w0rxbend/worxboard/pcb/production/left/README.md

# worxboard left half: JLCPCB turnkey order

Generated by `just pcb-production left` from the committed board; do not edit. CI rebuilds these files from the board and fails on any difference.

## Files

| Upload as | File | Contents |
|---|---|---|
| Gerber file | `gerbers.zip` | the panel, 198.84 x 174.75 mm: copper, mask, silk, paste, Edge.Cuts, PTH and NPTH drills |
| BOM file | `bom.csv` | 27 lines, 26 LCSC part numbers, one on every line |
| CPL file | `cpl.csv` | 201 placements, 148 on the bottom, JLC rotations and centroids applied |

`worxboard-left-jlc-order.zip` holds the same three files and this README. `bare-board/` holds the
board without the panel frame, for an order where JLC adds the rails. `pcbway/` holds the files for an
order at PCBWay instead (manufacturer part numbers, KiCad's centroids without JLC's corrections): this
`cpl.csv` misplaces parts anywhere but at JLC.

## The panel

- One board (182.84 x 158.75 mm) in a frame (198.84 x 174.75 mm, inside JLC's 250 x 250 mm Standard PCBA panel limit). The frame is solid: only a 2.0 mm slot round the board is milled out, so the board is held all round.
- Rails 6.0 mm wide or more on every side (JLC: at least 5 mm).
- 16 tabs, each with a row of Ø0.6 mm mouse-bite holes on the board edge, 1.6 mm or more from any part's courtyard and 2.1 mm or more from J1 (USB-C) and J2 (TRRS), whose mouths overhang the edge into the slot.
- 3 fiducials on each side: Ø1.0 mm copper in a Ø2.0 mm mask opening, centres 4.00 mm or more from the panel edges (JLC: 3.85 mm).
- 4 non-plated tooling holes Ø2.0 mm in the rail corners (JLC's SMT guideline of 2026-09: 2 mm; its older FAQ gives 1.152 mm, JLC adds its own if it needs others).
- Panel DRC: 0 errors, 0 unconnected items.

## PCB order form

Option names follow JLC's order form, whose wording changes now and then: pick the closest match.

| Option | Value |
|---|---|
| Base material / layers | FR-4, **4** layers |
| Dimensions | taken from the Gerbers |
| PCB qty | 5 (the minimum) |
| Product type | Industrial/Consumer electronics |
| Delivery format | **Panel by Customer**: one board per panel (1 x 1 if the form asks) |
| PCB thickness | **1.6 mm** |
| Surface finish | **ENIG** |
| Outer copper weight | 1 oz |
| Inner copper weight | 0.5 oz |
| Layer order | F.Cu (L1), In1.Cu (L2, GND plane), In2.Cu (L3, VLED plane), B.Cu (L4) |
| Impedance / stack-up | No requirement; the default JLC04161H-7628 stack-up |
| Via covering | Tented |
| Min via hole size / diameter | 0.3 mm / (0.4/0.45 mm), the default |
| Board outline tolerance | ±0.2 mm |
| Mark on PCB | none |
| Confirm production file | **Yes** |

## PCBA order form

| Option | Value |
|---|---|
| PCBA type | **Standard** (Economic places one side only) |
| Assembly side | **Both sides** |
| PCBA qty | 2 to 5 |
| Tooling holes | **Added by Customer** |
| Edge rails / fiducials | **Added by Customer** |
| Confirm parts placement | **Yes** |
| Depanel / remove edge rails | No (break the tabs yourself, see below) |

J3 (display socket, C27985230) is a through-hole part: JLC solders it by hand, so the quote carries a
small THT fee. Every other part is SMT. J1's four shell legs go through plated slots, but the paste
layer opens them (pin-in-paste), so they reflow with J1's pins; the remark asks for them as well.
Nothing is left for you to solder on the board.

## Remark

Paste this into the order's remark field. It answers what JLC's engineers would otherwise ask about,
and each question puts the order on hold:

> Panel by customer: 1 board in a frame, 6 mm rails, 3 fiducials per side, 4 tooling holes (2.0 mm).
> J1 (USB-C) and J2 (TRRS) overhang the board edge into the milled slot on purpose.
> J1 (USB-C, C165948): please solder its 4 through-hole shell legs (GND) too. The paste layer opens them for pin-in-paste.
> Bottom side: 37 hot-swap sockets SK101-SK137, 37 diodes D101-D137, 37 reverse-mount SK6812MINI-E LEDs LED101-LED137 (body in a PCB cutout, lens through to the top side) and their 100 nF caps C101-C137.
> J3 is a THT socket (hand solder).
> NPTH: 2 pairs of stabiliser clearance holes (STAB_T4/STAB_T5) leave 0.28 mm between them, under the 0.45 mm hole-to-hole spacing.
> Intended: no plating, no copper; they may break into each other.
> Ship with the frame attached.

## Placement preview: what to check

`cpl.csv` was checked by `pcb/scripts/cpl_check.py`, which places JLC's own footprint of every part
(EasyEDA / JLCEDA library) where the CPL puts it and compares it with the KiCad pads; the drawings are
`docs/images/cpl-*.svg`. JLC documents only the top side, so check the bottom side by eye:

- **Bottom, SK101-SK137** (hot-swap sockets): each socket's curved notch wraps the big round
  switch-centre hole, and its two pads sit on the two pads. A socket turned 180° also covers its
  pads but hides the centre hole under its body: rotate it 180° if you see that.
- **Bottom, D101-D137**: the cathode bar on the diode is at pad 1 (the ROW side).
- **Bottom, LED101-LED137** (SK6812MINI-E, reverse mount): the body sits in the rectangular cutout
  5 mm below each switch centre, and pin 1 (GND, the cut corner) is on KiCad pad 1. Each 100 nF
  C101-C137 sits beside its LED.
- **U1** (RP2040): the pin-1 dot at the pin-1 corner of the silkscreen.
- **U2, U3, U4, U5, U6, U7, Y1**: pin 1 on the pin-1 pad (U7 carries its own rotation: its JLC
  footprint has pin 1 in another corner than the other SOT-23-5 parts).
- **J1** (USB-C): the two plastic pegs in the two small holes, the four shell legs in their slots,
  the mouth over the back edge.
- **J2** (TRRS): the two pegs in their holes, the mouth over the bump edge.
- **J3**: on its five holes.

The bottom rows follow the convention KiKit, kicad-jlcpcb-tools and KiBot use for JLC (top-view X/Y,
rotation 180° minus the KiCad angle plus the correction). JLC does not document its bottom side.
A viewer that reads it another way shows one of two patterns:

- **Only the 55 thumb parts C101-C137, D132-D137, LED132-LED137, SK132-SK137 turned by about 50°, 180°, 130°, 50°, 180°, 130°** (the sockets several mm
  off their pads), and every other bottom part right: the viewer turns bottom parts the other
  way round. Parts at 180° look the same either way, so these 55 are the ones to look at.
  They need 360° minus the CPL value: **335°, 270°, 245°, 155°, 90°, 65°** instead of 25°, 90°, 115°, 205°, 270°, 295°.
- **Every socket and diode on the bottom turned 180°:** the viewer mirrors bottom parts about the
  other axis.

In either case, do not edit the files: ask for the correction in the placement confirmation, with
the designators and the rotation they need.

## After delivery

Break the board out of the frame at the mouse-bite tabs and file or sand each tab flush with the
board edge: the case leaves about 0.3 mm round the PCB.

## Checks run on these files

- `pcb/scripts/cpl_check.py`: every placement within 0.1 mm of the best fit of JLC's footprint onto
  the KiCad pads, pin 1 on pin 1, every terminal on its pad, the socket bodies clear of the switch
  holes.
- `pcb/scripts/jlc_check.py`: file formats and headers, BOM and CPL list the same parts, exactly the
  parts design.py fits (JP1, TP*, H*, STAB_* stay out), panel size, rails, fiducials, tooling holes.
  `--stock 5` adds a live JLC stock check; run it on the day you order.
- `pcb/scripts/jlc_check.py facts`: no two pad holes closer than 0.45 mm (JLC's pad
  hole-to-hole spacing) but the stabiliser pairs in the remark.
- KiCad DRC on the panel, and on the board itself in the PCB pipeline.
