w0rxbend/worxboard/pcb/production/left/pcbway/README.md

# worxboard left half: PCBWay turnkey order

Generated by `just pcb-pcbway left` (part of `just pcb-production left`) from the committed board, `pcb/scripts/design.py` and `pcb/scripts/mpn.json`; do not edit. CI rebuilds these files and fails on any difference.

Do **not** upload the JLC files one directory up (`../bom.csv`, `../cpl.csv`) to PCBWay: the CPL carries JLC-only corrections (`pcb/scripts/jlc_rotations.csv`) and JLC's bottom-side rotation, and the BOM only LCSC numbers. Only the Gerbers are shared.

## Files

| PCBWay upload | File | Contents |
|---|---|---|
| Gerber file | [`../gerbers.zip`](../gerbers.zip) | the **panel**, 198.84 x 174.75 mm: the board in a frame with 6 mm rails, 16 mouse-bite tabs, 3 fiducials per side, 4 tooling holes |
| BOM | [`bom.csv`](bom.csv) | 26 lines, 201 parts: manufacturer and part number, description, package, SMD/THT, side, LCSC number as an alternate source |
| Centroid (pick and place) | [`centroid-panel.csv`](centroid-panel.csv) | 201 placements, 148 on the bottom, in the panel Gerbers' frame |

Upload the panel. J1 (USB-C) and J2 (TRRS) overhang the board edge by design, into the frame's 2.0 mm milled slot; the frame carries the rails, fiducials and tooling holes and has no tab in front of either connector. Only if PCBWay refuses the panel, upload [`../bare-board/gerbers.zip`](../bare-board/gerbers.zip) (182.84 x 158.75 mm) with [`centroid-bare-board.csv`](centroid-bare-board.csv), choose Board type **Single pieces**, and ask in the remark for break-away rails with a routed gap and mouse-bites, no V-cut, and no rail or tab in front of J1 and J2.

## Coordinates and rotations

Both centroid files are KiCad's own position file (`kicad-cli pcb export pos --use-drill-file-origin`, millimetres) of the panel and of the board, unchanged but for the column names and the rotation written as 0-360°:

- **Origin:** the drill/place origin, which is the origin of the matching Gerbers: the panel's top-left corner for `centroid-panel.csv`, the board's coordinate origin for `centroid-bare-board.csv`. Y points up, as in the Gerbers, so the Y values are negative.
- **Panel offset:** each panel centroid is the bare-board one moved by (-46.0822, +22.6000) mm, the KiKit panel's offset, read from the panel this stage builds.
- **Mid X / Mid Y** is each footprint's KiCad origin, with no correction. For most parts it is the body centre. Not for these, whose pads are centred this far from the origin: J1 (1.5 mm), J2 (0.9 mm), J3 (5.1 mm), SK101-SK137 (3.9 mm). Place them by their pads.
- **Rotation** is KiCad's footprint angle, counter-clockwise, with KiCad's library footprint as 0°. That is not always the zero orientation of IPC-7351 or of the part on its tape (for J2, J3, SK101-SK137, U2-U7 it is not: JLC's CPL turns them by 90°, 180° or 270°), so align each part with its pads and polarity marks.
- **Bottom side** (Layer `Bottom`): X and Y are seen from the top, through the board (X not negated), in the same frame as the Gerbers. The rotation is KiCad's: seen from the top, the part is its library footprint mirrored top to bottom, then turned counter-clockwise by the Rotation value. Seen from the bottom (the board turned over about its vertical axis), it is the footprint turned counter-clockwise by **180° minus the Rotation value**, the number bottom-view tools such as JLC's use.

## PCB order form

Option names as on PCBWay's form in 2026-11; pick the closest match if they change.

| Option | Value |
|---|---|
| Board type | **Panel by Customer** |
| Panel requirements | Route process **Panel as Tab Route**; X-out allowance **Not Accept**; break-away rail **Yes** (the frame in the Gerbers is the rail); different design in panel **1** |
| Size | 198.84 x 174.75 mm (the panel, from the Gerbers) |
| Quantity | 5 (the minimum) |
| Layers | **4** |
| Material | FR-4, TG 130-140 (the default) |
| Thickness | **1.6 mm** |
| Min track/spacing | **5/5mil** (narrowest track 0.150 mm, clearance rule 0.127 mm) |
| Min hole size | **0.3mm ↑** (smallest drill 0.30 mm) |
| Solder mask | any colour (green is the default) |
| Silkscreen | **White** |
| UV printing (multi-colour) | **None** |
| Edge connector | No |
| Surface finish | **Immersion gold (ENIG)**, 1U" |
| Via process | **Tenting vias** |
| Finished copper | **1 oz Cu** outer, 0.5 oz inner |
| Layer order | F.Cu (L1), In1.Cu (L2, GND plane), In2.Cu (L3, VLED plane), B.Cu (L4); standard stack-up, no impedance control |
| Remove product No. | Yes (extra charge) for no PCBWay number on the board; No lets PCBWay print it |
| Other special request (200 characters at most) | `Panel by customer: 1 board in a frame, tab-route mouse-bites, no V-cut. J1/J2 overhang the board edge into the slot on purpose. Close NPTH stab hole pairs intended. Ship in the frame.` |

## Assembly form

| Option | Value |
|---|---|
| Service type | **Turnkey** |
| Board type | **Panelized PCBs** (Single pieces for the bare board) |
| Assembly side(s) | **Both sides** |
| Quantity | 2 to 5 boards (one board per panel) |
| Accept alternatives/substitutes made in China | Yes, within the substitution rules below |
| Function test / Firmware loading | No / No (the firmware goes on over USB, see the build guide) |
| Number of unique parts | 26 |
| Number of SMD parts | 200 |
| Number of BGA/QFP parts | 1 (U1: QFN-56-1EP_7x7mm_P0.4mm_EP3.2x3.2mm, no BGA) |
| Number of through-hole parts | 1 (J3) |
| Depanel the boards to delivery | **No** (ship in the frame; break the tabs yourself) |

## Remark

Paste this into the assembly order's notes (or send it to the PCBWay engineer who reviews the files). It answers what they would otherwise ask, and each question holds the order:

> Turnkey PCBA, both sides, 201 placements: 53 top, 148 bottom (37 x CL05B104KO5NNNC C101-C137, 37 x 1N4148W D101-D137, 37 x SK6812MINI-E LED101-LED137, 37 x CPG151101S11-16 SK101-SK137).
> Gerbers: 1 board in a customer panel (frame, 6 mm rails, 3 fiducials per side, 4 NPTH tooling holes 2.0 mm, mouse-bite tabs, no V-cut). Ship with the frame attached.
> J1 (USB-C) and J2 (TRRS) overhang the board edge into the milled slot on purpose.
> J3 is the only through-hole part (top side): please hand-solder it.
> J1 (TYPE-C-31-M-12): its 4 plated through-hole legs are opened in the paste layer (pin-in-paste); please solder them too.
> Centroid: KiCad's own position file (footprint origins, KiCad rotations, no offsets added), X/Y in the Gerber frame seen from the top. Bottom-side rotations are KiCad's: seen from the bottom, a part is turned by 180 deg minus the value.
> Please send the placement of both sides (orientation and polarity) for confirmation before production.
> Substitutes: J3: only a 1x5, 2.54 mm pitch, single-row through-hole female header with a 5.0 mm body: the display height in the case depends on it; otherwise ask. Y1: 12MHz, 3225 four-pad, CL 18 pF, ±20 ppm or better; otherwise ask. SK101-SK137: only the second source HanElectricity CPG151101S11-2 (LCSC C49352235), same land pattern; otherwise ask. LED101-LED137: only an SK6812MINI-E (3.2 x 2.8 mm reverse-mount, the same pinout): the PCB cutout and pads are made for it; otherwise ask. C1-C22, C101-C137, F1, R1-R16: any equivalent of the same value, size and rating. D1, D101-D137: the same diode type from another maker, same package, same or better ratings. SW1, SW2: a tact switch on the same TS-1088 land pattern; otherwise ask. No substitute for J1, J2, U1-U7: ask first.
> NPTH: 2 pairs of stabiliser clearance holes (STAB_T4/STAB_T5) leave 0.28 mm between them, under the 0.45 mm hole-to-hole spacing.
> Intended: no plating, no copper; they may break into each other.

## Substitution rules

| Designators | BOM part | Substitute |
|---|---|---|
| C1-C3, C20, C21 | Samsung Electro-Mechanics CL10A106KP8NNNC | any MLCC of the same value, size, dielectric and tolerance, same or higher voltage |
| C4, C18, C19 | Samsung Electro-Mechanics CL05A105KA5NQNC | any MLCC of the same value, size, dielectric and tolerance, same or higher voltage |
| C5, C8-C17, C22, C101-C137 | Samsung Electro-Mechanics CL05B104KO5NNNC | any MLCC of the same value, size, dielectric and tolerance, same or higher voltage |
| C6, C7 | FH 0402CG270J500NT | any MLCC of the same value, size, dielectric and tolerance, same or higher voltage |
| D1 | JSCJ B5819W SL | the same diode type from another maker, same package, same or better ratings |
| D101-D137 | ST(Semtech) 1N4148W | the same diode type from another maker, same package, same or better ratings |
| F1 | TECHFUSE nSMD050-24V | any PTC fuse of the same size and hold current, same or higher voltage |
| J1 | Korean Hroparts Elec TYPE-C-31-M-12 | no substitute: ask first |
| J2 | Korean Hroparts Elec PJ-320D-4A | no substitute: ask first |
| J3 | Hong Cheng HC-PM254-5.0H-1x5PZ | only a 1x5, 2.54 mm pitch, single-row through-hole female header with a **5.0 mm** body: the display height in the case depends on it; otherwise ask |
| LED101-LED137 | OPSCO Optoelectronics SK6812MINI-E | only an SK6812MINI-E (3.2 x 2.8 mm reverse-mount, the same pinout): the PCB cutout and pads are made for it; otherwise ask |
| R1, R2 | UNI-ROYAL 0402WGF5101TCE | any resistor of the same value, size, tolerance and power rating or better |
| R3, R4 | FOJAN FRC0402F27R0TS | any resistor of the same value, size, tolerance and power rating or better |
| R5, R6, R8, R10, R13, R15 | UNI-ROYAL 0402WGF1002TCE | any resistor of the same value, size, tolerance and power rating or better |
| R7, R9 | UNI-ROYAL 0402WGF1001TCE | any resistor of the same value, size, tolerance and power rating or better |
| R11, R12, R16 | UNI-ROYAL 0402WGF4700TCE | any resistor of the same value, size, tolerance and power rating or better |
| R14 | UNI-ROYAL 0402WGF1502TCE | any resistor of the same value, size, tolerance and power rating or better |
| SK101-SK137 | HanElectricity CPG151101S11-16 | only the second source HanElectricity CPG151101S11-2 (LCSC C49352235), same land pattern; otherwise ask |
| SW1, SW2 | XUNPU TS-1088R-02026 | a tact switch on the same TS-1088 land pattern; otherwise ask |
| U1 | Raspberry Pi RP2040 | no substitute: ask first |
| U2 | Winbond W25Q128JVSIQ | no substitute: ask first |
| U3 | DIODES AP2112K-3.3TRG1 | no substitute: ask first |
| U4, U5 | ST USBLC6-2SC6 | no substitute: ask first |
| U6 | Silergy SY6280AAC | no substitute: ask first |
| U7 | TI SN74LV1T34DBVR | no substitute: ask first |
| Y1 | YXC Crystal Oscillators XL2EL89CRI-111YLC-12M | 12MHz, 3225 four-pad, CL 18 pF, ±20 ppm or better; otherwise ask |

## Placement confirmation: what to check

- **Bottom** (C101-C137, D101-D137, LED101-LED137, SK101-SK137): each hot-swap socket's curved notch wraps the round switch-centre hole and its two terminals sit on the two pads; each diode's cathode band is at pad 1 (the ROW side).
- **U1-U7, Y1**: the pin-1 mark (dot, bevel or corner) at pad 1 and the pin-1 mark of the silkscreen; **D1**: the cathode band at pad 1.
- **J1** (USB-C) and **J2** (TRRS): the pegs in their holes, the mouths over the board edge.
- **J3**: on its five holes, on the top side.

## Checks run on these files

- Designators: the 201 parts of the JLC BOM, which are exactly the parts `design.py` fits, each with its LCSC number; every LCSC number in `design.py` has a manufacturer part number in `pcb/scripts/mpn.json` (`pcb/scripts/mpn.py check`).
- Every centroid lies inside the Edge.Cuts of its Gerber set; the panel centroids are the bare-board ones moved by (-46.0822, +22.6000) mm.
- Against the JLC CPL: the 154 parts whose footprint has no row in `pcb/scripts/jlc_rotations.csv` sit where the JLC CPL puts them (within 0.01 mm, worst 0.0067 mm, panel and bare board), and re-applying the row to the other 47 gives the JLC CPL too: the files differ only by JLC's documented corrections and bottom-side rotation.
