w0rxbend/worxboard/pcb/production/left/bare-board/README.md

# worxboard left half: JLCPCB turnkey order (bare board, JLC-added rails)

Generated by `just pcb-production left` from the committed board; do not edit. CI rebuilds these files from the board and fails on any difference.

The bare board (182.84 x 158.75 mm) without rails. Prefer the panel one directory up;
use these only if you want JLC to add the assembly rails and fiducials.

| Upload | File |
|---|---|
| Gerber file | `gerbers.zip` |
| BOM file | `bom.csv` |
| CPL file | `cpl.csv` |

Form differences from the panel order: Delivery format **Single PCB**; Edge rails/fiducials
**Added by JLCPCB**; Tooling holes **Added by JLCPCB**. Paste this as the PCB remark:

> Standard PCBA, both sides. Please add the assembly edge rails with a >= 2 mm routed gap and
> mouse-bite tabs (no V-cut). J1 (USB-C) overhangs the back edge by 0.5 mm and J2 (TRRS) the
> bump edge: no rail or tab in front of J1/J2. Keep tooling holes and fiducials on the rails
> only, no holes inside the board outline. Deliver with rails attached.
> J1 (USB-C, C165948): please solder its 4 through-hole shell legs (GND) too. The paste layer opens them for pin-in-paste.
> NPTH: 2 pairs of stabiliser clearance holes (STAB_T4/STAB_T5) leave 0.28 mm between them, under the 0.45 mm hole-to-hole spacing.
> Intended: no plating, no copper; they may break into each other.

Everything else (settings, preview checks, after delivery) is as in `../README.md`.
