w0rxbend/worxboard/docs/pinout.md

<!-- GENERATED by site/gen_docs.py from layout/build/layout.json, pcb/scripts/design.py and pcb/<side>/worxboard-<side>.kicad_pcb. Do not edit: run `just docs-gen`. -->

# Pinout

The RP2040 GPIO map is identical on both PCBs (spec §3, `layout/pins.py`). Symbol pin **names** are the authority; QFN pin numbers are informational. Electrical context is in [electrical.md](electrical.md), the key matrix in [matrix.md](matrix.md).

## RP2040 pins

| Pin | QFN | Net | Notes |
|---|---|---|---|
| `GPIO0` | 2 | `UART_TX` | UART0 TX -> 1k -> jack |
| `GPIO1` | 3 | `UART_RX` | UART0 RX <- 1k <- jack; 10k pull-up to 3V3 |
| `GPIO2` | 4 | `DISP_SCK` | PIO1 SPI clock |
| `GPIO3` | 5 | `DISP_MOSI` | PIO1 SPI data |
| `GPIO4` | 6 | `DISP_DC` | TP1 (future TFT) |
| `GPIO5` | 7 | `DISP_CS` | display CS, active high |
| `GPIO6` | 8 | `DISP_RST` | TP2 (future TFT) |
| `GPIO7` | 9 | `DISP_BL` | TP3 (future TFT backlight) |
| `GPIO8` | 11 | `ROW0` | matrix row, pull-down |
| `GPIO9` | 12 | `ROW1` | matrix row, pull-down |
| `GPIO10` | 13 | `ROW2` | matrix row, pull-down |
| `GPIO11` | 14 | `ROW3` | matrix row, pull-down |
| `GPIO12` | 15 | `ROW4` | matrix row, pull-down |
| `GPIO13` | 16 | `ROW5` | matrix row, pull-down |
| `GPIO14` | 17 | `COL0` | matrix column |
| `GPIO15` | 18 | `COL1` | matrix column |
| `GPIO16` | 27 | `COL2` | matrix column |
| `GPIO17` | 28 | `COL3` | matrix column |
| `GPIO18` | 29 | `COL4` | matrix column |
| `GPIO19` | 30 | `COL5` | matrix column |
| `GPIO20` | 31 | `COL6` | matrix column |
| `GPIO21` | 32 | `TRRS_DET` | test pad (future detect-gpios) |
| `GPIO22` | 34 | `RGB_DIN` | per-key RGB data (PIO0 WS2812) -> U7 level shifter |
| `GPIO23` | 35 | `RGB_EN` | U6 VLED switch enable, active high, 10k pull-down |
| `GPIO24` | 36 | `TP6` | spare |
| `GPIO25` | 37 | `TP7` | spare |
| `GPIO26/ADC0` | 38 | `VBUS_SENSE` | VBUS 10k/10k divider, unused by rev A |
| `GPIO27/ADC1` | 39 | n/c |  |
| `GPIO28/ADC2` | 40 | n/c |  |
| `GPIO29/ADC3` | 41 | n/c |  |
| `~{QSPI_SS}` | 56 | `QSPI_SS` | flash CS, 10k pull-up; BOOT -> 1k -> GND |
| `RUN` | 26 | `RUN` | 10k pull-up; RESET -> GND |
| `SWCLK` | 24 | `SWCLK` | SWD test pad |
| `SWDIO` | 25 | `SWDIO` | SWD test pad |
| `TESTEN` | 19 | `GND` |  |
| `XIN` | 20 | `XIN` | 12 MHz crystal |
| `XOUT` | 21 | `XOUT` | 1k series to crystal |
| `USB_DM` | 46 | `USB_DM` | 27R series |
| `USB_DP` | 47 | `USB_DP` | 27R series |

## Matrix GPIOs

Rows are inputs with an internal pull-down; columns are outputs (`col2row`). Both PCBs use the same nets. The right half's `.dts` lists the column GPIOs in reverse, so its logical column 0 is the inner column, and `col-offset = <7>` puts it at global column 7.

| Row net | GPIO | QFN |
|---|---|---|
| `ROW0` | GP8 | 11 |
| `ROW1` | GP9 | 12 |
| `ROW2` | GP10 | 13 |
| `ROW3` | GP11 | 14 |
| `ROW4` | GP12 | 15 |
| `ROW5` | GP13 | 16 |

| Col net | Physical column | GPIO | Left logical | Left global | Right logical | Right global |
|---|---|---|---|---|---|---|
| `COL0` | C0 (outer) | GP14 | 0 | 0 | 6 | 13 |
| `COL1` | C1 | GP15 | 1 | 1 | 5 | 12 |
| `COL2` | C2 | GP16 | 2 | 2 | 4 | 11 |
| `COL3` | C3 | GP17 | 3 | 3 | 3 | 10 |
| `COL4` | C4 | GP18 | 4 | 4 | 2 | 9 |
| `COL5` | C5 | GP19 | 5 | 5 | 1 | 8 |
| `COL6` | C6 (inner) | GP20 | 6 | 6 | 0 | 7 |

## TRRS (split link)

UART0, GP0 TX and GP1 RX at 115200 baud, ZMK `zmk,wired-split`. Use a **straight** 4-pole cable: the TX/RX crossover is in the PCB netlist, so the firmware pinctrl is the same on both halves. **Never plug or unplug the TRRS cable while either half is powered.**

| Contact | Left PCB | Right PCB |
|---|---|---|
| Tip | `TRRS_A` = **UART_TX** | `TRRS_A` = **UART_RX** |
| Ring1 | `TRRS_B` = **UART_RX** | `TRRS_B` = **UART_TX** |
| Ring2 | `VLINK` | `VLINK` |
| Sleeve | `GND` | `GND` |

## Display header J3

1×5 2.54 mm female socket, 5.0 mm tall (C27985230), fitted by JLC as a through-hole part. Pin *n* is nice!view pin *n*. Pin 1 (MOSI) is at **high x** in each half's own frame: the **outer** end of the socket on the right half and the **inner** end on the left, because the module is one part mounted LCD up the same way on both halves, header at the back (deviation BOARD-1). `netcmp.py --board` stops stages C and D if J3 is turned the wrong way (deviation ELEC-8; [verification.md](verification.md#g1-niceview-display)).

| Pin | Function | Net | GPIO | Right frame (mm) | Left frame (mm) |
|---|---|---|---|---|---|
| 1 | MOSI | `DISP_MOSI` | GP3 | (77.47, 38.925) | (192.69, 38.925) |
| 2 | SCK | `DISP_SCK` | GP2 | (74.93, 38.925) | (190.15, 38.925) |
| 3 | VCC | `3V3` | — | (72.39, 38.925) | (187.61, 38.925) |
| 4 | GND | `GND` | — | (69.85, 38.925) | (185.07, 38.925) |
| 5 | CS | `DISP_CS` | GP5 | (67.31, 38.925) | (182.53, 38.925) |

## Part positions

Footprint origins as placed in the committed boards (`pcb/<side>/worxboard-<side>.kicad_pcb`), KiCad frame of each half in mm (+y towards the user). The left half is the mirror image (x_L = 260 − x_R) except where the board needed otherwise: the left RP2040 and flash are turned 180° and moved (deviations WS2b-1, WS2b-2), so the passives around them differ too. All of these parts are on the top side. Key sockets and diodes are listed in [matrix.md](matrix.md#sockets-and-diodes).

| Ref | Value | Nets | Left (x, y) rot | Right (x, y) rot |
|---|---|---|---|---|
| `C1` | 10u | `GND`, `VSYS` | (63.9, 44.2) 90° | (196.1, 44.2) 90° |
| `C2` | 10u | `GND`, `VSYS` | (74.27, 44.64) -118.5° | (179.79, 35.7) 90° |
| `C3` | 10u | `3V3`, `GND` | (57.2, 45.2) 90° | (202.8, 45.2) 90° |
| `C4` | 1u | `3V3`, `GND` | (57.2, 48) 90° | (202.8, 48) 90° |
| `C5` | 100n | `3V3`, `GND` | (90, 55.4) 90° | (160.6, 33.2) 90° |
| `C6` | 27p | `GND`, `XIN` | (96.7, 33) -90° | (165, 56.2) 0° |
| `C7` | 27p | `GND`, `XTAL_OUT` | (89.2, 32.6) -90° | (167.2, 56.2) 0° |
| `C8` | 100n | `3V3`, `GND` | (98.85, 46.3) 0° | (160.55, 39.7) 180° |
| `C9` | 100n | `3V3`, `GND` | (98.85, 47.6) 0° | (160.55, 38.4) 180° |
| `C10` | 100n | `3V3`, `GND` | (88.6, 48.08) -90° | (170.8, 37.92) 90° |
| `C11` | 100n | `3V3`, `GND` | (86.1, 44.12) 90° | (173.3, 41.88) -90° |
| `C12` | 100n | `3V3`, `GND` | (84.6, 44.12) 90° | (174.8, 41.88) -90° |
| `C13` | 100n | `3V3`, `GND` | (89.8, 48.08) -90° | (169.6, 37.92) 90° |
| `C14` | 100n | `3V3`, `GND` | (92.2, 48.08) -90° | (167.2, 37.92) 90° |
| `C15` | 100n | `3V3`, `GND` | (91, 48.08) -90° | (168.4, 37.92) 90° |
| `C16` | 100n | `1V1`, `GND` | (94.45, 49.6) -90° | (164.95, 36.4) 90° |
| `C17` | 100n | `1V1`, `GND` | (90.95, 33.6) 90° | (168.45, 52.4) -90° |
| `C18` | 1u | `3V3`, `GND` | (87.6, 44.12) 90° | (171.8, 41.88) -90° |
| `C19` | 1u | `1V1`, `GND` | (93.35, 49.6) -90° | (166.05, 36.4) 90° |
| `C20` | 10u | `GND`, `VLED` | (55.6, 50.6) 90° | (198.4, 50.6) 90° |
| `C21` | 10u | `GND`, `VSYS` | (61.6, 50.6) 90° | (204.4, 50.6) 90° |
| `C22` | 100n | `GND`, `VLED` | (63.51, 51.31) 0° | (187.95, 43.71) 90° |
| `C101` | 100n | `GND`, `VLED` | (73.15, 72.09) 90° | (186.85, 72.09) -90° |
| `C102` | 100n | `GND`, `VLED` | (96.96, 72.09) 90° | (163.04, 72.09) -90° |
| `C103` | 100n | `GND`, `VLED` | (116.01, 68.91) 90° | (143.99, 68.91) -90° |
| `C104` | 100n | `GND`, `VLED` | (135.06, 67.31) 90° | (124.94, 67.31) -90° |
| `C105` | 100n | `GND`, `VLED` | (154.11, 68.91) 90° | (105.89, 68.91) -90° |
| `C106` | 100n | `GND`, `VLED` | (173.16, 70.18) 90° | (86.84, 70.18) -90° |
| `C107` | 100n | `GND`, `VLED` | (183.01, 93.99) -90° | (76.99, 93.99) 90° |
| `C108` | 100n | `GND`, `VLED` | (163.96, 89.23) -90° | (96.04, 89.23) 90° |
| `C109` | 100n | `GND`, `VLED` | (144.91, 87.96) -90° | (115.09, 87.96) 90° |
| `C110` | 100n | `GND`, `VLED` | (125.86, 86.36) -90° | (134.14, 86.36) 90° |
| `C111` | 100n | `GND`, `VLED` | (106.81, 87.96) -90° | (153.19, 87.96) 90° |
| `C112` | 100n | `GND`, `VLED` | (87.76, 91.13) -90° | (172.24, 91.13) 90° |
| `C113` | 100n | `GND`, `VLED` | (63.95, 91.13) -90° | (186.85, 91.13) -90° |
| `C114` | 100n | `GND`, `VLED` | (73.15, 110.18) 90° | (186.85, 110.18) -90° |
| `C115` | 100n | `GND`, `VLED` | (96.96, 110.18) 90° | (163.04, 110.18) -90° |
| `C116` | 100n | `GND`, `VLED` | (116.01, 107.01) 90° | (143.99, 107.01) -90° |
| `C117` | 100n | `GND`, `VLED` | (135.06, 105.41) 90° | (124.94, 105.41) -90° |
| `C118` | 100n | `GND`, `VLED` | (154.11, 107.01) 90° | (105.89, 107.01) -90° |
| `C119` | 100n | `GND`, `VLED` | (173.16, 108.28) 90° | (86.84, 108.28) -90° |
| `C120` | 100n | `GND`, `VLED` | (183.01, 122.57) -90° | (76.99, 122.57) 90° |
| `C121` | 100n | `GND`, `VLED` | (163.96, 127.33) -90° | (96.04, 127.33) 90° |
| `C122` | 100n | `GND`, `VLED` | (144.91, 126.06) -90° | (115.09, 126.06) 90° |
| `C123` | 100n | `GND`, `VLED` | (125.86, 124.46) -90° | (134.14, 124.46) 90° |
| `C124` | 100n | `GND`, `VLED` | (106.81, 126.06) -90° | (153.19, 126.06) 90° |
| `C125` | 100n | `GND`, `VLED` | (87.76, 129.23) -90° | (172.24, 129.23) 90° |
| `C126` | 100n | `GND`, `VLED` | (63.95, 129.23) -90° | (186.85, 129.23) -90° |
| `C127` | 100n | `GND`, `VLED` | (77.91, 148.28) 90° | (182.09, 148.28) -90° |
| `C128` | 100n | `GND`, `VLED` | (96.96, 148.28) 90° | (163.04, 148.28) -90° |
| `C129` | 100n | `GND`, `VLED` | (116.01, 145.11) 90° | (143.99, 145.11) -90° |
| `C130` | 100n | `GND`, `VLED` | (135.06, 143.51) 90° | (124.94, 143.51) -90° |
| `C131` | 100n | `GND`, `VLED` | (154.11, 145.11) 90° | (105.89, 145.11) -90° |
| `C132` | 100n | `GND`, `VLED` | (180.72, 159.61) 65° | (79.28, 159.61) -65° |
| `C133` | 100n | `GND`, `VLED` | (197.98, 167.67) 65° | (62.02, 167.67) -65° |
| `C134` | 100n | `GND`, `VLED` | (211.22, 184.35) 65° | (57.12, 180.46) 115° |
| `C135` | 100n | `GND`, `VLED` | (219.27, 167.08) 65° | (49.06, 163.19) 115° |
| `C136` | 100n | `GND`, `VLED` | (218.99, 145.93) -115° | (41.01, 145.93) 115° |
| `C137` | 100n | `GND`, `VLED` | (201.72, 137.88) -115° | (58.28, 137.88) 115° |
| `D1` | B5819W | `VBUS`, `VSYS` | (66.4, 44.2) 90° | (193.6, 44.2) 90° |
| `F1` | 500mA | `VLINK`, `VLINK_JP` | (67.2, 52.8) 180° | (192.8, 52.8) 0° |
| `J1` | TYPE-C-31-M-12 | `CC1`, `CC2`, `GND`, `USB_C_DM`, `USB_C_DP`, `VBUS` | (74, 34.25) 180° | (186, 34.25) 180° |
| `J2` | PJ-320D-4A | `GND`, `TRRS_A`, `TRRS_B`, `VLINK` | (202.62, 103) 180° | (57.38, 103) 0° |
| `J3` | HC-PM254-5.0H-1x5PZ | `3V3`, `DISP_CS`, `DISP_MOSI`, `DISP_SCK`, `GND` | (192.69, 38.92) -90° | (77.47, 38.92) -90° |
| `JP1` | VLINK | `VLINK_JP`, `VSYS` | (73.4, 51.6) 180° | (186.6, 51.6) 0° |
| `LED101` | SK6812MINI-E | `GND`, `RGB_D101`, `RGB_D102`, `VLED` | (68.55, 72.09) 0° | (191.45, 72.09) 180° |
| `LED102` | SK6812MINI-E | `GND`, `RGB_D102`, `RGB_D103`, `VLED` | (92.36, 72.09) 0° | (167.64, 72.09) 180° |
| `LED103` | SK6812MINI-E | `GND`, `RGB_D103`, `RGB_D104`, `VLED` | (111.41, 68.91) 0° | (148.59, 68.91) 180° |
| `LED104` | SK6812MINI-E | `GND`, `RGB_D104`, `RGB_D105`, `VLED` | (130.46, 67.31) 0° | (129.54, 67.31) 180° |
| `LED105` | SK6812MINI-E | `GND`, `RGB_D105`, `RGB_D106`, `VLED` | (149.51, 68.91) 0° | (110.49, 68.91) 180° |
| `LED106` | SK6812MINI-E | `GND`, `RGB_D106`, `RGB_D107`, `VLED` | (168.56, 70.18) 0° | (91.44, 70.18) 180° |
| `LED107` | SK6812MINI-E | `GND`, `RGB_D107`, `RGB_D108`, `VLED` | (187.61, 93.99) 180° | (72.39, 93.99) 0° |
| `LED108` | SK6812MINI-E | `GND`, `RGB_D108`, `RGB_D109`, `VLED` | (168.56, 89.23) 180° | (91.44, 89.23) 0° |
| `LED109` | SK6812MINI-E | `GND`, `RGB_D109`, `RGB_D110`, `VLED` | (149.51, 87.96) 180° | (110.49, 87.96) 0° |
| `LED110` | SK6812MINI-E | `GND`, `RGB_D110`, `RGB_D111`, `VLED` | (130.46, 86.36) 180° | (129.54, 86.36) 0° |
| `LED111` | SK6812MINI-E | `GND`, `RGB_D111`, `RGB_D112`, `VLED` | (111.41, 87.96) 180° | (148.59, 87.96) 0° |
| `LED112` | SK6812MINI-E | `GND`, `RGB_D112`, `RGB_D113`, `VLED` | (92.36, 91.13) 180° | (167.64, 91.13) 0° |
| `LED113` | SK6812MINI-E | `GND`, `RGB_D113`, `RGB_D114`, `VLED` | (68.55, 91.13) 180° | (191.45, 91.13) 180° |
| `LED114` | SK6812MINI-E | `GND`, `RGB_D114`, `RGB_D115`, `VLED` | (68.55, 110.18) 0° | (191.45, 110.18) 180° |
| `LED115` | SK6812MINI-E | `GND`, `RGB_D115`, `RGB_D116`, `VLED` | (92.36, 110.18) 0° | (167.64, 110.18) 180° |
| `LED116` | SK6812MINI-E | `GND`, `RGB_D116`, `RGB_D117`, `VLED` | (111.41, 107.01) 0° | (148.59, 107.01) 180° |
| `LED117` | SK6812MINI-E | `GND`, `RGB_D117`, `RGB_D118`, `VLED` | (130.46, 105.41) 0° | (129.54, 105.41) 180° |
| `LED118` | SK6812MINI-E | `GND`, `RGB_D118`, `RGB_D119`, `VLED` | (149.51, 107.01) 0° | (110.49, 107.01) 180° |
| `LED119` | SK6812MINI-E | `GND`, `RGB_D119`, `RGB_D120`, `VLED` | (168.56, 108.28) 0° | (91.44, 108.28) 180° |
| `LED120` | SK6812MINI-E | `GND`, `RGB_D120`, `RGB_D121`, `VLED` | (187.61, 122.57) 180° | (72.39, 122.57) 0° |
| `LED121` | SK6812MINI-E | `GND`, `RGB_D121`, `RGB_D122`, `VLED` | (168.56, 127.33) 180° | (91.44, 127.33) 0° |
| `LED122` | SK6812MINI-E | `GND`, `RGB_D122`, `RGB_D123`, `VLED` | (149.51, 126.06) 180° | (110.49, 126.06) 0° |
| `LED123` | SK6812MINI-E | `GND`, `RGB_D123`, `RGB_D124`, `VLED` | (130.46, 124.46) 180° | (129.54, 124.46) 0° |
| `LED124` | SK6812MINI-E | `GND`, `RGB_D124`, `RGB_D125`, `VLED` | (111.41, 126.06) 180° | (148.59, 126.06) 0° |
| `LED125` | SK6812MINI-E | `GND`, `RGB_D125`, `RGB_D126`, `VLED` | (92.36, 129.23) 180° | (167.64, 129.23) 0° |
| `LED126` | SK6812MINI-E | `GND`, `RGB_D126`, `RGB_D127`, `VLED` | (68.55, 129.23) 180° | (191.45, 129.23) 180° |
| `LED127` | SK6812MINI-E | `GND`, `RGB_D127`, `RGB_D128`, `VLED` | (73.31, 148.28) 0° | (186.69, 148.28) 180° |
| `LED128` | SK6812MINI-E | `GND`, `RGB_D128`, `RGB_D129`, `VLED` | (92.36, 148.28) 0° | (167.64, 148.28) 180° |
| `LED129` | SK6812MINI-E | `GND`, `RGB_D129`, `RGB_D130`, `VLED` | (111.41, 145.11) 0° | (148.59, 145.11) 180° |
| `LED130` | SK6812MINI-E | `GND`, `RGB_D130`, `RGB_D131`, `VLED` | (130.46, 143.51) 0° | (129.54, 143.51) 180° |
| `LED131` | SK6812MINI-E | `GND`, `RGB_D131`, `RGB_D132`, `VLED` | (149.51, 145.11) 0° | (110.49, 145.11) 180° |
| `LED132` | SK6812MINI-E | `GND`, `RGB_D132`, `RGB_D133`, `VLED` | (176.55, 157.67) -25° | (83.45, 157.67) -155° |
| `LED133` | SK6812MINI-E | `GND`, `RGB_D133`, `RGB_D134`, `VLED` | (193.81, 165.72) -25° | (66.19, 165.72) -155° |
| `LED134` | SK6812MINI-E | `GND`, `RGB_D134`, `RGB_D135`, `VLED` | (207.05, 182.4) -25° | (52.95, 182.4) 25° |
| `LED135` | SK6812MINI-E | `GND`, `RGB_D135`, `RGB_D136`, `VLED` | (215.1, 165.14) -25° | (44.9, 165.14) 25° |
| `LED136` | SK6812MINI-E | `GND`, `RGB_D136`, `RGB_D137`, `VLED` | (223.15, 147.87) 155° | (36.85, 147.87) 25° |
| `LED137` | SK6812MINI-E | `GND`, `RGB_D137`, `VLED` | (205.89, 139.82) 155° | (54.11, 139.82) 25° |
| `R1` | 5.1k | `CC1`, `GND` | (80.5, 39.6) 0° | (189.4, 42.4) 90° |
| `R2` | 5.1k | `CC2`, `GND` | (70.2, 43.4) 0° | (183.4, 43.2) 0° |
| `R3` | 27 | `USB_C_DP`, `USB_DP` | (86.9, 47.12) 0° | (172.5, 38.88) 180° |
| `R4` | 27 | `USB_C_DM`, `USB_DM` | (86.9, 46.08) 0° | (172.5, 39.92) 180° |
| `R5` | 10k | `VBUS`, `VBUS_SENSE` | (69.4, 47.6) 90° | (190.6, 47.6) 90° |
| `R6` | 10k | `GND`, `VBUS_SENSE` | (69.4, 50.4) 90° | (190.6, 50.4) 90° |
| `R7` | 1k | `XOUT`, `XTAL_OUT` | (92, 33.6) -90° | (167.4, 52.4) 90° |
| `R8` | 10k | `3V3`, `QSPI_SS` | (89, 52.6) 90° | (147, 33.4) 90° |
| `R9` | 1k | `BOOT`, `QSPI_SS` | (87.8, 52.6) 90° | (145.8, 33.4) 90° |
| `R10` | 10k | `3V3`, `RUN` | (77.4, 47.6) 90° | (182.6, 47.6) 90° |
| `R11` | 470 | left `TRRS_A`, `UART_TX`; right `TRRS_A`, `UART_RX` | (198.6, 94.8) 90° | (61.4, 94.8) 90° |
| `R12` | 470 | left `TRRS_B`, `UART_RX`; right `TRRS_B`, `UART_TX` | (200.2, 94.8) 90° | (59.8, 94.8) 90° |
| `R13` | 10k | `3V3`, `UART_RX` | (115, 46) 180° | (145, 46) 0° |
| `R14` | 15k | `GND`, `VLED_ISET` | (57.2, 54) 0° | (200, 54) 0° |
| `R15` | 10k | `GND`, `RGB_EN` | (60.2, 54) 0° | (203, 54) 0° |
| `R16` | 470 | `RGB_BUF`, `RGB_D101` | (63.65, 46.64) 0° | (189, 49.4) 90° |
| `SW1` | BOOT | `BOOT`, `GND` | (84, 50) 90° | (176, 50) 90° |
| `SW2` | RESET | `GND`, `RUN` | (80, 50) 90° | (180, 50) 90° |
| `TP1` | DISP_DC | `DISP_DC` | (178.4, 44.4) 180° | (81.6, 44.4) 0° |
| `TP2` | DISP_RST | `DISP_RST` | (176.2, 44.4) 180° | (83.8, 44.4) 0° |
| `TP3` | DISP_BL | `DISP_BL` | (174, 44.4) 180° | (86, 44.4) 0° |
| `TP6` | TP6 | `TP6` | (81, 36) 0° | (177.6, 55.5) 0° |
| `TP7` | TP7 | `TP7` | (83.2, 36) 0° | (179.8, 55.5) 0° |
| `TP8` | SWCLK | `SWCLK` | (87.6, 34) 0° | (182, 55.5) 0° |
| `TP9` | SWDIO | `SWDIO` | (87.6, 36.2) 0° | (184.2, 55.5) 0° |
| `TP10` | GND | `GND` | (85.4, 36.2) 0° | (186.4, 55.5) 0° |
| `TP11` | TRRS_DET | `TRRS_DET` | (81, 33.8) 0° | (171, 55.5) 0° |
| `U1` | RP2040 | [RP2040 pins](#rp2040-pins) | (93.4, 42) 180° | (166, 44) 0° |
| `U2` | W25Q128JVSIQ | `3V3`, `GND`, `QSPI_SCLK`, `QSPI_SD0`, `QSPI_SD1`, `QSPI_SD2`, `QSPI_SD3`, `QSPI_SS` | (96, 53.7) 180° | (154.6, 35) 0° |
| `U3` | AP2112K-3.3 | `3V3`, `GND`, `VSYS` | (60.4, 46.4) 180° | (199.6, 46.4) 0° |
| `U4` | USBLC6-2SC6 | `GND`, `USB_C_DM`, `USB_C_DP`, `VSYS` | (78.04, 42.49) 151.5° | (177.5, 39.4) 0° |
| `U5` | USBLC6-2SC6 | `GND`, `TRRS_A`, `TRRS_B`, `VLINK` | (204.6, 94.6) 180° | (55.4, 94.6) 0° |
| `U6` | SY6280AAC | `GND`, `RGB_EN`, `VLED`, `VLED_ISET`, `VSYS` | (58.6, 51.2) 0° | (201.4, 51.2) 0° |
| `U7` | SN74LV1T34DBVR | `GND`, `RGB_BUF`, `RGB_DIN`, `VLED` | (65.6, 49) 180° | (186.8, 46.6) 0° |
| `Y1` | 12MHz | `GND`, `XIN`, `XTAL_OUT` | (94.47, 33.1) 90° | (164.93, 52.9) -90° |

## Mounting holes

M2.5 NPTH Ø2.7, copper and component keepout Ø6.5. Hole 7 moved from the stock ErgoDox position to make room for the display.

| # | PCB ref | Left | Right |
|---|---|---|---|
| 0 | `H1` | (206.101, 165.837) | (53.899, 165.837) |
| 1 | `H2` | (200.335, 121.666) | (59.665, 121.666) |
| 2 | `H3` | (154.565, 157.759) | (105.435, 157.759) |
| 3 | `H4` | (58.222, 140.056) | (201.778, 140.056) |
| 4 | `H5` | (120.96, 91.592) | (139.04, 91.592) |
| 5 | `H6` | (58.857, 37.135) | (201.143, 37.135) |
| 6 | `H7` | (141.788, 37.135) | (118.212, 37.135) |
| 7 | `H8` | (172, 37.135) | (88, 37.135) |
