w0rxbend/worxboard/case/production/jlccnc/worxboard_left_bottom.pdf

VIEW FROM BELOW ( Z), outside (cosmetic) face | scale 1:1
ID | Feature | X | Y | Note
C1 | Ø2.9 THRU, 90° CSK Ø5.2 | 76.10 | -65.84 | M2.5x12 countersunk screw into T1
C2 | Ø2.9 THRU, 90° CSK Ø5.2 | 70.34 | -21.67 | M2.5x12 countersunk screw into T2
C3 | Ø2.9 THRU, 90° CSK Ø5.2 | 24.56 | -57.76 | M2.5x12 countersunk screw into T3
C4 | Ø2.9 THRU, 90° CSK Ø5.2 | -71.78 | -40.06 | M2.5x12 countersunk screw into T4
C5 | Ø2.9 THRU, 90° CSK Ø5.2 | -9.04 | 8.41 | M2.5x12 countersunk screw into T5
C6 | Ø2.9 THRU, 90° CSK Ø5.2 | -71.14 | 62.87 | M2.5x12 countersunk screw into T6

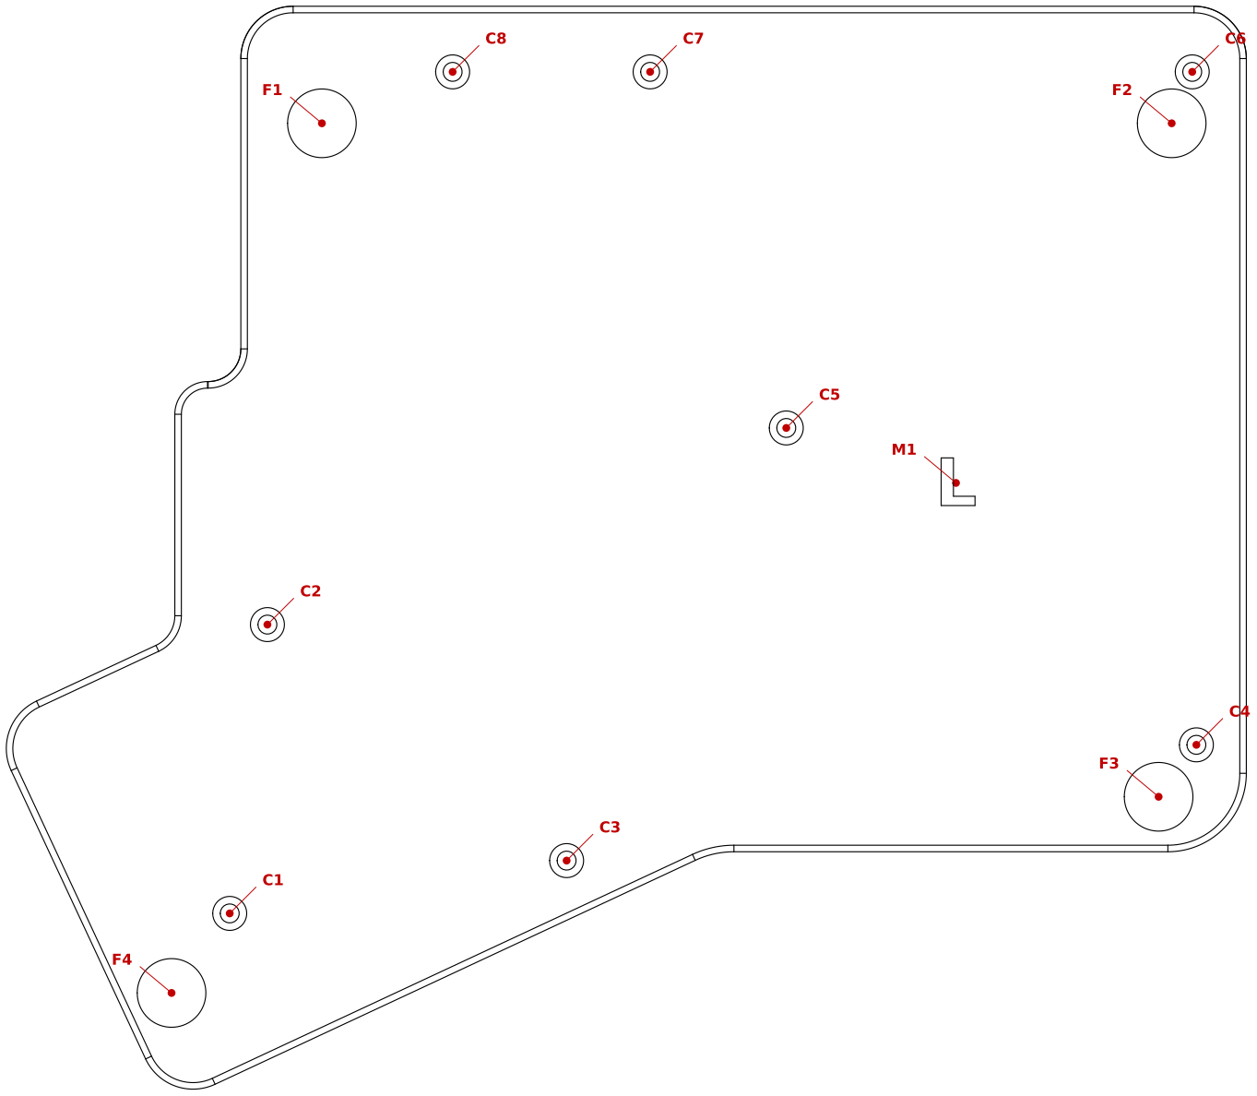
[picture p18: figure]

C7 | Ø2.9 THRU, 90° CSK Ø5.2 | 11.79 | 62.87 | M2.5x12 countersunk screw into T7
C8 | Ø2.9 THRU, 90° CSK Ø5.2 | 42.00 | 62.87 | M2.5x12 countersunk screw into T8
F1 | Ø10.5 x 0.6 deep recess | 62.00 | 55.00 | rubber foot
F2 | Ø10.5 x 0.6 deep recess | -68.00 | 55.00 | rubber foot
F3 | Ø10.5 x 0.6 deep recess | -66.00 | -48.00 | rubber foot
F4 | Ø10.5 x 0.6 deep recess | 85.00 | -78.00 | rubber foot
M1 | engraved 'L', 10 high x 0.4 deep | -35.00 | -0.00 | side mark, reads from below

X/Y in STEP coordinates; features are on the underside (Z = 0).

## GENERAL NOTES

1. Geometry per worxboard_left_bottom.step. Dimensions not shown are taken from the STEP model.
2. Material: Aluminium 6061-T6 (7075-T6 acceptable).
3. NO THREADS in this part. C1-C8: clearance holes with 90° countersink for M2.5 ISO 10642 / DIN 7991 style countersunk screws; heads must sit flush or up to 0.2 below the underside.
4. The USB-C slot of the top part continues 0.8 mm into the back wall of this part, through the wall, 13.0 +0.2/0 wide
| (see STEP). M1: engraved side mark, cosmetic.
5. FIT-CRITICAL, tighter than the general tolerance: C1-C8 positions ±0.1 hole to hole (they match T1-T8 of the top part and the PCB's holes). The tops of the 8 posts round C1-C8 and the parting face (top of the wall) lie in one plane within 0.05: the PCB rests on the posts, the top part on the wall. Overall size 189.7 x 165.6 x 7.0 (reference).
6. Dimensions and tolerances apply AFTER finishing. Anodizing rack / contact marks on inside (non-cosmetic) faces only.
7. Internal corners: boss-web fillets R1.0 (4.0 deep, R = depth/10 + 0.5); tray corners R2 and larger.
8. This is a LEFT-hand part: a mirror image of the right-hand part.
9. Cosmetic surfaces: underside and outer walls: no tool marks, scratches or clamp marks. Inside (pocket) surfaces are
| non-cosmetic.
10. Break sharp edges 0.1-0.2 mm unless modelled.
11. Finish: Fine bead blast + anodize Type II, colour per order.

# worxboard CNC aluminium case

worxboard_left_bottom | https://github.com/w0rxbend/worxboard

### Drawing no.: WXB-BOTTOM-L

Material: Aluminium 6061-T6 (7075-T6 acceptable)

Finish: Fine bead blast + anodize Type II, colour per order

### Sheet 1 of 1

Scale 1:1

Units: mm

Revision A5 Date 2026-11-12

General tolerance ISO 2768-mK unless noted. Threads ISO metric, RIGHT-HAND, 6H.

The STEP file governs geometry; this drawing governs threads, tolerances, finish.

Do not scale drawing
