w0rxbend/worxboard/case/production/jlccnc/worxboard_leg.pdf

## VIEW A bearing face ( Z), scale 2.5:1

Ø10.4 -0.1

38.5

43.5

Ø6.0

Ø4.5

7.5

Pivot axis = origin of the STEP model. Arm along +Y, bearing face at Z = 0.

## VIEW B side (+X), scale 2.5:1, hidden lines dashed

8.0

6.0

bearing face

Ø10.4

Ø3.4 thru

### DETAIL D bearing face, scale 6:1 (FLAT, NO TEETH)

counterbore Ø6.5 x 4.0
deep, from the back face
(dashed, hidden)

Bearing face

Bearing face | Z = 0, FLAT, no teeth, Ø3.4 to Ø10.4. Flatness 0.05, perpendicular to the bore within 0.05. Ra 1.6 max
Function | clamped against the flat case boss (drawing WXB-TOP sheet 2) by the M3 spring thumbscrew; the leg holds its angle by friction
Feature | Specification
Hub | Ø10.4 -0.1 x 8.0 long (face to back face), back edge chamfer 0.3x45°
Bore | Ø3.4 +0.1/0 THROUGH (M3 clearance, NO THREAD), on the pivot axis
Counterbore | Ø6.5 +0.1/0 x 4.0 deep from the back face (spring seat)
Arm | 7.5 wide at hub tapering to 6.0, 6.0 thick, flush with the back face, long edges R1.5, joint to the hub R1.5
Neck / spigot | Ø6.0 to 38.5 from axis; spigot Ø4.5 -0.05 x 5.0 for the foot cap, end chamfer 0.4
Length | 43.5 axis to spigot end; 47 to foot tip with cap

### GENERAL NOTES

1. Geometry per worxboard_leg.step. Dimensions not shown are taken from the STEP model.
2. Material: Aluminium 6061-T6 (7075-T6 acceptable). QUANTITY: 6 pcs (3 per keyboard half; identical, not handed).
3. NO THREADS in this part. An M3 thumbscrew passes through the Ø3.4 bore into the M3 thread of the case boss (its reach past the boss face is limited per drawing WXB-TOP sheet 2).
4. Bearing face: flat, no burrs, no raised tool marks.
5. Break sharp edges 0.1-0.2 mm.
6. Finish: Fine bead blast + anodize Type II, colour per order; same colour as the case. Dimensions and tolerances apply AFTER finishing. Anodizing rack / contact marks on inside (non-cosmetic) faces only.
7. Foot caps are not machined: worxboard_leg_cap_tree (8 TPU 95A caps on one runner, 3D-printed), snipped off and pushed onto the spigot.

# worxboard CNC aluminium case

worxboard_leg | https://github.com/w0rxbend/worxboard

### Drawing no.: WXB-LEG

Material: Aluminium 6061-T6 (7075-T6 acceptable)

Finish: Fine bead blast + anodize Type II, colour per order

### Sheet 1 of 1

Scale 2.5:1, 6:1

Units: mm

Revision A5 Date 2026-11-12

General tolerance ISO 2768-mK unless noted. Threads ISO metric, RIGHT-HAND, 6H.

The STEP file governs geometry; this drawing governs threads, tolerances, finish.

Do not scale drawing
