w0rxbend/worxboard/docs/matrix.md

<!-- GENERATED by site/gen_docs.py from layout/build/layout.json, pcb/scripts/design.py and pcb/<side>/worxboard-<side>.kicad_pcb. Do not edit: run `just docs-gen`. -->

# Key matrix

Each half has a 6 × 7 diode matrix, `col2row`: the diode anode is on the switch/column side and the cathode on the ROW net. Diodes are 1N4148W (SOD-123) on the bottom side next to each hot-swap socket. Both PCBs share **one** matrix netlist: `COLn` is physical column Cn (C0 outer, C6 inner) on both halves.

- Keys per half: **37**, total **74**.
- Slot (R0, C6) is the display on both halves and is not mapped.
- Legends are the ZMK base layer (QMK `ergodox_ez` layer 0; LEFT/RGHT moved to layer 1).

## Left half (physical)

Cells show the key id, its legend and the global ZMK position `RC(row, col)`.

| Row \ Col | `COL0` GP14 | `COL1` GP15 | `COL2` GP16 | `COL3` GP17 | `COL4` GP18 | `COL5` GP19 | `COL6` GP20 |
|---|---|---|---|---|---|---|---|
| `ROW0` GP8 | C0R0 `=` (0,0) | C1R0 `1` (0,1) | C2R0 `2` (0,2) | C3R0 `3` (0,3) | C4R0 `4` (0,4) | C5R0 `5` (0,5) | **DISPLAY** |
| `ROW1` GP9 | C0R1 `DEL` (1,0) | C1R1 `Q` (1,1) | C2R1 `W` (1,2) | C3R1 `E` (1,3) | C4R1 `R` (1,4) | C5R1 `T` (1,5) | C6R1 `TG(1)` (1,6) |
| `ROW2` GP10 | C0R2 `BSPC` (2,0) | C1R2 `A` (2,1) | C2R2 `S` (2,2) | C3R2 `D` (2,3) | C4R2 `F` (2,4) | C5R2 `G` (2,5) | — |
| `ROW3` GP11 | C0R3 `LSFT` (3,0) | C1R3 `CTL_T(Z)` (3,1) | C2R3 `X` (3,2) | C3R3 `C` (3,3) | C4R3 `V` (3,4) | C5R3 `B` (3,5) | C6R2 `HYPER` (3,6) |
| `ROW4` GP12 | C0R4 `` LT(1,`) `` (4,0) | C1R4 `'` (4,1) | C2R4 `LA(LSFT)` (4,2) | C3R4 `LEFT` (4,3) | C4R4 `RGHT` (4,4) | — | — |
| `ROW5` GP13 | — | T5 `SPC` (5,1) | T4 `BSPC` (5,2) | T3 `END` (5,3) | T2 `HOME` (5,4) | T1 `ALT_T(APP)` (5,5) | T0 `LGUI` (5,6) |

## Right half (physical)

Cells show the key id, its legend and the global ZMK position `RC(row, col)`.

| Row \ Col | `COL0` GP14 | `COL1` GP15 | `COL2` GP16 | `COL3` GP17 | `COL4` GP18 | `COL5` GP19 | `COL6` GP20 |
|---|---|---|---|---|---|---|---|
| `ROW0` GP8 | C0R0 `-` (0,13) | C1R0 `0` (0,12) | C2R0 `9` (0,11) | C3R0 `8` (0,10) | C4R0 `7` (0,9) | C5R0 `6` (0,8) | **DISPLAY** |
| `ROW1` GP9 | C0R1 `\` (1,13) | C1R1 `P` (1,12) | C2R1 `O` (1,11) | C3R1 `I` (1,10) | C4R1 `U` (1,9) | C5R1 `Y` (1,8) | C6R1 `TG(1)` (1,7) |
| `ROW2` GP10 | C0R2 `GUI_T(')` (2,13) | C1R2 `LT(2,;)` (2,12) | C2R2 `L` (2,11) | C3R2 `K` (2,10) | C4R2 `J` (2,9) | C5R2 `H` (2,8) | — |
| `ROW3` GP11 | C0R3 `RSFT` (3,13) | C1R3 `CTL_T(/)` (3,12) | C2R3 `.` (3,11) | C3R3 `,` (3,10) | C4R3 `M` (3,9) | C5R3 `N` (3,8) | C6R2 `MEH` (3,7) |
| `ROW4` GP12 | C0R4 `TT(1)` (4,13) | C1R4 `]` (4,12) | C2R4 `[` (4,11) | C3R4 `DOWN` (4,10) | C4R4 `UP` (4,9) | — | — |
| `ROW5` GP13 | — | T5 `ENT` (5,12) | T4 `TAB` (5,11) | T3 `PGDN` (5,10) | T2 `PGUP` (5,9) | T1 `CTL_T(ESC)` (5,8) | T0 `LALT` (5,7) |

## ZMK transform (6 × 14)

The global map the keymap and ZMK Studio see. Left columns 0–6 are physical C0–C6; right columns 7–13 are physical C6–C0 (the right `.dts` reverses `col-gpios` and sets `col-offset = <7>`).

| Row | 0 | 1 | 2 | 3 | 4 | 5 | 6 | 7 | 8 | 9 | 10 | 11 | 12 | 13 |
|---|---|---|---|---|---|---|---|---|---|---|---|---|---|---|
| 0 | `=` | `1` | `2` | `3` | `4` | `5` | LCD | LCD | `6` | `7` | `8` | `9` | `0` | `-` |
| 1 | `DEL` | `Q` | `W` | `E` | `R` | `T` | `TG(1)` | `TG(1)` | `Y` | `U` | `I` | `O` | `P` | `\` |
| 2 | `BSPC` | `A` | `S` | `D` | `F` | `G` | · | · | `H` | `J` | `K` | `L` | `LT(2,;)` | `GUI_T(')` |
| 3 | `LSFT` | `CTL_T(Z)` | `X` | `C` | `V` | `B` | `HYPER` | `MEH` | `N` | `M` | `,` | `.` | `CTL_T(/)` | `RSFT` |
| 4 | `` LT(1,`) `` | `'` | `LA(LSFT)` | `LEFT` | `RGHT` | · | · | · | · | `UP` | `DOWN` | `[` | `]` | `TT(1)` |
| 5 | · | `SPC` | `BSPC` | `END` | `HOME` | `ALT_T(APP)` | `LGUI` | `LALT` | `CTL_T(ESC)` | `PGUP` | `PGDN` | `TAB` | `ENT` | · |

## Sockets and diodes

Each key has a Kailh hot-swap socket `SK` and a diode `D` on the bottom side, numbered from 101 in `layout` key order (deviation WS2a-1). The references are the same on both PCBs; the diode anode is on the switch net `MX_<key>`, the cathode on the row.

| Key | Socket | Diode | Row | Column | Left legend | Right legend |
|---|---|---|---|---|---|---|
| C0R0 | `SK101` | `D101` | `ROW0` | `COL0` | `=` | `-` |
| C1R0 | `SK102` | `D102` | `ROW0` | `COL1` | `1` | `0` |
| C2R0 | `SK103` | `D103` | `ROW0` | `COL2` | `2` | `9` |
| C3R0 | `SK104` | `D104` | `ROW0` | `COL3` | `3` | `8` |
| C4R0 | `SK105` | `D105` | `ROW0` | `COL4` | `4` | `7` |
| C5R0 | `SK106` | `D106` | `ROW0` | `COL5` | `5` | `6` |
| C0R1 | `SK107` | `D107` | `ROW1` | `COL0` | `DEL` | `\` |
| C1R1 | `SK108` | `D108` | `ROW1` | `COL1` | `Q` | `P` |
| C2R1 | `SK109` | `D109` | `ROW1` | `COL2` | `W` | `O` |
| C3R1 | `SK110` | `D110` | `ROW1` | `COL3` | `E` | `I` |
| C4R1 | `SK111` | `D111` | `ROW1` | `COL4` | `R` | `U` |
| C5R1 | `SK112` | `D112` | `ROW1` | `COL5` | `T` | `Y` |
| C6R1 | `SK113` | `D113` | `ROW1` | `COL6` | `TG(1)` | `TG(1)` |
| C0R2 | `SK114` | `D114` | `ROW2` | `COL0` | `BSPC` | `GUI_T(')` |
| C1R2 | `SK115` | `D115` | `ROW2` | `COL1` | `A` | `LT(2,;)` |
| C2R2 | `SK116` | `D116` | `ROW2` | `COL2` | `S` | `L` |
| C3R2 | `SK117` | `D117` | `ROW2` | `COL3` | `D` | `K` |
| C4R2 | `SK118` | `D118` | `ROW2` | `COL4` | `F` | `J` |
| C5R2 | `SK119` | `D119` | `ROW2` | `COL5` | `G` | `H` |
| C0R3 | `SK120` | `D120` | `ROW3` | `COL0` | `LSFT` | `RSFT` |
| C1R3 | `SK121` | `D121` | `ROW3` | `COL1` | `CTL_T(Z)` | `CTL_T(/)` |
| C2R3 | `SK122` | `D122` | `ROW3` | `COL2` | `X` | `.` |
| C3R3 | `SK123` | `D123` | `ROW3` | `COL3` | `C` | `,` |
| C4R3 | `SK124` | `D124` | `ROW3` | `COL4` | `V` | `M` |
| C5R3 | `SK125` | `D125` | `ROW3` | `COL5` | `B` | `N` |
| C6R2 | `SK126` | `D126` | `ROW3` | `COL6` | `HYPER` | `MEH` |
| C0R4 | `SK127` | `D127` | `ROW4` | `COL0` | `` LT(1,`) `` | `TT(1)` |
| C1R4 | `SK128` | `D128` | `ROW4` | `COL1` | `'` | `]` |
| C2R4 | `SK129` | `D129` | `ROW4` | `COL2` | `LA(LSFT)` | `[` |
| C3R4 | `SK130` | `D130` | `ROW4` | `COL3` | `LEFT` | `DOWN` |
| C4R4 | `SK131` | `D131` | `ROW4` | `COL4` | `RGHT` | `UP` |
| T0 | `SK132` | `D132` | `ROW5` | `COL6` | `LGUI` | `LALT` |
| T1 | `SK133` | `D133` | `ROW5` | `COL5` | `ALT_T(APP)` | `CTL_T(ESC)` |
| T2 | `SK134` | `D134` | `ROW5` | `COL4` | `HOME` | `PGUP` |
| T3 | `SK135` | `D135` | `ROW5` | `COL3` | `END` | `PGDN` |
| T4 | `SK136` | `D136` | `ROW5` | `COL2` | `BSPC` | `TAB` |
| T5 | `SK137` | `D137` | `ROW5` | `COL1` | `SPC` | `ENT` |

## Keymap order

Bindings in `worxboard.keymap`, the transform `map` and the physical layout all follow this order (12 / 14 / 12 / 14 / 10, then the thumbs).

| # | Half | Key | Position | Legend | x (mm) | y (mm) | rot (°) | Size (u) |
|---|---|---|---|---|---|---|---|---|
| 0 | left | C0R0 | RC(0,0) | `=` | 68.5475 | 67.0052 | 0 | 1.5×1 |
| 1 | left | C1R0 | RC(0,1) | `1` | 92.36 | 67.0052 | 0 | 1×1 |
| 2 | left | C2R0 | RC(0,2) | `2` | 111.41 | 63.8277 | 0 | 1×1 |
| 3 | left | C3R0 | RC(0,3) | `3` | 130.46 | 62.23 | 0 | 1×1 |
| 4 | left | C4R0 | RC(0,4) | `4` | 149.51 | 63.8277 | 0 | 1×1 |
| 5 | left | C5R0 | RC(0,5) | `5` | 168.56 | 65.1002 | 0 | 1×1 |
| 6 | right | C5R0 | RC(0,8) | `6` | 91.44 | 65.1002 | 0 | 1×1 |
| 7 | right | C4R0 | RC(0,9) | `7` | 110.49 | 63.8277 | 0 | 1×1 |
| 8 | right | C3R0 | RC(0,10) | `8` | 129.54 | 62.23 | 0 | 1×1 |
| 9 | right | C2R0 | RC(0,11) | `9` | 148.59 | 63.8277 | 0 | 1×1 |
| 10 | right | C1R0 | RC(0,12) | `0` | 167.64 | 67.0052 | 0 | 1×1 |
| 11 | right | C0R0 | RC(0,13) | `-` | 191.4525 | 67.0052 | 0 | 1.5×1 |
| 12 | left | C0R1 | RC(1,0) | `DEL` | 68.5475 | 86.0527 | 0 | 1.5×1 |
| 13 | left | C1R1 | RC(1,1) | `Q` | 92.36 | 86.0527 | 0 | 1×1 |
| 14 | left | C2R1 | RC(1,2) | `W` | 111.41 | 82.8777 | 0 | 1×1 |
| 15 | left | C3R1 | RC(1,3) | `E` | 130.46 | 81.28 | 0 | 1×1 |
| 16 | left | C4R1 | RC(1,4) | `R` | 149.51 | 82.8777 | 0 | 1×1 |
| 17 | left | C5R1 | RC(1,5) | `T` | 168.56 | 84.1477 | 0 | 1×1 |
| 18 | left | C6R1 | RC(1,6) | `TG(1)` | 187.61 | 88.9102 | 0 | 1×1.5 |
| 19 | right | C6R1 | RC(1,7) | `TG(1)` | 72.39 | 88.9102 | 0 | 1×1.5 |
| 20 | right | C5R1 | RC(1,8) | `Y` | 91.44 | 84.1477 | 0 | 1×1 |
| 21 | right | C4R1 | RC(1,9) | `U` | 110.49 | 82.8777 | 0 | 1×1 |
| 22 | right | C3R1 | RC(1,10) | `I` | 129.54 | 81.28 | 0 | 1×1 |
| 23 | right | C2R1 | RC(1,11) | `O` | 148.59 | 82.8777 | 0 | 1×1 |
| 24 | right | C1R1 | RC(1,12) | `P` | 167.64 | 86.0527 | 0 | 1×1 |
| 25 | right | C0R1 | RC(1,13) | `\` | 191.4525 | 86.0527 | 0 | 1.5×1 |
| 26 | left | C0R2 | RC(2,0) | `BSPC` | 68.5475 | 105.1027 | 0 | 1.5×1 |
| 27 | left | C1R2 | RC(2,1) | `A` | 92.36 | 105.1027 | 0 | 1×1 |
| 28 | left | C2R2 | RC(2,2) | `S` | 111.41 | 101.9277 | 0 | 1×1 |
| 29 | left | C3R2 | RC(2,3) | `D` | 130.46 | 100.33 | 0 | 1×1 |
| 30 | left | C4R2 | RC(2,4) | `F` | 149.51 | 101.9277 | 0 | 1×1 |
| 31 | left | C5R2 | RC(2,5) | `G` | 168.56 | 103.1977 | 0 | 1×1 |
| 32 | right | C5R2 | RC(2,8) | `H` | 91.44 | 103.1977 | 0 | 1×1 |
| 33 | right | C4R2 | RC(2,9) | `J` | 110.49 | 101.9277 | 0 | 1×1 |
| 34 | right | C3R2 | RC(2,10) | `K` | 129.54 | 100.33 | 0 | 1×1 |
| 35 | right | C2R2 | RC(2,11) | `L` | 148.59 | 101.9277 | 0 | 1×1 |
| 36 | right | C1R2 | RC(2,12) | `LT(2,;)` | 167.64 | 105.1027 | 0 | 1×1 |
| 37 | right | C0R2 | RC(2,13) | `GUI_T(')` | 191.4525 | 105.1027 | 0 | 1.5×1 |
| 38 | left | C0R3 | RC(3,0) | `LSFT` | 68.5475 | 124.1527 | 0 | 1.5×1 |
| 39 | left | C1R3 | RC(3,1) | `CTL_T(Z)` | 92.36 | 124.1527 | 0 | 1×1 |
| 40 | left | C2R3 | RC(3,2) | `X` | 111.41 | 120.9777 | 0 | 1×1 |
| 41 | left | C3R3 | RC(3,3) | `C` | 130.46 | 119.38 | 0 | 1×1 |
| 42 | left | C4R3 | RC(3,4) | `V` | 149.51 | 120.9777 | 0 | 1×1 |
| 43 | left | C5R3 | RC(3,5) | `B` | 168.56 | 122.2477 | 0 | 1×1 |
| 44 | left | C6R2 | RC(3,6) | `HYPER` | 187.61 | 117.4852 | 0 | 1×1.5 |
| 45 | right | C6R2 | RC(3,7) | `MEH` | 72.39 | 117.4852 | 0 | 1×1.5 |
| 46 | right | C5R3 | RC(3,8) | `N` | 91.44 | 122.2477 | 0 | 1×1 |
| 47 | right | C4R3 | RC(3,9) | `M` | 110.49 | 120.9777 | 0 | 1×1 |
| 48 | right | C3R3 | RC(3,10) | `,` | 129.54 | 119.38 | 0 | 1×1 |
| 49 | right | C2R3 | RC(3,11) | `.` | 148.59 | 120.9777 | 0 | 1×1 |
| 50 | right | C1R3 | RC(3,12) | `CTL_T(/)` | 167.64 | 124.1527 | 0 | 1×1 |
| 51 | right | C0R3 | RC(3,13) | `RSFT` | 191.4525 | 124.1527 | 0 | 1.5×1 |
| 52 | left | C0R4 | RC(4,0) | `` LT(1,`) `` | 73.31 | 143.2027 | 0 | 1×1 |
| 53 | left | C1R4 | RC(4,1) | `'` | 92.36 | 143.2027 | 0 | 1×1 |
| 54 | left | C2R4 | RC(4,2) | `LA(LSFT)` | 111.41 | 140.0277 | 0 | 1×1 |
| 55 | left | C3R4 | RC(4,3) | `LEFT` | 130.46 | 138.43 | 0 | 1×1 |
| 56 | left | C4R4 | RC(4,4) | `RGHT` | 149.51 | 140.0277 | 0 | 1×1 |
| 57 | right | C4R4 | RC(4,9) | `UP` | 110.49 | 140.0277 | 0 | 1×1 |
| 58 | right | C3R4 | RC(4,10) | `DOWN` | 129.54 | 138.43 | 0 | 1×1 |
| 59 | right | C2R4 | RC(4,11) | `[` | 148.59 | 140.0277 | 0 | 1×1 |
| 60 | right | C1R4 | RC(4,12) | `]` | 167.64 | 143.2027 | 0 | 1×1 |
| 61 | right | C0R4 | RC(4,13) | `TT(1)` | 186.69 | 143.2027 | 0 | 1×1 |
| 62 | left | T1 | RC(5,5) | `ALT_T(APP)` | 208.0367 | 135.2194 | -25 | 1×1 |
| 63 | left | T0 | RC(5,6) | `LGUI` | 225.3011 | 143.2687 | -25 | 1×1 |
| 64 | right | T0 | RC(5,7) | `LALT` | 34.6989 | 143.2687 | 25 | 1×1 |
| 65 | right | T1 | RC(5,8) | `CTL_T(ESC)` | 51.9633 | 135.2194 | 25 | 1×1 |
| 66 | left | T2 | RC(5,4) | `HOME` | 217.2518 | 160.5331 | -25 | 1×1 |
| 67 | right | T2 | RC(5,9) | `PGUP` | 42.7482 | 160.5331 | 25 | 1×1 |
| 68 | left | T5 | RC(5,1) | `SPC` | 178.6971 | 153.0655 | -25 | 1×2 |
| 69 | left | T4 | RC(5,2) | `BSPC` | 195.9615 | 161.1173 | -25 | 1×2 |
| 70 | left | T3 | RC(5,3) | `END` | 209.2 | 177.8 | -25 | 1×1 |
| 71 | right | T3 | RC(5,10) | `PGDN` | 50.8 | 177.8 | 25 | 1×1 |
| 72 | right | T4 | RC(5,11) | `TAB` | 64.0385 | 161.1173 | 25 | 1×2 |
| 73 | right | T5 | RC(5,12) | `ENT` | 81.3029 | 153.0655 | 25 | 1×2 |
