w0rxbend/worxboard/case/ORDER_NOTES.md

# Ordering the worxboard case

The order notes moved into the committed order package, [`case/production/`](production/README.md):

- [`production/jlccnc/ORDER_NOTES.md`](production/jlccnc/ORDER_NOTES.md): the machined parts
  (JLCCNC): form settings, remarks to paste, answers to engineering questions.
- [`production/jlc3dp/ORDER_NOTES.md`](production/jlc3dp/ORDER_NOTES.md): the printed parts
  (JLC3DP): plate spacers and the leg foot-cap tree.
- [`production/hardware.csv`](production/hardware.csv): screws, feet and leg hardware.
