w0rxbend/worxboard/pcb/production/left/bom.csv

Comment | Designator | Footprint | LCSC Part #
RP2040 | U1 | Package_DFN_QFN:QFN-56-1EP_7x7mm_P0.4mm_EP3.2x3.2mm | C2040
W25Q128JVSIQ | U2 | Package_SO:SOIC-8_5.3x5.3mm_P1.27mm | C97521
100n | C5,C8,C9,C10,C11,C12,C13,C14,C15,C16,C17,C22,C101,C102,C103,C104,C105,C106,C107,C108,C109,C110,C111,C112,C113,C114,C115,C116,C117,C118,C119,C120,C121,C122,C123,C124,C125,C126,C127,C128,C129,C130,C131,C132,C133,C134,C135,C136,C137 | Capacitor_SMD:C_0402_1005Metric | C1525
12MHz | Y1 | Crystal:Crystal_SMD_3225-4Pin_3.2x2.5mm | C49304726
1k | R7,R9 | Resistor_SMD:R_0402_1005Metric | C11702
27p | C6,C7 | Capacitor_SMD:C_0402_1005Metric | C1557
10k | R5,R6,R8,R10,R13,R15 | Resistor_SMD:R_0402_1005Metric | C25744
BOOT | SW1 | Button_Switch_SMD:SW_SPST_TS-1088-xR020 | C455280
RESET | SW2 | Button_Switch_SMD:SW_SPST_TS-1088-xR020 | C455280
1u | C4,C18,C19 | Capacitor_SMD:C_0402_1005Metric | C52923
TYPE-C-31-M-12 | J1 | Connector_USB:USB_C_Receptacle_HRO_TYPE-C-31-M-12 | C165948
5.1k | R1,R2 | Resistor_SMD:R_0402_1005Metric | C25905
27 | R3,R4 | Resistor_SMD:R_0402_1005Metric | C2909343
USBLC6-2SC6 | U4,U5 | Package_TO_SOT_SMD:SOT-23-6 | C7519
B5819W | D1 | Diode_SMD:D_SOD-123 | C8598
10u | C1,C2,C3,C20,C21 | Capacitor_SMD:C_0603_1608Metric | C19702
AP2112K-3.3 | U3 | Package_TO_SOT_SMD:SOT-23-5 | C51118
500mA | F1 | Fuse:Fuse_1206_3216Metric | C70076
PJ-320D-4A | J2 | Connector_Audio:Jack_3.5mm_PJ320D_Horizontal | C95562
470 | R11,R12,R16 | Resistor_SMD:R_0402_1005Metric | C25117
HC-PM254-5.0H-1x5PZ | J3 | worxboard:PinSocket_1x05_P2.54mm_Vertical_H5.0mm | C27985230
SY6280AAC | U6 | Package_TO_SOT_SMD:SOT-23-5 | C55136
15k | R14 | Resistor_SMD:R_0402_1005Metric | C25756
SN74LV1T34DBVR | U7 | Package_TO_SOT_SMD:SOT-23-5 | C100024
SK6812MINI-E | LED101,LED102,LED103,LED104,LED105,LED106,LED107,LED108,LED109,LED110,LED111,LED112,LED113,LED114,LED115,LED116,LED117,LED118,LED119,LED120,LED121,LED122,LED123,LED124,LED125,LED126,LED127,LED128,LED129,LED130,LED131,LED132,LED133,LED134,LED135,LED136,LED137 | worxboard:LED_SK6812MINI-E_ReverseMount | C5149201
MX | SK101,SK102,SK103,SK104,SK105,SK106,SK107,SK108,SK109,SK110,SK111,SK112,SK113,SK114,SK115,SK116,SK117,SK118,SK119,SK120,SK121,SK122,SK123,SK124,SK125,SK126,SK127,SK128,SK129,SK130,SK131,SK132,SK133,SK134,SK135,SK136,SK137 | worxboard:SW_MX_Hotswap_Kailh | C41430893
1N4148W | D101,D102,D103,D104,D105,D106,D107,D108,D109,D110,D111,D112,D113,D114,D115,D116,D117,D118,D119,D120,D121,D122,D123,D124,D125,D126,D127,D128,D129,D130,D131,D132,D133,D134,D135,D136,D137 | Diode_SMD:D_SOD-123 | C81598
