w0rxbend/worxboard/case/production/hardware.csv

item | qty_per_keyboard | spec | where | note
M2.5x12 countersunk screw | 16 | M2.5x0.45, length 12 incl. head, 90° head <= Ø5.2, hex socket (ISO 10642 / DIN 7991 style), steel or A2 | T1, T2, T3, T4, T5, T6, T7, T8 per half (C1, C2, C3, C4, C5, C6, C7, C8 in the tray) | engages 3.4 mm; do NOT use a longer screw: its tip would reach past the 4.5 mm thread of the blind holes or stand out of the key-well floor at T1 and T5 (tapped through)
Rubber foot | 8 | self-adhesive, Ø10 (max Ø10.3), 2-3 mm tall | F1-F4 recesses in each tray | recess Ø10.5 x 0.6
Leg thumbscrew | 6 | M3x12 knurled-head thumbscrew WITHOUT a collar (DIN 653, flat head underside Ø >= 7, so it bears on the leg's back face). Not DIN 464 or any shouldered thumbscrew: its collar drops into the leg's Ø6.5 x 4 counterbore and the screw reaches 4 mm further. Or the stock ErgoDox EZ M3 spring thumbscrew, measured first | L1-L3 per half | its thread may reach at most outer 3.7, inner 5.7, thumb 3.7 mm past the boss face; an M3x12 on the 8 mm hub reaches 4.0 less the washer
Friction washer | 6 | Ø10 x Ø3.2, 0.5-1.0 mm, fibre, rubber or cork | between each leg hub and its boss | required with an M3x12 thumbscrew (keeps its reach within the thread); holds the leg angle
