w0rxbend/worxboard/case/production/jlc3dp/worxboard_right_spacer.stl

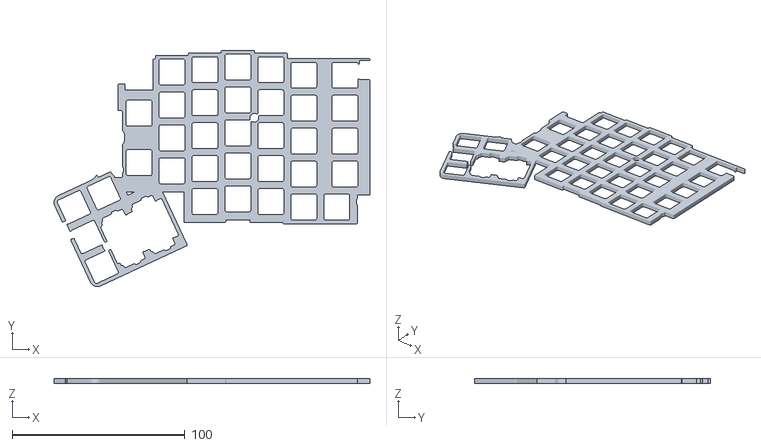
[picture p24: CAD file, 2026-11-04]
case/production/jlc3dp/worxboard_right_spacer.stl
182.7 x 136.6 x 3.00
