w0rxbend/worxboard/case/production/jlccnc/worxboard_right_top.step

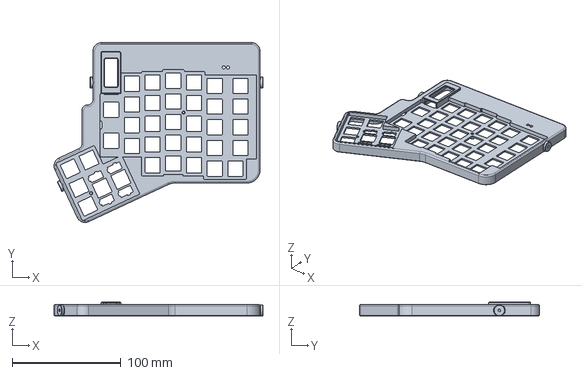
[picture p25: CAD file, 2026-11-12]
case/production/jlccnc/worxboard_right_top.step
192.4 x 165.6 x 12.6 mm
