w0rxbend/worxboard/plates/worxboard-plate-left.dxf

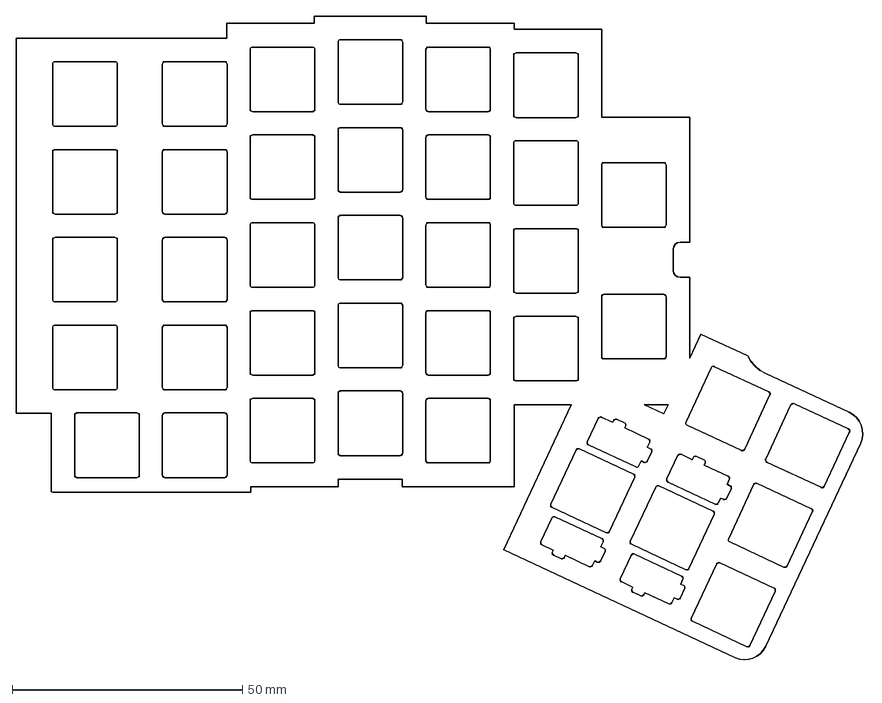
[picture p26: CAD file, 2026-11-04]
plates/worxboard-plate-left.dxf
184.4 x 140.3 mm
