w0rxbend/worxboard/case/production/jlccnc/worxboard_right_bottom.step

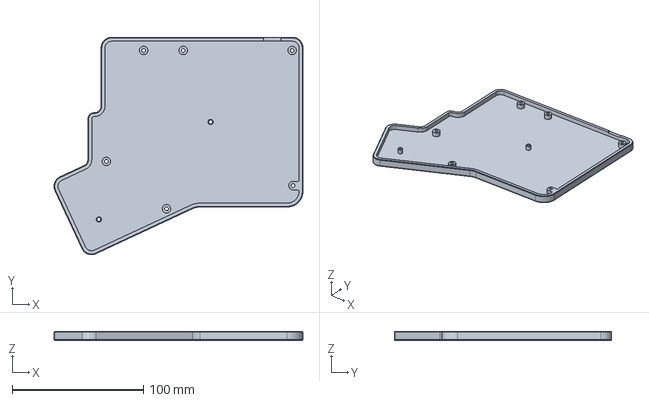
[picture p27: CAD file, 2026-11-12]
case/production/jlccnc/worxboard_right_bottom.step
189.7 x 165.6 x 7.00 mm
