w0rxbend/worxboard/plates/worxboard-plate-right.dxf

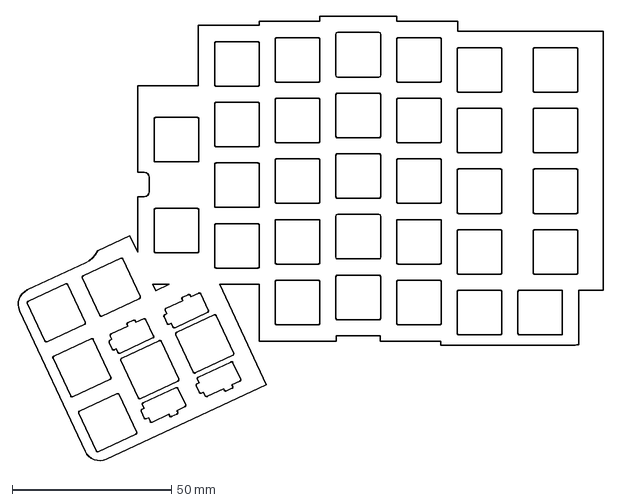
[picture p28: CAD file, 2026-11-04]
plates/worxboard-plate-right.dxf
184.4 x 140.3 mm
