w0rxbend/worxboard/case/production/jlc3dp/worxboard_leg_cap_tree.stl

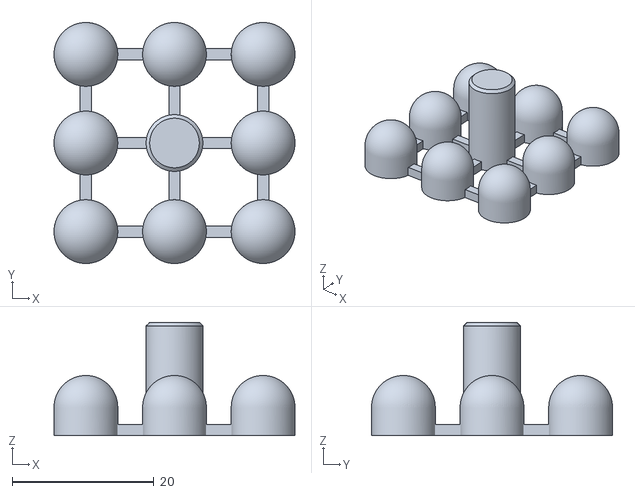
[picture p29: CAD file, 2026-11-04]
case/production/jlc3dp/worxboard_leg_cap_tree.stl
34.0 x 34.0 x 16.0
