w0rxbend/worxboard/case/production/jlccnc/worxboard_leg.step

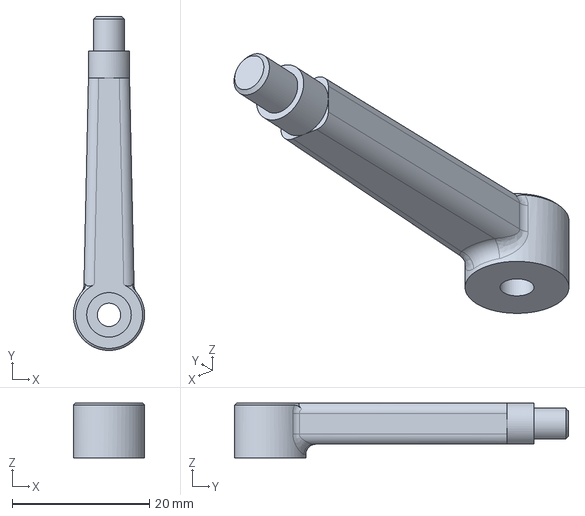
[picture p30: CAD file, 2026-11-12]
case/production/jlccnc/worxboard_leg.step
10.4 x 48.7 x 8.00 mm
