w0rxbend/worxboard/(list of files, cad)

Other CAD files:
case/production/jlc3dp/worxboard_left_spacer.stl
case/production/jlccnc/worxboard_left_bottom.step
case/production/jlccnc/worxboard_left_top.step
