w0rxbend/worxboard/site/guide.template.html

Skip to the text

worxboard GitHub (https://github.com/w0rxbend/worxboard) Build one

$body

worxboard

Free and open source. Code under GPL-3.0-or-later, hardware under CERN-OHL-S-2.0. "ErgoDox EZ" is a product of ZSA Technology Labs and "nice!view" of Nice Keyboards; this project is not affiliated with or endorsed by either.

github.com/w0rxbend/worxboard, build $version
