w0rxbend/worxboard/pcb/left/worxboard-left.kicad_pcb

## KiCad design pcb/left/worxboard-left.kicad_pcb (2026-11-12)

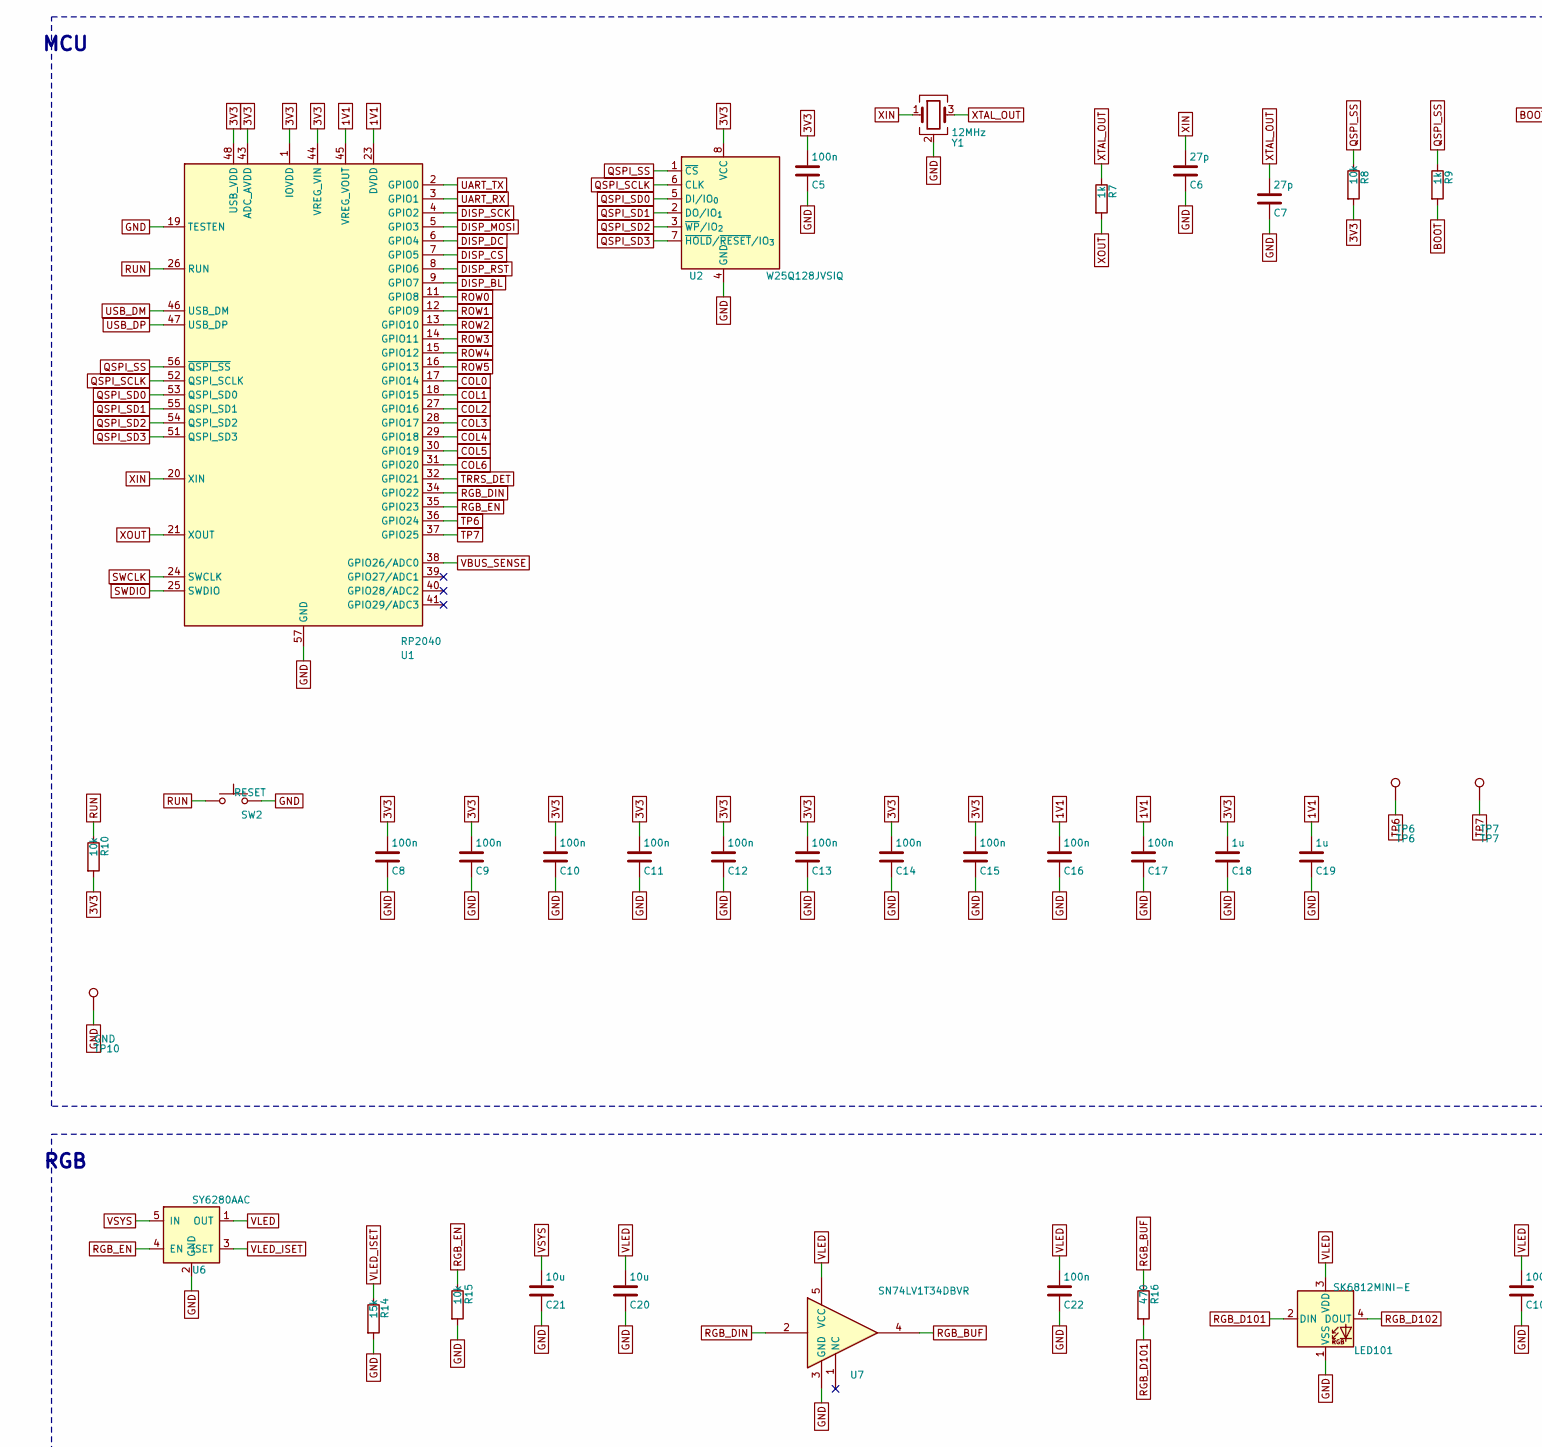
[picture p31: schematic worxboard-left.kicad_sch, worxboard left half, part in row 1, column 1]

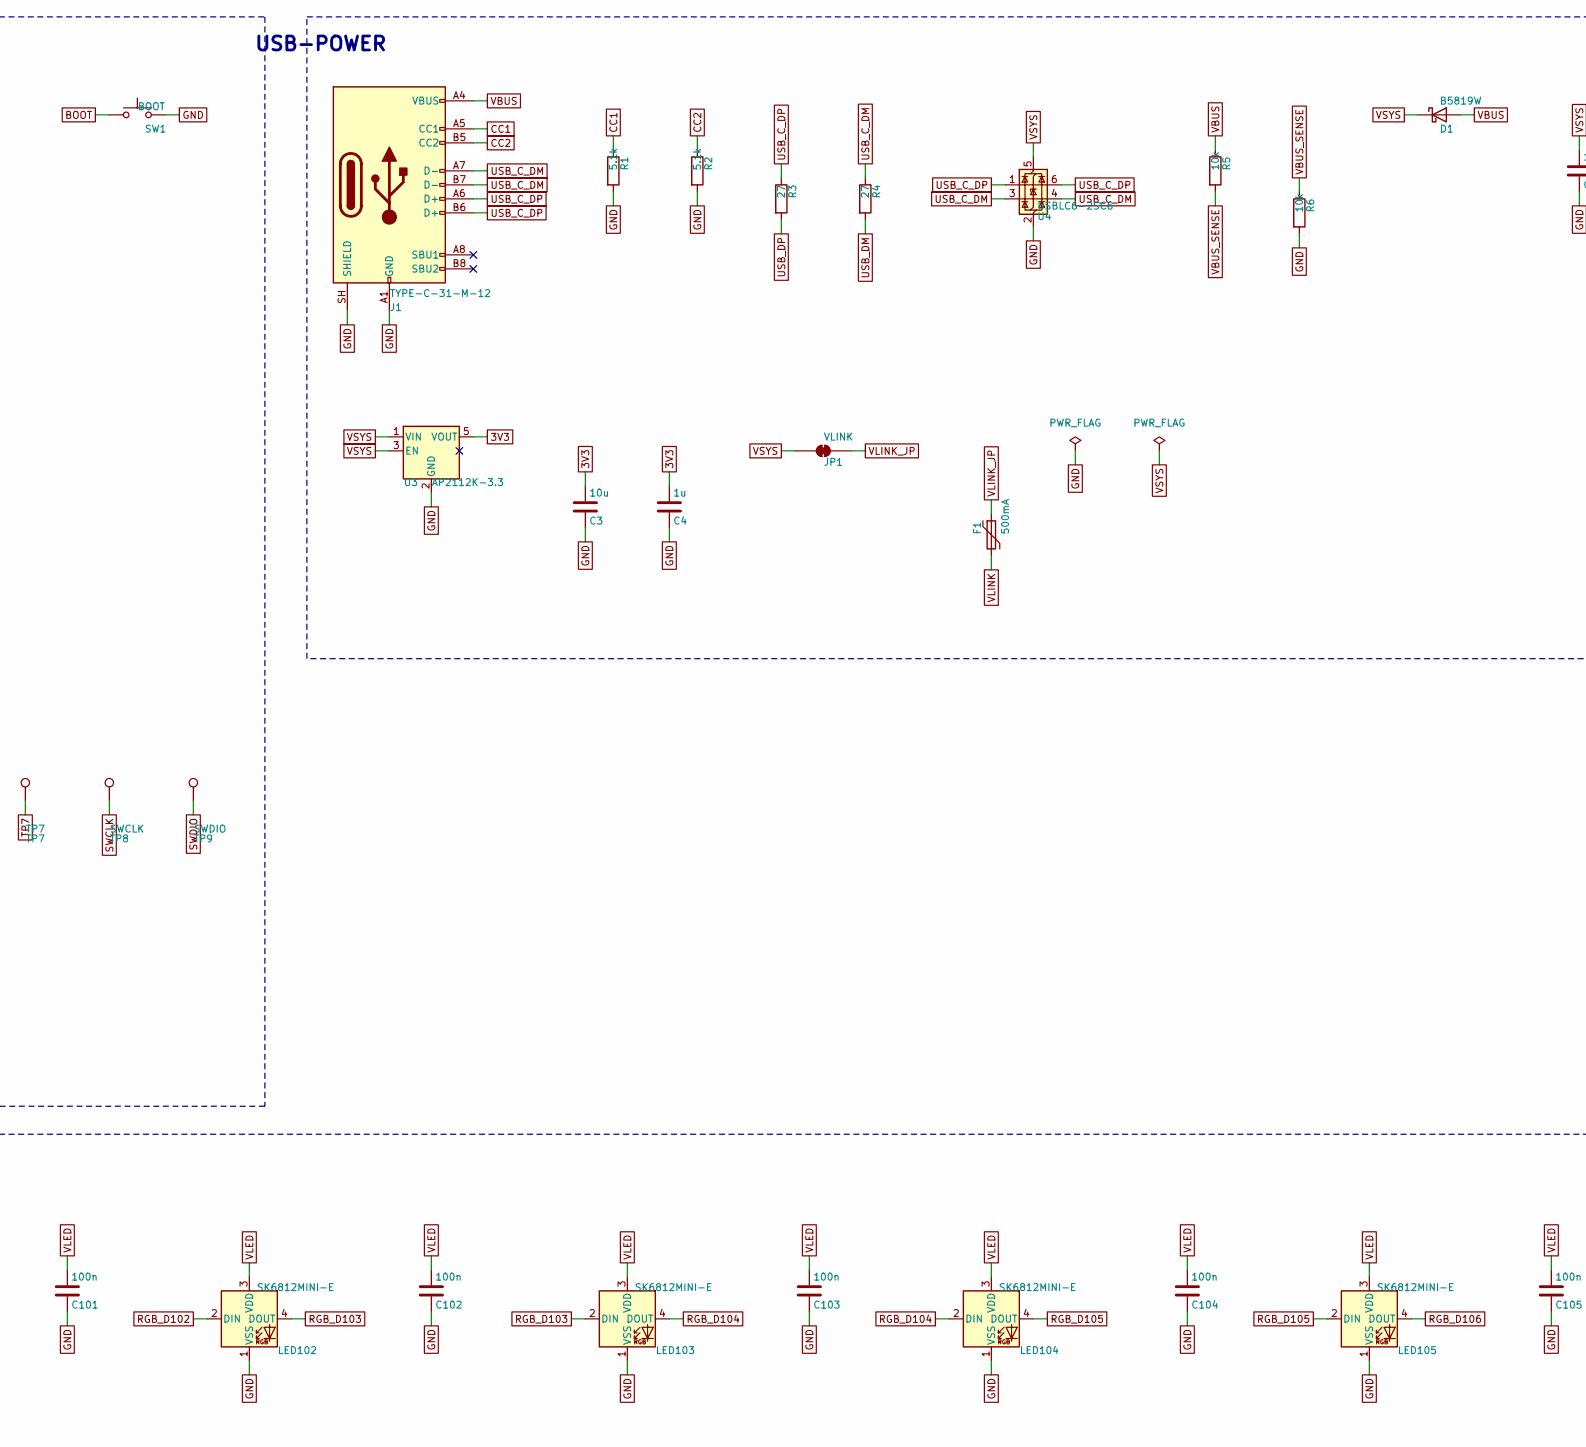
[picture p32: schematic worxboard-left.kicad_sch, worxboard left half, part in row 1, column 2]

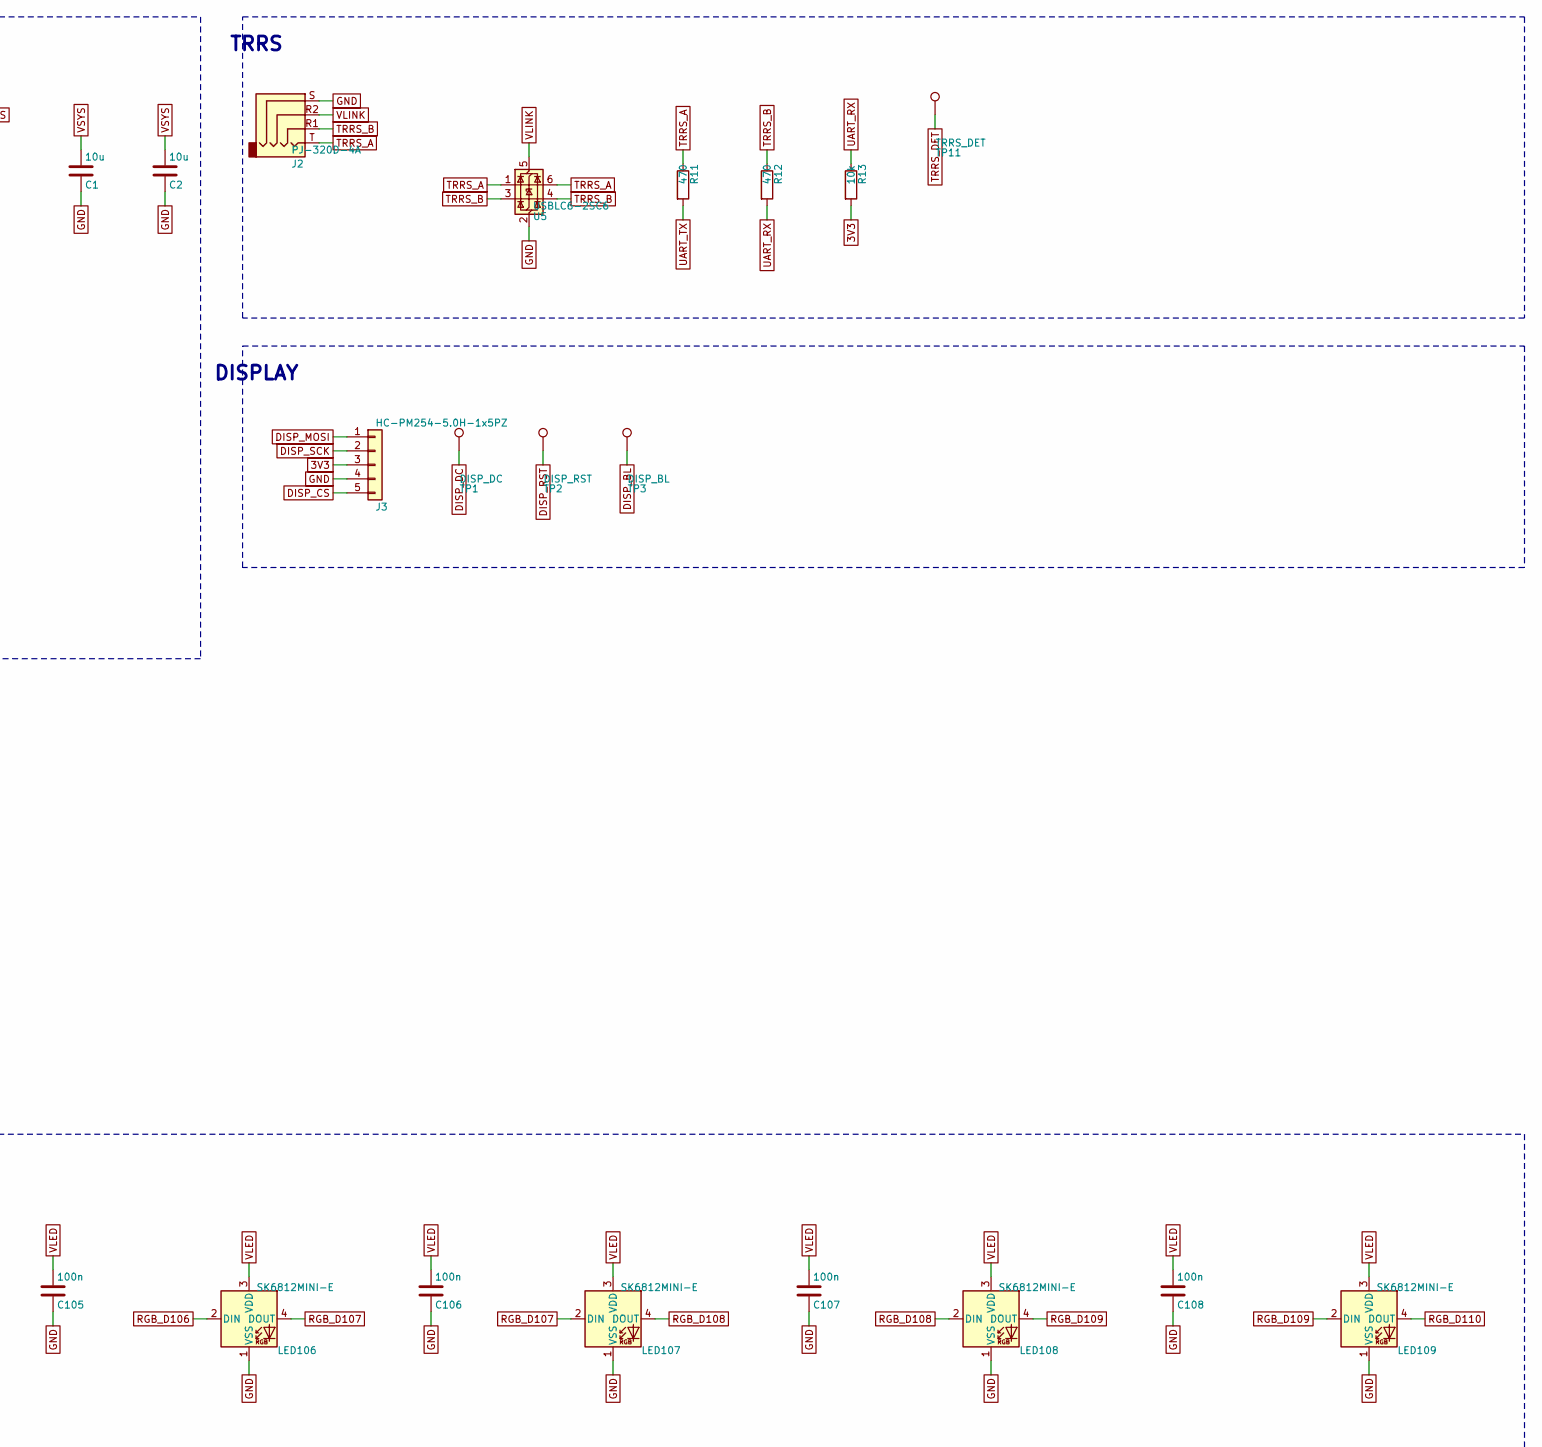
[picture p33: schematic worxboard-left.kicad_sch, worxboard left half, part in row 1, column 3]

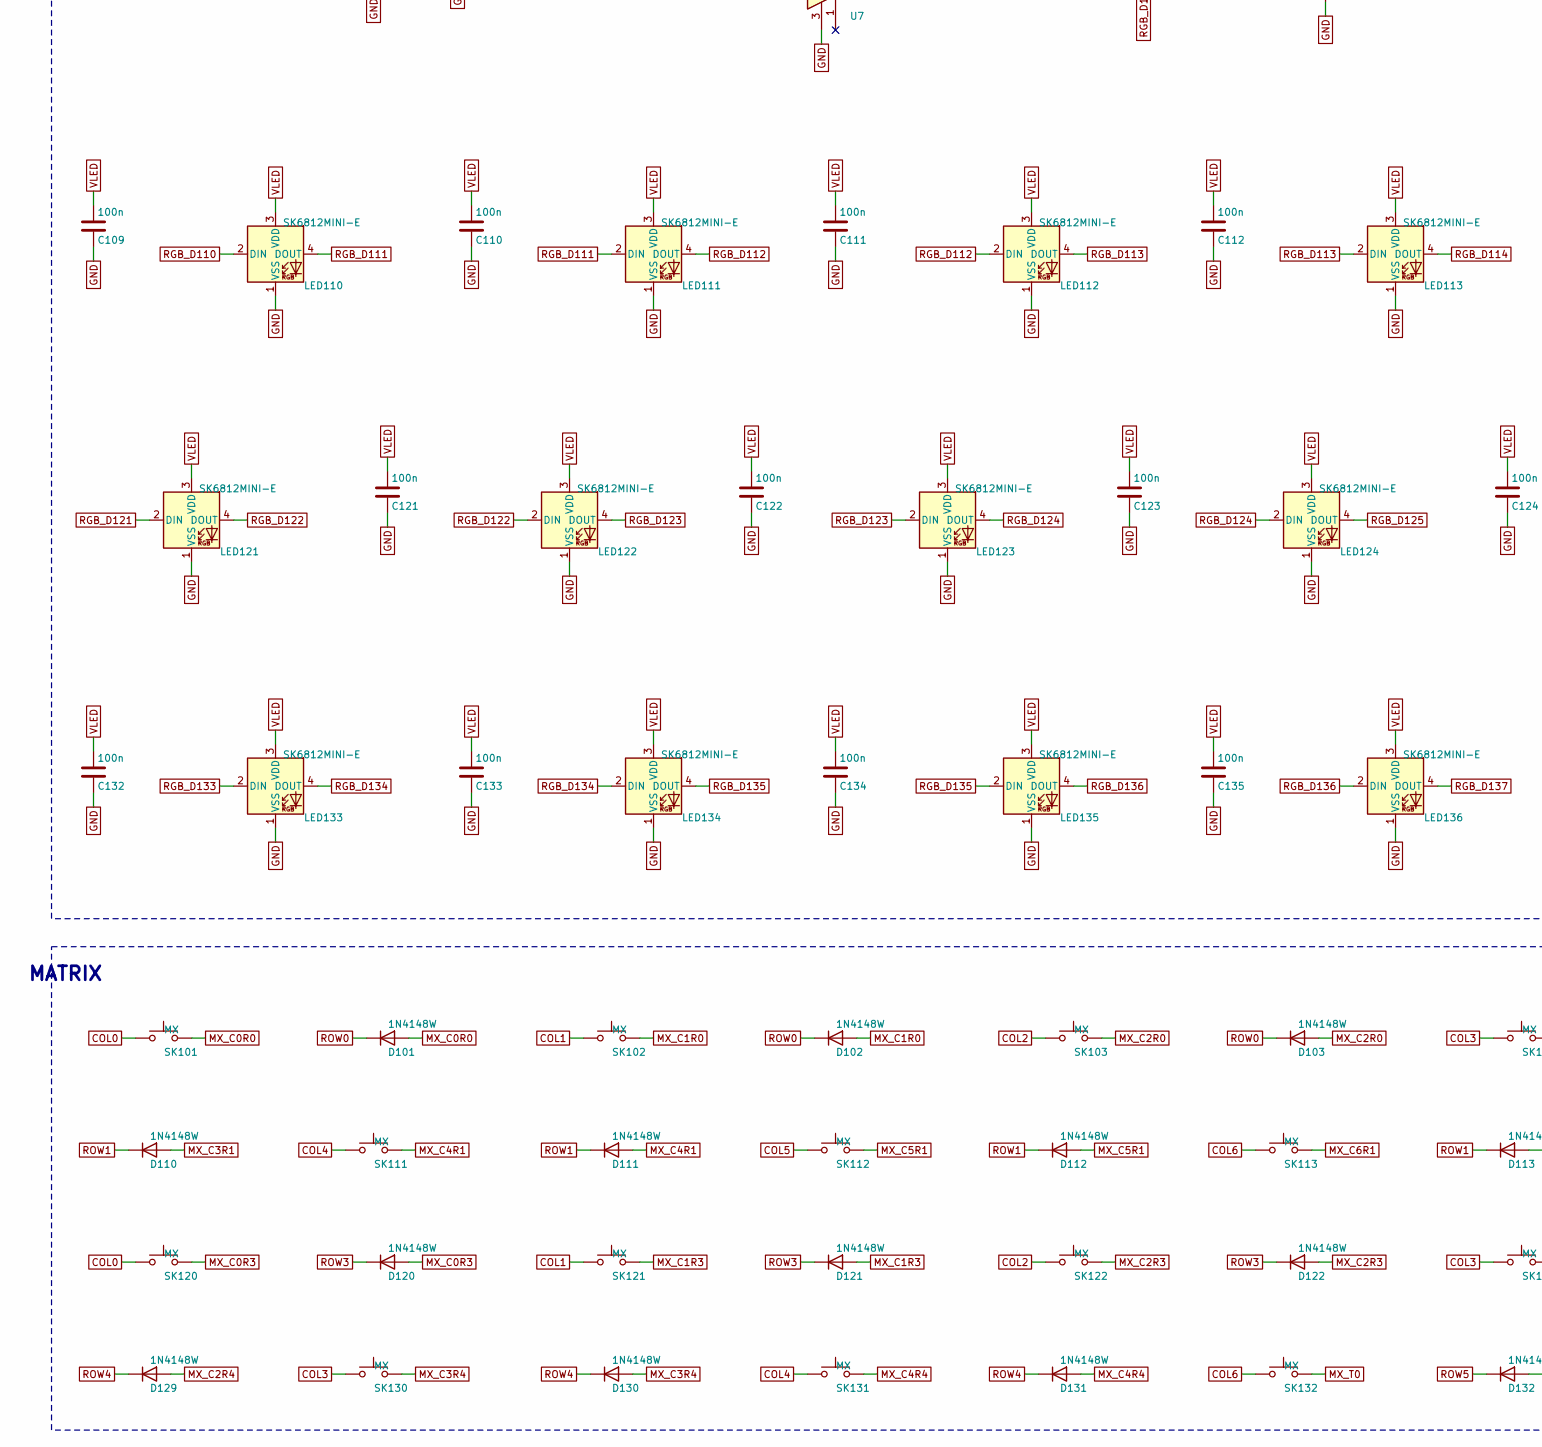
[picture p34: schematic worxboard-left.kicad_sch, worxboard left half, part in row 2, column 1]

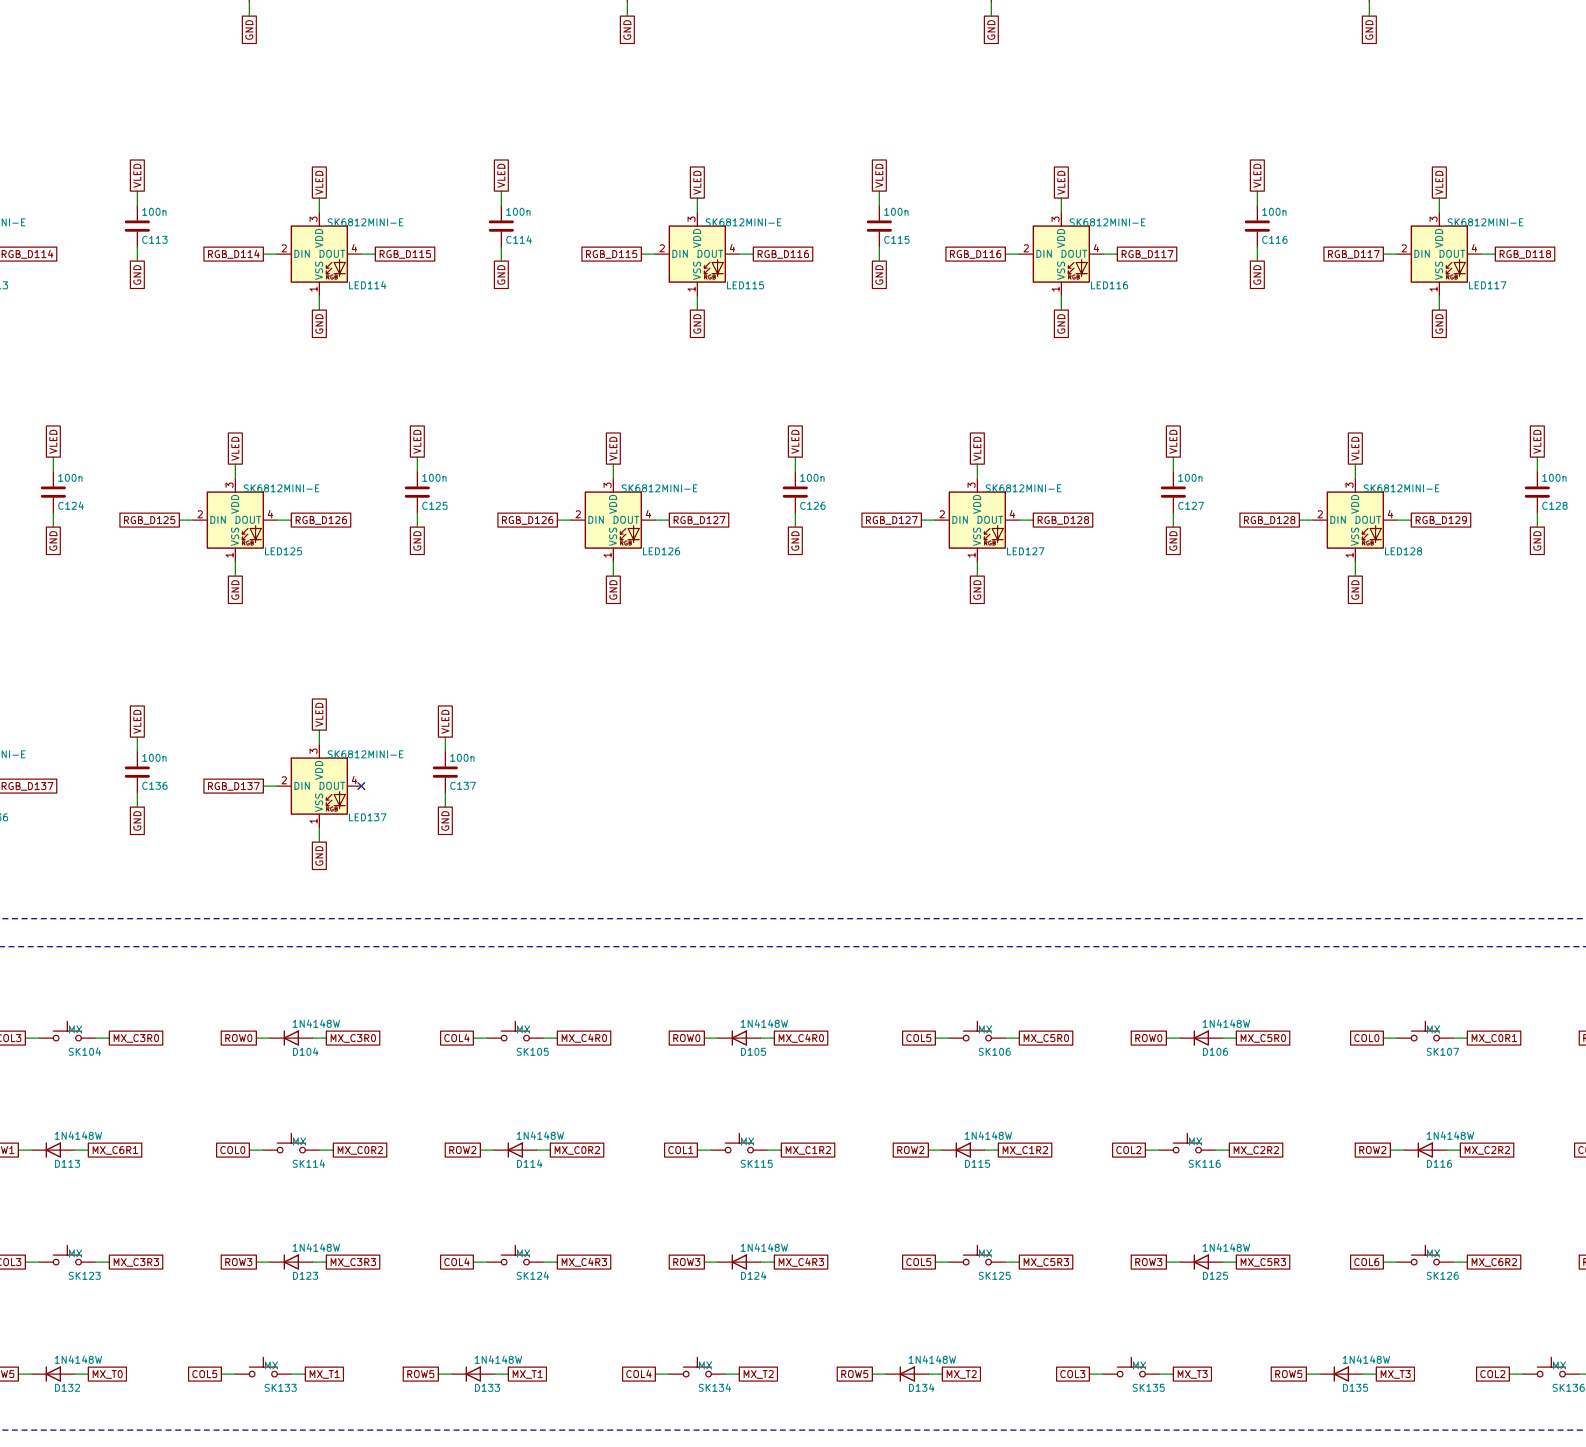
[picture p35: schematic worxboard-left.kicad_sch, worxboard left half, part in row 2, column 2]

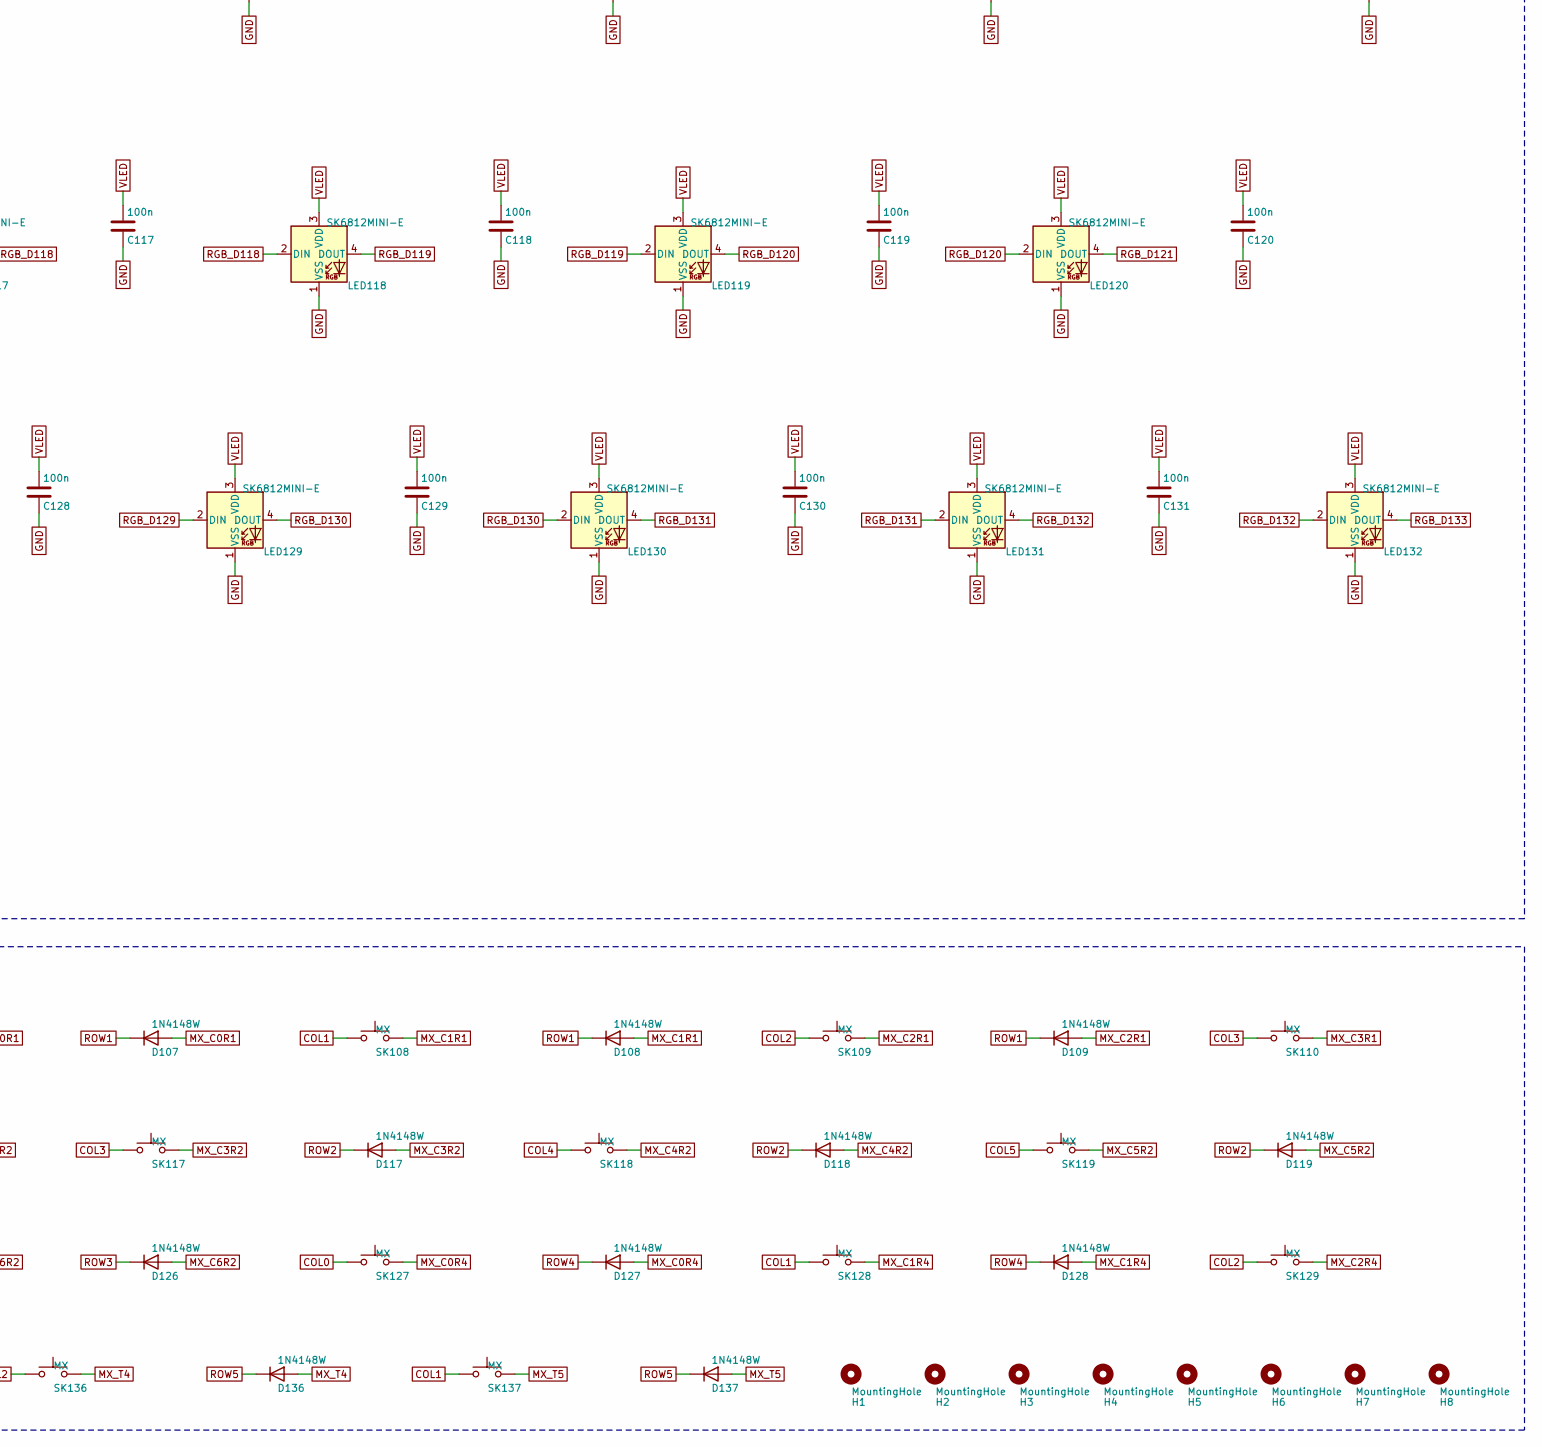
[picture p36: schematic worxboard-left.kicad_sch, worxboard left half, part in row 2, column 3]

Parts:
C1, C2, C3, C20, C21: 10u; C_0603_1608Metric; LCSC C19702
C4, C18, C19: 1u; C_0402_1005Metric; LCSC C52923
C5, C8, C9, C10, C11, C12, C13, C14, C15, C16, C17, C22, C101, C102, C103, C104, C105, C106, C107, C108, C109, C110, C111, C112, C113, C114, C115, C116, C117, C118, C119, C120, C121, C122, C123, C124, C125, C126, C127, C128, C129, C130, C131, C132, C133, C134, C135, C136, C137: 100n; C_0402_1005Metric; LCSC C1525
C6, C7: 27p; C_0402_1005Metric; LCSC C1557
D1: B5819W; D_SOD-123; LCSC C8598
D101, D102, D103, D104, D105, D106, D107, D108, D109, D110, D111, D112, D113, D114, D115, D116, D117, D118, D119, D120, D121, D122, D123, D124, D125, D126, D127, D128, D129, D130, D131, D132, D133, D134, D135, D136, D137: 1N4148W; D_SOD-123; LCSC C81598
F1: 500mA; Fuse_1206_3216Metric; LCSC C70076
H1, H2, H3, H4, H5, H6, H7, H8: MountingHole; MountingHole_2.7mm_M2.5
J1: TYPE-C-31-M-12; USB_C_Receptacle_HRO_TYPE-C-31-M-12; LCSC C165948
J2: PJ-320D-4A; Jack_3.5mm_PJ320D_Horizontal; LCSC C95562
J3: HC-PM254-5.0H-1x5PZ; PinSocket_1x05_P2.54mm_Vertical_H5.0mm; LCSC C27985230
JP1: VLINK; SolderJumper-2_P1.3mm_Bridged_RoundedPad1.0x1.5mm
LED101, LED102, LED103, LED104, LED105, LED106, LED107, LED108, LED109, LED110, LED111, LED112, LED113, LED114, LED115, LED116, LED117, LED118, LED119, LED120, LED121, LED122, LED123, LED124, LED125, LED126, LED127, LED128, LED129, LED130, LED131, LED132, LED133, LED134, LED135, LED136, LED137: SK6812MINI-E; LED_SK6812MINI-E_ReverseMount; LCSC C5149201
R1, R2: 5.1k; R_0402_1005Metric; LCSC C25905
R3, R4: 27; R_0402_1005Metric; LCSC C2909343
R5, R6, R8, R10, R13, R15: 10k; R_0402_1005Metric; LCSC C25744
R7, R9: 1k; R_0402_1005Metric; LCSC C11702
R11, R12, R16: 470; R_0402_1005Metric; LCSC C25117
R14: 15k; R_0402_1005Metric; LCSC C25756
SK101, SK102, SK103, SK104, SK105, SK106, SK107, SK108, SK109, SK110, SK111, SK112, SK113, SK114, SK115, SK116, SK117, SK118, SK119, SK120, SK121, SK122, SK123, SK124, SK125, SK126, SK127, SK128, SK129, SK130, SK131, SK132, SK133, SK134, SK135, SK136, SK137: MX; SW_MX_Hotswap_Kailh; LCSC C41430893
SW1: BOOT; SW_SPST_TS-1088-xR020; LCSC C455280
SW2: RESET; SW_SPST_TS-1088-xR020; LCSC C455280
TP1: DISP_DC; TestPoint_Pad_D1.0mm
TP2: DISP_RST; TestPoint_Pad_D1.0mm
TP3: DISP_BL; TestPoint_Pad_D1.0mm
TP6: TP6; TestPoint_Pad_D1.0mm
TP7: TP7; TestPoint_Pad_D1.0mm
TP8: SWCLK; TestPoint_Pad_D1.0mm
TP9: SWDIO; TestPoint_Pad_D1.0mm
TP10: GND; TestPoint_Pad_D1.0mm
TP11: TRRS_DET; TestPoint_Pad_D1.0mm
U1: RP2040; QFN-56-1EP_7x7mm_P0.4mm_EP3.2x3.2mm; LCSC C2040
U2: W25Q128JVSIQ; SOIC-8_5.3x5.3mm_P1.27mm; LCSC C97521
U3: AP2112K-3.3; SOT-23-5; LCSC C51118
U4, U5: USBLC6-2SC6; SOT-23-6; LCSC C7519
U6: SY6280AAC; SOT-23-5; LCSC C55136
U7: SN74LV1T34DBVR; SOT-23-5; LCSC C100024
Y1: 12MHz; Crystal_SMD_3225-4Pin_3.2x2.5mm; LCSC C49304726

Connections:
1V1: C16.1, C17.1, C19.1, U1.23 (DVDD), U1.45 (VREG_VOUT), U1.50 (DVDD)
3V3: C3.1, C4.1, C5.1, C8.1, C9.1, C10.1, C11.1, C12.1, C13.1, C14.1, C15.1, C18.1, J3.3, R8.2, R10.2, R13.2, U1.1 (IOVDD), U1.10 (IOVDD), U1.22 (IOVDD), U1.33 (IOVDD), U1.42 (IOVDD), U1.43 (ADC_AVDD), U1.44 (VREG_VIN), U1.48 (USB_VDD), U1.49 (IOVDD), U2.8 (VCC), U3.5 (VOUT)
BOOT: R9.2, SW1.1
CC1: J1.A5 (CC1), R1.1
CC2: J1.B5 (CC2), R2.1
COL0: SK101.1, SK107.1, SK114.1, SK120.1, SK127.1, U1.17 (GPIO14)
COL1: SK102.1, SK108.1, SK115.1, SK121.1, SK128.1, SK137.1, U1.18 (GPIO15)
COL2: SK103.1, SK109.1, SK116.1, SK122.1, SK129.1, SK136.1, U1.27 (GPIO16)
COL3: SK104.1, SK110.1, SK117.1, SK123.1, SK130.1, SK135.1, U1.28 (GPIO17)
COL4: SK105.1, SK111.1, SK118.1, SK124.1, SK131.1, SK134.1, U1.29 (GPIO18)
COL5: SK106.1, SK112.1, SK119.1, SK125.1, SK133.1, U1.30 (GPIO19)
COL6: SK113.1, SK126.1, SK132.1, U1.31 (GPIO20)
DISP_BL: TP3.1, U1.9 (GPIO7)
DISP_CS: J3.5, U1.7 (GPIO5)
DISP_DC: TP1.1, U1.6 (GPIO4)
DISP_MOSI: J3.1, U1.5 (GPIO3)
DISP_RST: TP2.1, U1.8 (GPIO6)
DISP_SCK: J3.2, U1.4 (GPIO2)
GND: C1.2, C2.2, C3.2, C4.2, C5.2, C6.2, C7.2, C8.2, C9.2, C10.2, C11.2, C12.2, C13.2, C14.2, C15.2, C16.2, C17.2, C18.2, C19.2, C20.2, C21.2, C22.2, C101.2, C102.2, C103.2, C104.2, C105.2, C106.2, C107.2, C108.2, C109.2, C110.2, C111.2, C112.2, C113.2, C114.2, C115.2, C116.2, C117.2, C118.2, C119.2, C120.2, C121.2, C122.2, C123.2, C124.2, C125.2, C126.2, C127.2, C128.2, C129.2, C130.2, C131.2, C132.2, C133.2, C134.2, C135.2, C136.2, C137.2, J1.A1 (GND), J1.A12 (GND), J1.B1 (GND), J1.B12 (GND), J1.SH (SHIELD), J2.S, J3.4, LED101.1 (VSS), LED102.1 (VSS), LED103.1 (VSS), LED104.1 (VSS), LED105.1 (VSS), LED106.1 (VSS), LED107.1 (VSS), LED108.1 (VSS), LED109.1 (VSS), LED110.1 (VSS), LED111.1 (VSS), LED112.1 (VSS), LED113.1 (VSS), LED114.1 (VSS), LED115.1 (VSS), LED116.1 (VSS), LED117.1 (VSS), LED118.1 (VSS), LED119.1 (VSS), LED120.1 (VSS), LED121.1 (VSS), LED122.1 (VSS), LED123.1 (VSS), LED124.1 (VSS), LED125.1 (VSS), LED126.1 (VSS), LED127.1 (VSS), LED128.1 (VSS), LED129.1 (VSS), LED130.1 (VSS), LED131.1 (VSS), LED132.1 (VSS), LED133.1 (VSS), LED134.1 (VSS), LED135.1 (VSS), LED136.1 (VSS), LED137.1 (VSS), R1.2, R2.2, R6.2, R14.2, R15.2, SW1.2, SW2.2, TP10.1, U1.19 (TESTEN), U1.57 (GND), U2.4 (GND), U3.2 (GND), U4.2 (GND), U5.2 (GND), U6.2 (GND), U7.3 (GND), Y1.2 (G), Y1.4 (G)
MX_C0R0: D101.2 (A), SK101.2
MX_C0R1: D107.2 (A), SK107.2
MX_C0R2: D114.2 (A), SK114.2
MX_C0R3: D120.2 (A), SK120.2
MX_C0R4: D127.2 (A), SK127.2
MX_C1R0: D102.2 (A), SK102.2
MX_C1R1: D108.2 (A), SK108.2
MX_C1R2: D115.2 (A), SK115.2
MX_C1R3: D121.2 (A), SK121.2
MX_C1R4: D128.2 (A), SK128.2
MX_C2R0: D103.2 (A), SK103.2
MX_C2R1: D109.2 (A), SK109.2
MX_C2R2: D116.2 (A), SK116.2
MX_C2R3: D122.2 (A), SK122.2
MX_C2R4: D129.2 (A), SK129.2
MX_C3R0: D104.2 (A), SK104.2
MX_C3R1: D110.2 (A), SK110.2
MX_C3R2: D117.2 (A), SK117.2
MX_C3R3: D123.2 (A), SK123.2
MX_C3R4: D130.2 (A), SK130.2
MX_C4R0: D105.2 (A), SK105.2
MX_C4R1: D111.2 (A), SK111.2
MX_C4R2: D118.2 (A), SK118.2
MX_C4R3: D124.2 (A), SK124.2
MX_C4R4: D131.2 (A), SK131.2
MX_C5R0: D106.2 (A), SK106.2
MX_C5R1: D112.2 (A), SK112.2
MX_C5R2: D119.2 (A), SK119.2
MX_C5R3: D125.2 (A), SK125.2
MX_C6R1: D113.2 (A), SK113.2
MX_C6R2: D126.2 (A), SK126.2
MX_T0: D132.2 (A), SK132.2
MX_T1: D133.2 (A), SK133.2
MX_T2: D134.2 (A), SK134.2
MX_T3: D135.2 (A), SK135.2
MX_T4: D136.2 (A), SK136.2
MX_T5: D137.2 (A), SK137.2
QSPI_SCLK: U1.52 (QSPI_SCLK), U2.6 (CLK)
QSPI_SD0: U1.53 (QSPI_SD0), U2.5 (DI/IO_{0})
QSPI_SD1: U1.55 (QSPI_SD1), U2.2 (DO/IO_{1})
QSPI_SD2: U1.54 (QSPI_SD2), U2.3 (~WP/IO_{2})
QSPI_SD3: U1.51 (QSPI_SD3), U2.7 (~HOLD/~RESET/IO_{3})
QSPI_SS: R8.1, R9.1, U1.56 (~QSPI_SS), U2.1 (~CS)
RGB_BUF: R16.1, U7.4
RGB_D101: LED101.2 (DIN), R16.2
RGB_D102: LED101.4 (DOUT), LED102.2 (DIN)
RGB_D103: LED102.4 (DOUT), LED103.2 (DIN)
RGB_D104: LED103.4 (DOUT), LED104.2 (DIN)
RGB_D105: LED104.4 (DOUT), LED105.2 (DIN)
RGB_D106: LED105.4 (DOUT), LED106.2 (DIN)
RGB_D107: LED106.4 (DOUT), LED107.2 (DIN)
RGB_D108: LED107.4 (DOUT), LED108.2 (DIN)
RGB_D109: LED108.4 (DOUT), LED109.2 (DIN)
RGB_D110: LED109.4 (DOUT), LED110.2 (DIN)
RGB_D111: LED110.4 (DOUT), LED111.2 (DIN)
RGB_D112: LED111.4 (DOUT), LED112.2 (DIN)
RGB_D113: LED112.4 (DOUT), LED113.2 (DIN)
RGB_D114: LED113.4 (DOUT), LED114.2 (DIN)
RGB_D115: LED114.4 (DOUT), LED115.2 (DIN)
RGB_D116: LED115.4 (DOUT), LED116.2 (DIN)
RGB_D117: LED116.4 (DOUT), LED117.2 (DIN)
RGB_D118: LED117.4 (DOUT), LED118.2 (DIN)
RGB_D119: LED118.4 (DOUT), LED119.2 (DIN)
RGB_D120: LED119.4 (DOUT), LED120.2 (DIN)
RGB_D121: LED120.4 (DOUT), LED121.2 (DIN)
RGB_D122: LED121.4 (DOUT), LED122.2 (DIN)
RGB_D123: LED122.4 (DOUT), LED123.2 (DIN)
RGB_D124: LED123.4 (DOUT), LED124.2 (DIN)
RGB_D125: LED124.4 (DOUT), LED125.2 (DIN)
RGB_D126: LED125.4 (DOUT), LED126.2 (DIN)
RGB_D127: LED126.4 (DOUT), LED127.2 (DIN)
RGB_D128: LED127.4 (DOUT), LED128.2 (DIN)
RGB_D129: LED128.4 (DOUT), LED129.2 (DIN)
RGB_D130: LED129.4 (DOUT), LED130.2 (DIN)
RGB_D131: LED130.4 (DOUT), LED131.2 (DIN)
RGB_D132: LED131.4 (DOUT), LED132.2 (DIN)
RGB_D133: LED132.4 (DOUT), LED133.2 (DIN)
RGB_D134: LED133.4 (DOUT), LED134.2 (DIN)
RGB_D135: LED134.4 (DOUT), LED135.2 (DIN)
RGB_D136: LED135.4 (DOUT), LED136.2 (DIN)
RGB_D137: LED136.4 (DOUT), LED137.2 (DIN)
RGB_DIN: U1.34 (GPIO22), U7.2
RGB_EN: R15.1, U1.35 (GPIO23), U6.4 (EN)
ROW0: D101.1 (K), D102.1 (K), D103.1 (K), D104.1 (K), D105.1 (K), D106.1 (K), U1.11 (GPIO8)
ROW1: D107.1 (K), D108.1 (K), D109.1 (K), D110.1 (K), D111.1 (K), D112.1 (K), D113.1 (K), U1.12 (GPIO9)
ROW2: D114.1 (K), D115.1 (K), D116.1 (K), D117.1 (K), D118.1 (K), D119.1 (K), U1.13 (GPIO10)
ROW3: D120.1 (K), D121.1 (K), D122.1 (K), D123.1 (K), D124.1 (K), D125.1 (K), D126.1 (K), U1.14 (GPIO11)
ROW4: D127.1 (K), D128.1 (K), D129.1 (K), D130.1 (K), D131.1 (K), U1.15 (GPIO12)
ROW5: D132.1 (K), D133.1 (K), D134.1 (K), D135.1 (K), D136.1 (K), D137.1 (K), U1.16 (GPIO13)
RUN: R10.1, SW2.1, U1.26 (RUN)
SWCLK: TP8.1, U1.24 (SWCLK)
SWDIO: TP9.1, U1.25 (SWDIO)
TP6: TP6.1, U1.36 (GPIO24)
TP7: TP7.1, U1.37 (GPIO25)
TRRS_A: J2.T, R11.1, U5.1 (I/O1), U5.6 (I/O1)
TRRS_B: J2.R1, R12.1, U5.3 (I/O2), U5.4 (I/O2)
TRRS_DET: TP11.1, U1.32 (GPIO21)
UART_RX: R12.2, R13.1, U1.3 (GPIO1)
UART_TX: R11.2, U1.2 (GPIO0)
USB_C_DM: J1.A7 (D-), J1.B7 (D-), R4.1, U4.3 (I/O2), U4.4 (I/O2)
USB_C_DP: J1.A6 (D+), J1.B6 (D+), R3.1, U4.1 (I/O1), U4.6 (I/O1)
USB_DM: R4.2, U1.46 (USB_DM)
USB_DP: R3.2, U1.47 (USB_DP)
VBUS: D1.2 (A), J1.A4 (VBUS), J1.A9 (VBUS), J1.B4 (VBUS), J1.B9 (VBUS), R5.1
VBUS_SENSE: R5.2, R6.1, U1.38 (GPIO26/ADC0)
VLED: C20.1, C22.1, C101.1, C102.1, C103.1, C104.1, C105.1, C106.1, C107.1, C108.1, C109.1, C110.1, C111.1, C112.1, C113.1, C114.1, C115.1, C116.1, C117.1, C118.1, C119.1, C120.1, C121.1, C122.1, C123.1, C124.1, C125.1, C126.1, C127.1, C128.1, C129.1, C130.1, C131.1, C132.1, C133.1, C134.1, C135.1, C136.1, C137.1, LED101.3 (VDD), LED102.3 (VDD), LED103.3 (VDD), LED104.3 (VDD), LED105.3 (VDD), LED106.3 (VDD), LED107.3 (VDD), LED108.3 (VDD), LED109.3 (VDD), LED110.3 (VDD), LED111.3 (VDD), LED112.3 (VDD), LED113.3 (VDD), LED114.3 (VDD), LED115.3 (VDD), LED116.3 (VDD), LED117.3 (VDD), LED118.3 (VDD), LED119.3 (VDD), LED120.3 (VDD), LED121.3 (VDD), LED122.3 (VDD), LED123.3 (VDD), LED124.3 (VDD), LED125.3 (VDD), LED126.3 (VDD), LED127.3 (VDD), LED128.3 (VDD), LED129.3 (VDD), LED130.3 (VDD), LED131.3 (VDD), LED132.3 (VDD), LED133.3 (VDD), LED134.3 (VDD), LED135.3 (VDD), LED136.3 (VDD), LED137.3 (VDD), U6.1 (OUT), U7.5 (VCC)
VLED_ISET: R14.1, U6.3 (ISET)
VLINK: F1.2, J2.R2, U5.5 (VBUS)
VLINK_JP: F1.1, JP1.2 (B)
VSYS: C1.1, C2.1, C21.1, D1.1 (K), JP1.1 (A), U3.1 (VIN), U3.3 (EN), U4.5 (VBUS), U6.5 (IN)
XIN: C6.1, U1.20 (XIN), Y1.1
XOUT: R7.2, U1.21 (XOUT)
XTAL_OUT: C7.1, R7.1, Y1.3

Notes on the sheet:
MCU
USB-POWER
TRRS
DISPLAY
RGB
MATRIX

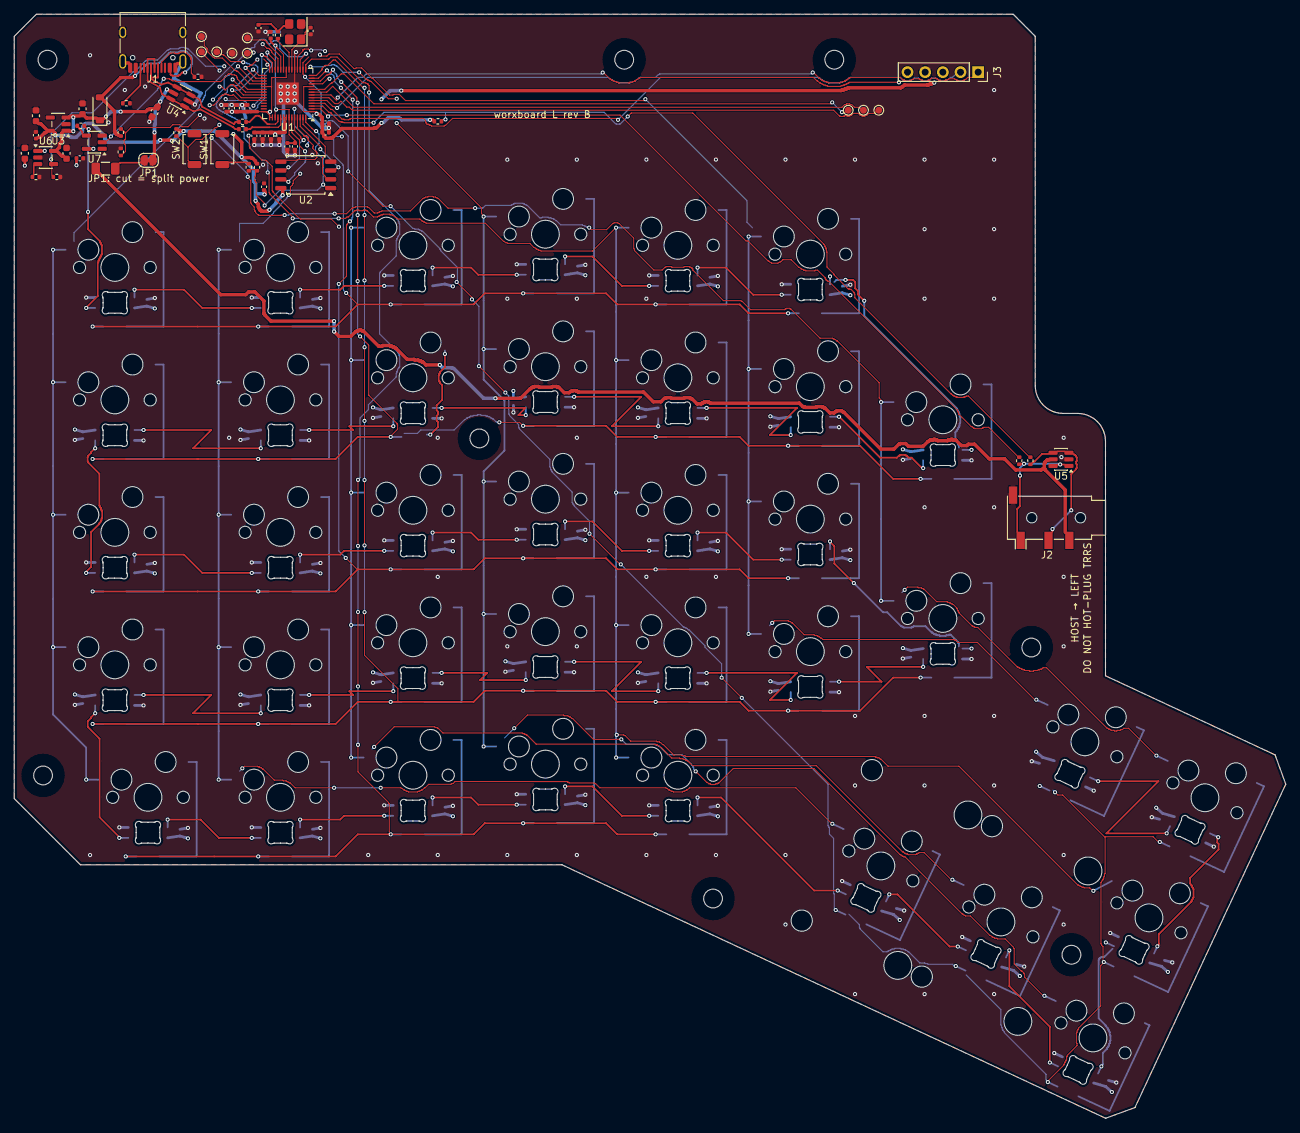
[picture p37: board worxboard-left.kicad_pcb from above]

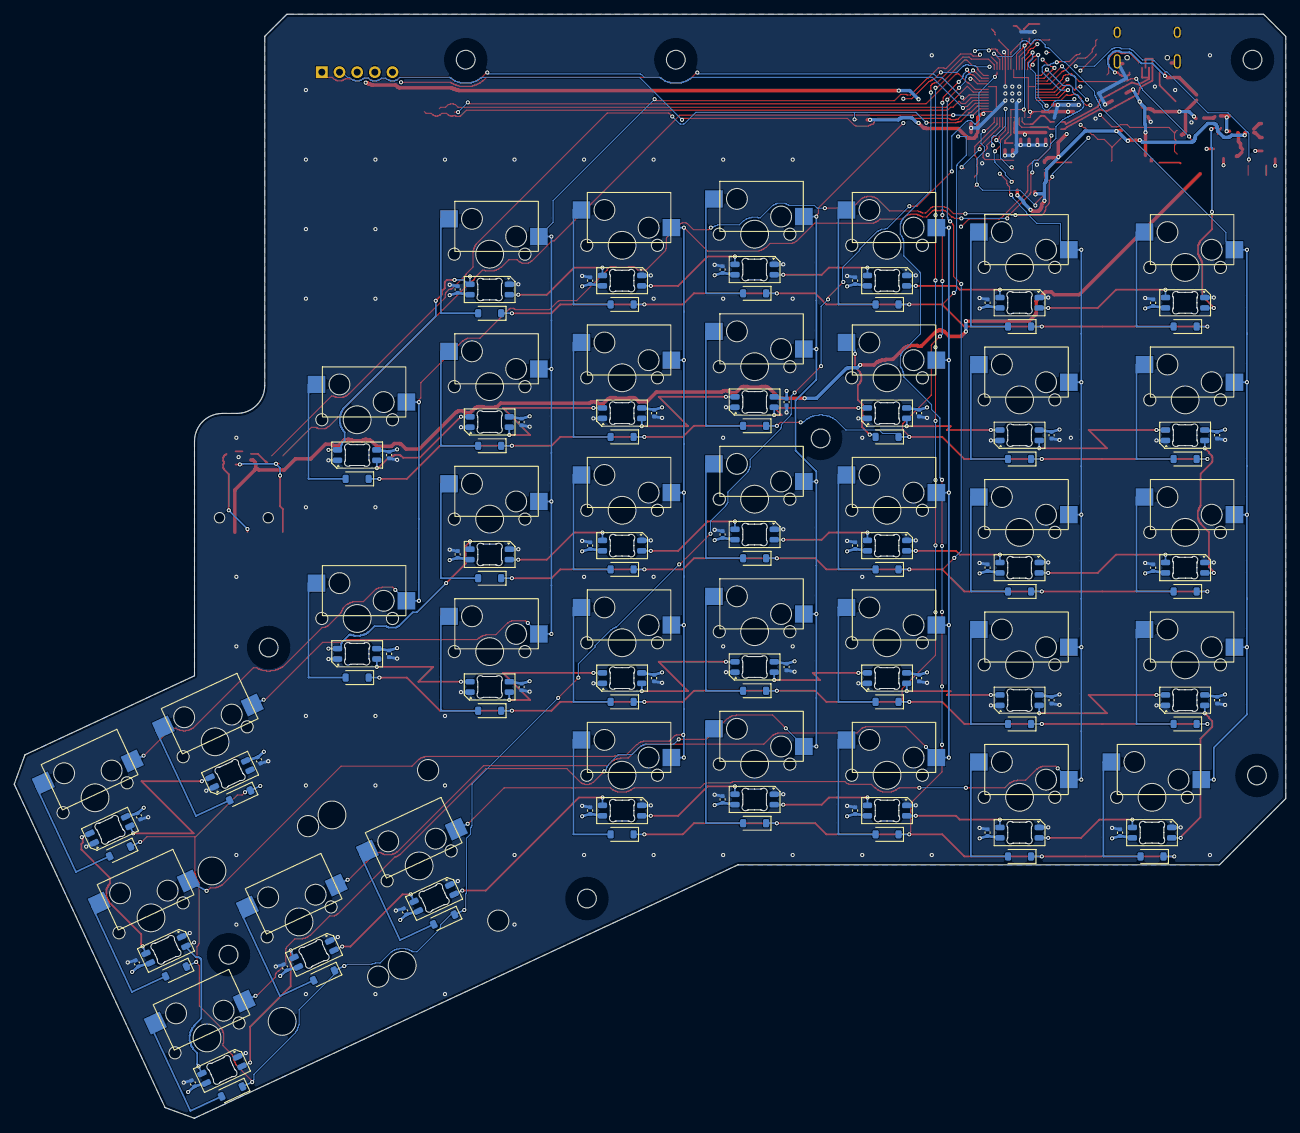
[picture p38: board worxboard-left.kicad_pcb from below]

Board: 4 copper layers, 182.8 x 158.8 mm, 221 parts (148 on the bottom side), 132 nets.

Other parts of the board:
STAB_T4, STAB_T5: Stab_MX_2u
