w0rxbend/worxboard/pcb/scripts/checks.py

# SPDX-License-Identifier: GPL-3.0-or-later
"""Scripted board checks after routing (spec §9 stage 12).

    python3 pcb/scripts/checks.py <side>     (reads pcb/<side>/*.kicad_pcb and build/<side>/drc.json)

- USB: each line's copper path from the U1 pin to the nearest J1 pin of its net (through
  R3/R4 and the U4 pass-through) is <= USB_MAX_MM, and D+ / D- differ by <= USB_SKEW_MM;
- Y1: its courtyard lies within Y1_MAX_MM of the U1 XIN / XOUT pads, and no B.Cu track or via
  runs under it (its keepout);
- decoupling (spec §6.4): every RP2040 supply pin reaches a cap of its net within PIN_CAP_MAX_MM
  of copper, every supply cap (C8-C19) reaches a U1 supply pin within CAP_PIN_MAX_MM, and each
  cap's GND pad has a via within CAP_GND_VIA_MM;
- U4's VSYS clamp reference (pin 5) reaches a VSYS cap within U4_CAP_MAX_MM of copper;
- U1 GND (deviations BOARD-9, BOARD-14), as the shortest GND copper path (both layers: pours,
  tracks, vias and pads, on a GND_RET_GRID raster within GND_RET_WIN of U1, GND_RET_VIA_MM charged
  per layer change): U1's exposed pad (the RP2040's only GND pin) reaches the main B.Cu GND plane (the
  largest filled B.Cu GND area) within EP_PLANE_MAX_MM, and each U1 cap's GND pad reaches the exposed
  pad within GND_RET_MAX_MM (its decoupling loop). Which EP and cap GND vias sit in the main plane
  over B.Cu alone is printed, not gated;
- U1 GND links (deviations ORDER-4): the exposed pad reaches the edge of a window GND_LINK_WIN either
  side of U1 by GND_LINKS_MIN separate paths (GND_LINK_APART apart, no shared via) over GND copper about
  GND_NECK_W wide or wider, each at most GND_LINK_MAX_MM;
  U4's clamp GND (pin 2) reaches a J1 GND pad, and the flash cap C5's GND pad reaches U2's GND pin,
  within GND_PIN_MAX_MM of GND copper;
- no via overlaps an SMD pad (the U1 exposed pad's thermal vias excepted);
- pin-in-paste: J1's four through-hole shell legs are on the paste layer (pin_in_paste.py, deviations
  ORDER-1), so JLC's stencil opens them;
- per-key RGB (rev B, deviations REVB-1): every LED<n> sits on B.Cu at layout.json's leds[n] (its
  switch's LED window) with its own Edge.Cuts cutout, its DIN -> DOUT runs towards the next LED, and
  its 100 nF C<n> reaches the LED's VDD pad within LED_CAP_MAX_MM of VLED copper;
- Edge.Cuts: every outline vertex equals layout/build/layout.json within EDGE_TOL_MM;
- DRC: build/<side>/drc.json lists 0 unconnected items and no error-level violations.
"""
from __future__ import annotations

import heapq
import json
import math
import sys
from collections import defaultdict
from pathlib import Path

ROOT = Path(__file__).resolve().parents[2]
sys.path.insert(0, str(Path(__file__).resolve().parent))

import pcbnew  # noqa: E402
from shapely.geometry import Point, Polygon  # noqa: E402

import complete_routes  # noqa: E402
from complete_routes import vias_in_pads  # noqa: E402
from place import layout_side  # noqa: E402
import pin_in_paste  # noqa: E402

USB_MAX_MM = 25.0
USB_SKEW_MM = 1.0
Y1_MAX_MM = 3.0
EDGE_TOL_MM = 0.01
RASTER_LAYERS = (pcbnew.F_Cu, pcbnew.B_Cu, pcbnew.In1_Cu)   # GndRaster: both outer layers and the GND plane
SNAP = 1e-3                  # mm, track end-point identity
USB_LINES = {"D+": (("USB_DP", "USB_C_DP"), "47"), "D-": (("USB_DM", "USB_C_DM"), "46")}
XTAL_PINS = ("20", "21")   # RP2040 XIN, XOUT
SERIES = ("R3", "R4")        # series resistors: their two pads count as joined
SUPPLY_NETS = ("3V3", "1V1")
U1_CAPS = tuple(f"C{n}" for n in range(8, 20))   # design._mcu: IOVDD, USB/ADC, DVDD, VREG caps
# Copper path limits (pad centre to pad centre). The IOVDD pins 10, 22 and 33 and VREG_VOUT 45 are
# joined to an exit inside the pad ring, so their caps sit at that exit (deviations WS2b-5,
# REVIEW-FIX-2); pin 22 is the furthest, around the east moat.
PIN_CAP_MAX_MM = 12.0
CAP_PIN_MAX_MM = 7.0
CAP_GND_VIA_MM = 1.0
# U1 GND over GND copper (deviations BOARD-14)
GND_RET_GRID = 0.1           # mm raster
GND_RET_WIN = 16.0           # mm either side of the U1 centre; a path that needs to leave it fails
GND_RET_GROW = 0.03          # mm: copper grown so that thin joins survive the raster
GND_RET_VIA_MM = 1.6         # mm charged per layer change (the board thickness)
GND_RET_MAX_MM = 20.0        # each U1 cap's GND pad -> the exposed pad (its decoupling loop)
EP_PLANE_MAX_MM = 8.0        # the exposed pad -> the main B.Cu GND plane
MAIN_PLANE_MIN_MM2 = 2000.0  # a B.Cu GND island this large counts as the main plane (rev B, REVB-7)
# U1 GND links and the GND pins near U1 (deviations ORDER-4): a single thin track and one via once tied
# the left EP, U2, U4 and 11 caps to the planes
GND_NECK_W = 0.4             # mm: a link counts only over copper about this wide or wider ...
GND_NECK_ERODE = 0.155       # ... the raster copper shrunk by this (less GND_RET_GROW): a 0.4 mm track
                             # keeps 0.15 mm (8-neighbour connected at 0.1 mm), a 0.3 mm track breaks up
GND_LINK_WIN = 24.0          # mm: links run from the EP to the edge of this window either side of U1
GND_LINK_APART = 0.2         # mm: each next link keeps this clear of the earlier ones
GND_LINKS_MIN = 2            # separate links ...
GND_LINK_MAX_MM = 50.0       # ... each at most this long
GND_LINKS_COUNT = 6          # links searched for (printed)
GND_PIN_PATHS = (("U4 pin 2 (USB ESD clamp) -> J1 GND", "U4.2", ("J1.A1", "J1.A12", "J1.B1", "J1.B12", "J1.SH")),
                 ("C5 (flash cap) GND -> U2 pin 4", "C5.2", ("U2.4",)))
GND_PIN_MAX_MM = 30.0
GND_PIN_WIN = 12.0           # mm: the raster covers both pads' box grown by this
# U4's clamp reference pin 5 is on VSYS (deviations ELEC-2); C2 sits at its via (BOARD-5)
U4_REF = ("U4.5", "VSYS", ("C1.1", "C2.1"))
U4_CAP_MAX_MM = 5.0
# Rev B LEDs
LED_POS_TOL_MM = 0.01
LED_CAP_MAX_MM = 8.0         # VLED copper, LED VDD pad -> its own 100 nF
LED_PADS = {"VSS": "1", "DIN": "2", "VDD": "3", "DOUT": "4"}


def mm_xy(v) -> tuple[float, float]:
    return pcbnew.ToMM(v.x), pcbnew.ToMM(v.y)


def pad_poly(pad: pcbnew.PAD) -> Polygon:
    sps = pad.GetEffectivePolygon(pcbnew.F_Cu if pad.IsOnLayer(pcbnew.F_Cu) else pcbnew.B_Cu, pcbnew.ERROR_INSIDE)
    o = sps.Outline(0)
    return Polygon([mm_xy(o.CPoint(i)) for i in range(o.PointCount())])


def usb_paths(board: pcbnew.BOARD) -> dict[str, float]:
    """Shortest copper path U1 pin -> any J1 pin per USB line (tracks + series resistors)."""
    out = {}
    for name, (nets, u1_pin) in USB_LINES.items():
        codes = {board.FindNet(n).GetNetCode() for n in nets}
        graph: dict[object, list[tuple[object, float]]] = defaultdict(list)

        def node(p):
            return (round(p[0] / SNAP), round(p[1] / SNAP))

        def edge(a, b, w):
            graph[a].append((b, w))
            graph[b].append((a, w))
        ends = []
        for t in board.GetTracks():
            if t.GetNetCode() in codes and t.Type() == pcbnew.PCB_TRACE_T:
                a, b = mm_xy(t.GetStart()), mm_xy(t.GetEnd())
                edge(node(a), node(b), math.dist(a, b))
                ends += [a, b]
            elif t.GetNetCode() in codes and t.Type() == pcbnew.PCB_VIA_T:
                ends.append(mm_xy(t.GetPosition()))
        pads = {}
        for fp in board.GetFootprints():
            for pad in fp.Pads():
                if pad.GetNetCode() in codes:
                    key = (fp.GetReference(), pad.GetNumber(), pad.GetPosition().x, pad.GetPosition().y)
                    pads[key] = pad
                    poly = pad_poly(pad).buffer(SNAP)
                    for e in ends:                      # track ends inside the pad join it
                        if poly.contains(Point(e)):
                            edge(key, node(e), math.dist(e, mm_xy(pad.GetPosition())))
        for (ref, _, _, _), pad in list(pads.items()):
            if ref in SERIES:
                a, b = [k for k in pads if k[0] == ref]
                edge(a, b, math.dist(mm_xy(pads[a].GetPosition()), mm_xy(pads[b].GetPosition())))
                break
        starts = [k for k in pads if k[0] == "U1" and k[1] == u1_pin]
        goals = {k for k in pads if k[0] == "J1"}
        out[name] = dijkstra(graph, starts, goals)
    return out


def dijkstra(graph, starts, goals) -> float:
    dist = {s: 0.0 for s in starts}
    heap = [(0.0, i, s) for i, s in enumerate(starts)]
    n = len(heap)
    while heap:
        d, _, u = heapq.heappop(heap)
        if u in goals:
            return d
        if d > dist.get(u, math.inf):
            continue
        for v, w in graph[u]:
            if d + w < dist.get(v, math.inf):
                dist[v] = d + w
                n += 1
                heapq.heappush(heap, (d + w, n, v))
    return math.inf


def copper_graph(board: pcbnew.BOARD, code: int):
    """Copper of one net as a graph: track ends (joined where an end lies in another track's,
    a via's or a pad's copper, T-junctions split by length), vias and pads (keyed REF.pad)."""
    from shapely.geometry import LineString
    graph: dict[object, list[tuple[object, float]]] = defaultdict(list)

    def edge(a, b, w):
        w = max(0.0, w)          # project() onto a segment end gives -3e-17: a negative cycle that
        graph[a].append((b, w))  # dijkstra() never leaves (killed for memory, ELEC-5)
        graph[b].append((a, w))
    segs, vias = [], []
    for t in board.GetTracks():
        if t.GetNetCode() != code:
            continue
        if t.Type() == pcbnew.PCB_VIA_T:
            vias.append((("via", len(vias)), Point(mm_xy(t.GetPosition())), pcbnew.ToMM(t.GetWidth(pcbnew.F_Cu)) / 2))
        else:
            a, b = mm_xy(t.GetStart()), mm_xy(t.GetEnd())
            segs.append((a, b, t.GetLayer(), LineString([a, b]).buffer(pcbnew.ToMM(t.GetWidth()) / 2 + SNAP)))
    pads = []
    for fp in board.GetFootprints():
        for pad in fp.Pads():
            if pad.GetNetCode() == code:
                layers = [l for l in (pcbnew.F_Cu, pcbnew.B_Cu) if pad.IsOnLayer(l)]
                pads.append((f"{fp.GetReference()}.{pad.GetNumber()}", mm_xy(pad.GetPosition()), layers,
                             pad_poly(pad).buffer(SNAP)))
    for i, (a, b, layer, _) in enumerate(segs):
        edge(("s", i, 0), ("s", i, 1), math.dist(a, b))
        for end, p in ((0, a), (1, b)):
            q = Point(p)
            for j, (c, d, lj, gj) in enumerate(segs):
                if j != i and lj == layer and gj.contains(q):
                    s = LineString([c, d]).project(q)
                    edge(("s", i, end), ("s", j, 0), s)
                    edge(("s", i, end), ("s", j, 1), math.dist(c, d) - s)
            for key, c, r in vias:
                if c.distance(q) <= r + SNAP:
                    edge(("s", i, end), key, 0.0)
            for name, c, layers, poly in pads:
                if layer in layers and poly.contains(q):
                    edge(("s", i, end), name, math.dist(p, c))
    for i, (a, b, layer, _) in enumerate(segs):           # pads and vias a track runs through
        line = LineString([a, b])
        for name, c, layers, poly in pads:
            if layer in layers and line.intersects(poly):
                s = line.project(Point(c))
                edge(name, ("s", i, 0), s + line.distance(Point(c)))
                edge(name, ("s", i, 1), line.length - s + line.distance(Point(c)))
        for key, c, r in vias:
            if line.distance(c) <= r:
                s = line.project(c)
                edge(key, ("s", i, 0), s)
                edge(key, ("s", i, 1), line.length - s)
    for key, c, r in vias:
        for name, pc, _, poly in pads:
            if poly.contains(c):
                edge(key, name, math.dist(pc, (c.x, c.y)))
    return graph


def decoupling(board: pcbnew.BOARD) -> tuple[dict[str, float], dict[str, float], dict[str, float]]:
    """Copper path pin -> nearest cap and cap -> nearest U1 pin per supply net, and cap GND pad ->
    nearest GND via (straight distance)."""
    u1 = board.FindFootprintByReference("U1")
    pin_cap, cap_pin = {}, {}
    for name in SUPPLY_NETS:
        code = board.FindNet(name).GetNetCode()
        graph = copper_graph(board, code)
        pins = [f"U1.{p.GetNumber()}" for p in u1.Pads() if p.GetNetCode() == code]
        caps = [f"{c}.1" for c in U1_CAPS
                if any(p.GetNumber() == "1" and p.GetNetCode() == code for p in board.FindFootprintByReference(c).Pads())]
        for p in sorted(pins, key=lambda p: int(p[3:])):
            pin_cap[f"{name} {p}"] = dijkstra(graph, [p], set(caps))
        for c in caps:
            cap_pin[c[:-2]] = dijkstra(graph, [c], set(pins))
    gnd = board.FindNet("GND").GetNetCode()
    vias = [mm_xy(t.GetPosition()) for t in board.GetTracks() if t.Type() == pcbnew.PCB_VIA_T and t.GetNetCode() == gnd]
    gnd_via = {}
    for c in U1_CAPS:
        pad = next(p for p in board.FindFootprintByReference(c).Pads() if p.GetNumber() == "2")
        gnd_via[c] = min(math.dist(mm_xy(pad.GetPosition()), v) for v in vias)
    return pin_cap, cap_pin, gnd_via


def main_plane(board: pcbnew.BOARD):
    """The GND plane, as geometry: the largest filled piece of the In1 GND zone, or None. On two layers
    this was the largest B.Cu pour island (deviations REVB-7); the inner plane replaces it (REVB-8)."""
    gnd, P = board.FindNet("GND").GetNetCode(), RASTER_LAYERS[2]
    pieces = [g for z in board.Zones() if not z.GetIsRuleArea() and z.GetNetCode() == gnd and z.IsOnLayer(P)
              for g in sps_polys(z.GetFilledPolysList(P))]
    return max(pieces, key=lambda g: g.area) if pieces else None


def u1_gnd(board: pcbnew.BOARD) -> tuple[int, int, list[str], float]:
    """U1's GND vias against the main B.Cu GND plane over B.Cu alone: the B.Cu copper of GND only
    (the saved pour fill, tracks, vias, pads), joined as complete_routes.islands joins it. Returns
    (EP vias in it, EP vias, U1 caps whose GND via is in it, its area in mm2); printed, not gated."""
    gnd, B = board.FindNet("GND").GetNetCode(), pcbnew.B_Cu
    items, _ = complete_routes.collect(board)
    mine = [complete_routes.Item(it.net, {B: it.geoms[B]}, ref=it, pad=it.pad,
                                 anchors={B: (it.anchors or {}).get(B, [])})
            for it in items if it.net == gnd and B in it.geoms]
    pours = [it for it in complete_routes.pour_copper(board) if it.net == gnd and B in it.geoms]
    if not pours:
        return 0, 0, [], 0.0
    main = max(pours, key=lambda it: it.geoms[B].area)
    group = next(g for g in complete_routes.islands(mine + pours, gnd) if any(it is main for it in g))
    joined = {id(it.ref) for it in group if it.ref is not None}
    vias = {it.ref.anchors[B][0]: it for it in mine if not it.pad and len(it.ref.geoms) == len(complete_routes.LAYERS)}
    ep = pad_poly(next(p for p in board.FindFootprintByReference("U1").Pads() if p.GetNumber() == "57"))
    ep_vias = [xy for xy in vias if ep.contains(Point(xy))]
    ep_in = sum(id(vias[xy].ref) in joined for xy in ep_vias)
    caps_in = []
    for c in U1_CAPS:
        pad = next(p for p in board.FindFootprintByReference(c).Pads() if p.GetNumber() == "2")
        xy = min(vias, key=lambda v: math.dist(v, mm_xy(pad.GetPosition())))
        if id(vias[xy].ref) in joined:
            caps_in.append(c)
    return ep_in, len(ep_vias), caps_in, main.geoms[B].area


class GndRaster:
    """The GND copper of both layers (pour fill, tracks, vias, pads) on a GND_RET_GRID raster over a
    window, for shortest GND copper paths: 8-neighbour steps, a hop between the layers inside a via or
    a through-hole pad costs GND_RET_VIA_MM. With `erode`, the copper is shrunk by that much first, so
    only copper about 2 x erode + 1.5 cells wide carries a path (deviations ORDER-4)."""

    def __init__(self, board: pcbnew.BOARD, bounds: tuple[float, float, float, float], erode: float = 0.0):
        import numpy as np
        import shapely
        from shapely.geometry import LineString
        from shapely.ops import unary_union
        F, B, P = RASTER_LAYERS
        gnd = board.FindNet("GND").GetNetCode()
        h = GND_RET_GRID
        x0, y0, x1, y1 = bounds
        xs = np.arange(x0, x1, h)
        ys = np.arange(y0, y1, h)
        X, Y = np.meshgrid(xs, ys)
        geo, hops, pads = {F: [], B: [], P: []}, [], {}
        for z in board.Zones():
            if not z.GetIsRuleArea() and z.GetNetCode() == gnd:
                for layer in RASTER_LAYERS:
                    if z.IsOnLayer(layer):
                        geo[layer] += sps_polys(z.GetFilledPolysList(layer))
        for t in board.GetTracks():
            if t.GetNetCode() != gnd:
                continue
            if t.Type() == pcbnew.PCB_VIA_T:
                disc = Point(mm_xy(t.GetPosition())).buffer(pcbnew.ToMM(t.GetWidth(F)) / 2)
                for layer in RASTER_LAYERS:
                    geo[layer].append(disc)
                hops.append(disc)
            else:
                line = LineString([mm_xy(t.GetStart()), mm_xy(t.GetEnd())])
                geo[t.GetLayer()].append(line.buffer(pcbnew.ToMM(t.GetWidth()) / 2))
        for fp in board.GetFootprints():
            for pad in fp.Pads():
                if pad.GetNetCode() != gnd:
                    continue
                on = [layer for layer in (F, B) if pad.IsOnLayer(layer)]
                for layer in on:
                    for poly in sps_polys(pad.GetEffectivePolygon(layer, pcbnew.ERROR_INSIDE)):
                        geo[layer].append(poly)
                        pads.setdefault(f"{fp.GetReference()}.{pad.GetNumber()}", []).append((layer, poly))
                if len(on) == 2:
                    geo[P] += sps_polys(pad.GetEffectivePolygon(P, pcbnew.ERROR_INSIDE))
                    hops.append(Point(mm_xy(pad.GetPosition())).buffer(pcbnew.ToMM(min(pad.GetSize().x, pad.GetSize().y)) / 2))
        self.X, self.Y, self.pads, self.h = X, Y, pads, h
        self.copper = [shapely.contains_xy(unary_union(geo[layer]).buffer(GND_RET_GROW - erode), X, Y).ravel()
                       for layer in RASTER_LAYERS]
        # the hop (via or through-hole pad) that owns each cell, -1 for none
        self.hop = np.full(X.size, -1, dtype=np.int64)
        ny, nx = X.shape
        win = Polygon([(x0, y0), (x1, y0), (x1, y1), (x0, y1)])
        for k, disc in enumerate(hops):
            if not disc.intersects(win):
                continue
            bx0, by0, bx1, by1 = disc.bounds
            i0, i1 = max(0, int((bx0 - x0) / h)), min(nx, int((bx1 - x0) / h) + 2)
            j0, j1 = max(0, int((by0 - y0) / h)), min(ny, int((by1 - y0) / h) + 2)
            if i0 < i1 and j0 < j1:
                sub = shapely.contains_xy(disc, X[j0:j1, i0:i1], Y[j0:j1, i0:i1])
                view = self.hop.reshape(ny, nx)[j0:j1, i0:i1]
                view[sub] = k

    def cells(self, geom, layer_index: int):
        """Raster cells inside `geom` that carry copper on layer 0 (F.Cu), 1 (B.Cu) or 2 (the In1 plane)."""
        import numpy as np
        import shapely
        return np.flatnonzero(shapely.contains_xy(geom, self.X, self.Y).ravel() & self.copper[layer_index])

    def pad_cells(self, name: str):
        """(layer index, cell) of every copper cell of pad REF.n."""
        out = []
        for layer, poly in self.pads.get(name, []):
            li = 0 if layer == pcbnew.F_Cu else 1
            out += [(li, int(i)) for i in self.cells(poly, li)]
        return out

    def search(self, starts, goals=None):
        """Dijkstra from the (layer, cell) starts. Without goals: the distance arrays of both layers.
        With goals (a set of (layer, cell)): (length, [(layer, cell)] path to the nearest goal), or
        (inf, [])."""
        import numpy as np
        h, nx = self.h, self.X.shape[1]
        ny, size = self.X.shape[0], self.X.size
        dist = [np.full(size, math.inf) for _ in RASTER_LAYERS]
        prev = {} if goals is not None else None
        heap = []
        for li, i in starts:
            if dist[li][i] > 0.0:
                dist[li][i] = 0.0
                heap.append((0.0, li, int(i)))
        heapq.heapify(heap)
        d2 = h * math.sqrt(2)
        steps = ((-1, 0, h), (1, 0, h), (0, -1, h), (0, 1, h), (-1, -1, d2), (-1, 1, d2), (1, -1, d2), (1, 1, d2))
        copper, hop = self.copper, self.hop
        while heap:
            d, li, i = heapq.heappop(heap)
            if d > dist[li][i]:
                continue
            if goals is not None and (li, i) in goals:
                path = [(li, i)]
                while path[-1] in prev:
                    path.append(prev[path[-1]])
                return d, path[::-1]
            r, c = divmod(i, nx)
            for dr, dc, w in steps:
                rr, cc = r + dr, c + dc
                if 0 <= rr < ny and 0 <= cc < nx:
                    j = rr * nx + cc
                    if copper[li][j] and d + w < dist[li][j]:
                        dist[li][j] = d + w
                        if prev is not None:
                            prev[(li, j)] = (li, i)
                        heapq.heappush(heap, (d + w, li, j))
            if hop[i] >= 0:
                for lj in range(len(copper)):
                    if lj != li and copper[lj][i] and d + GND_RET_VIA_MM < dist[lj][i]:
                        dist[lj][i] = d + GND_RET_VIA_MM
                        if prev is not None:
                            prev[(lj, i)] = (li, i)
                        heapq.heappush(heap, (d + GND_RET_VIA_MM, lj, i))
        return (math.inf, []) if goals is not None else dist


def u1_window(board: pcbnew.BOARD) -> tuple[float, float, float, float]:
    cx, cy = mm_xy(board.FindFootprintByReference("U1").GetPosition())
    return cx - GND_RET_WIN, cy - GND_RET_WIN, cx + GND_RET_WIN, cy + GND_RET_WIN


def gnd_return(board: pcbnew.BOARD) -> tuple[dict[str, float], float]:
    """Shortest GND copper paths, mm, from U1's exposed pad: to each U1 cap's GND pad (pad 2), and to the
    main B.Cu GND plane, on a GndRaster inside GND_RET_WIN of the U1 centre. inf when a target cannot
    be reached inside the window."""
    import numpy as np
    r = GndRaster(board, u1_window(board))
    dist = r.search([c for c in r.pad_cells("U1.57") if c[0] == 0])
    out = {}
    for c in U1_CAPS:
        cells = [i for li, i in r.pad_cells(f"{c}.2") if li == 0]
        out[c] = float(dist[0][np.array(cells)].min()) if cells else math.inf
    main = main_plane(board)
    cells = r.cells(main, 2) if main is not None else []
    return out, float(dist[2][cells].min()) if len(cells) else math.inf


def u1_gnd_links(board: pcbnew.BOARD) -> list[float]:
    """Separate GND paths from U1's exposed pad out to the edge of a window GND_LINK_WIN either side of
    U1, past any island round U1, where the board-wide planes run: over GND copper about GND_NECK_W wide
    or wider (a GndRaster eroded by GND_NECK_ERODE), the shortest one, then the shortest that keeps
    GND_LINK_APART clear of the earlier ones (outside the pad itself), and so on, up to GND_LINKS_COUNT.
    Two links never share a via or a neck narrower than about GND_NECK_W + 2 x GND_LINK_APART, so the
    count measures how much copper joins the pad to the planes. Returns their lengths in mm
    (deviations ORDER-4)."""
    import numpy as np
    import shapely
    cx, cy = mm_xy(board.FindFootprintByReference("U1").GetPosition())
    r = GndRaster(board, (cx - GND_LINK_WIN, cy - GND_LINK_WIN, cx + GND_LINK_WIN, cy + GND_LINK_WIN),
                  erode=GND_NECK_ERODE)
    ny, nx = r.X.shape
    ep = next(poly for layer, poly in r.pads["U1.57"] if layer == pcbnew.F_Cu)
    starts = [c for c in r.pad_cells("U1.57") if c[0] == 0]
    keep = shapely.contains_xy(ep.buffer(GND_RET_GRID), r.X, r.Y)
    edge = np.zeros((ny, nx), bool)
    edge[[0, -1], :] = True
    edge[:, [0, -1]] = True
    edge = np.flatnonzero(edge)
    goals = {(li, int(i)) for li in range(len(r.copper)) for i in edge[r.copper[li][edge]]}
    k = max(1, round(GND_LINK_APART / GND_RET_GRID))
    out = []
    while len(out) < GND_LINKS_COUNT:
        d, path = r.search(starts, goals)
        if not path:
            break
        out.append(d)
        for (la, i), (lb, _) in zip(path, path[1:] + path[-1:]):
            row, col = divmod(i, nx)
            rows, cols = slice(max(0, row - k), row + k + 1), slice(max(0, col - k), col + k + 1)
            for li in {la, lb}:                       # a via: both layers
                r.copper[li].reshape(ny, nx)[rows, cols] &= keep[rows, cols]
        goals = {(li, i) for li, i in goals if r.copper[li][i]}
    return out


def gnd_pin_paths(board: pcbnew.BOARD) -> dict[str, float]:
    """Shortest GND copper path, mm, from each GND_PIN_PATHS source pad to the nearest of its target
    pads, on a GndRaster over both pads' box grown by GND_PIN_WIN (deviations ORDER-4)."""
    out = {}
    for label, src, targets in GND_PIN_PATHS:
        def where(name):
            ref, num = name.split(".")
            return [mm_xy(p.GetPosition()) for p in board.FindFootprintByReference(ref).Pads() if p.GetNumber() == num]
        pts = where(src) + [q for t in targets for q in where(t)]
        xs, ys = [p[0] for p in pts], [p[1] for p in pts]
        r = GndRaster(board, (min(xs) - GND_PIN_WIN, min(ys) - GND_PIN_WIN, max(xs) + GND_PIN_WIN, max(ys) + GND_PIN_WIN))
        goals = {c for t in targets for c in r.pad_cells(t)}
        d, _ = r.search(r.pad_cells(src), goals)
        out[label] = d
    return out


def sps_polys(sps) -> list[Polygon]:
    """SHAPE_POLY_SET -> shapely polygons with their holes."""
    out = []
    for i in range(sps.OutlineCount()):
        o = sps.Outline(i)
        shell = [mm_xy(o.CPoint(j)) for j in range(o.PointCount())]
        holes = [[mm_xy(hh.CPoint(j)) for j in range(hh.PointCount())]
                 for hh in (sps.Hole(i, k) for k in range(sps.HoleCount(i)))]
        if len(shell) >= 3:
            out.append(Polygon(shell, holes))
    return out


def under_crystal(board: pcbnew.BOARD) -> list[str]:
    """B.Cu tracks and any vias whose copper reaches under Y1's courtyard."""
    from shapely.geometry import LineString
    cy = courtyard(board.FindFootprintByReference("Y1"))
    out = []
    for t in board.GetTracks():
        if t.Type() == pcbnew.PCB_VIA_T:
            g = Point(mm_xy(t.GetPosition())).buffer(pcbnew.ToMM(t.GetWidth(pcbnew.F_Cu)) / 2)
        elif t.GetLayer() == pcbnew.B_Cu:
            g = LineString([mm_xy(t.GetStart()), mm_xy(t.GetEnd())]).buffer(pcbnew.ToMM(t.GetWidth()) / 2)
        else:
            continue
        if g.intersects(cy):
            out.append(f"{t.GetNetname()} {'via' if t.Type() == pcbnew.PCB_VIA_T else 'B.Cu track'} at "
                       f"({g.centroid.x:.2f}, {g.centroid.y:.2f})")
    return out


def courtyard(fp: pcbnew.FOOTPRINT) -> Polygon:
    sps = fp.GetCourtyard(pcbnew.F_CrtYd)
    o = sps.Outline(0)
    return Polygon([mm_xy(o.CPoint(i)) for i in range(o.PointCount())])


def y1_distance(board: pcbnew.BOARD) -> float:
    u1, y1 = board.FindFootprintByReference("U1"), board.FindFootprintByReference("Y1")
    cy = courtyard(y1)
    pins = [p for p in u1.Pads() if p.GetNumber() in XTAL_PINS]
    if len(pins) != 2:
        raise SystemExit("U1 XIN/XOUT pads not found")
    return max(pad_poly(p).distance(cy) for p in pins)


def edge_vertices(board: pcbnew.BOARD) -> list[tuple[float, float]]:
    pts = []
    for d in board.GetDrawings():
        if d.GetLayer() != pcbnew.Edge_Cuts:
            continue
        pts += [mm_xy(d.GetStart()), mm_xy(d.GetEnd())]
        if d.GetShape() == pcbnew.SHAPE_T_ARC:
            pts.append(mm_xy(d.GetArcMid()))
    return pts


def check_edges(board: pcbnew.BOARD, side: str) -> list[str]:
    want = []
    for s in layout_side(side)["outline"]["segments"]:
        want += [tuple(s["start"]), tuple(s["end"])] + ([tuple(s["mid"])] if s["type"] == "arc" else [])
    have = edge_vertices(board)
    errs = []
    for label, a, b in (("layout vertex missing from Edge.Cuts", want, have),
                        ("Edge.Cuts vertex not in layout", have, want)):
        for p in a:
            d = min(math.dist(p, q) for q in b)
            if d > EDGE_TOL_MM:
                errs.append(f"{label}: ({p[0]:.4f}, {p[1]:.4f}) off by {d:.4f} mm")
    return errs


def check_rgb(board: pcbnew.BOARD, side: str) -> tuple[str, list[str]]:
    leds = layout_side(side)["leds"]
    errs, worst = [], 0.0
    graph = copper_graph(board, board.FindNet("VLED").GetNetCode())
    for i, d in enumerate(leds):
        fp = board.FindFootprintByReference(d["ref"])
        if fp is None:
            errs.append(f"{d['ref']} missing")
            continue
        x, y = mm_xy(fp.GetPosition())
        if math.dist((x, y), (d["x"], d["y"])) > LED_POS_TOL_MM or not fp.IsFlipped():
            errs.append(f"{d['ref']} at ({x:.3f}, {y:.3f}) {'B' if fp.IsFlipped() else 'F'}.Cu, "
                        f"layout wants B.Cu ({d['x']:.3f}, {d['y']:.3f}) under {d['key']}")
        if not any(g.GetLayer() == pcbnew.Edge_Cuts for g in fp.GraphicalItems()):
            errs.append(f"{d['ref']}: no cutout on Edge.Cuts")
        pads = {p.GetNumber(): mm_xy(p.GetPosition()) for p in fp.Pads()}
        step = d["next"] or leds[i - 1]["next"]
        (ax, ay), (bx, by) = pads[LED_PADS["DIN"]], pads[LED_PADS["DOUT"]]
        n = math.hypot(bx - ax, by - ay)
        # turned the better of its two ways (key rot or + 180): where the chain turns 90 deg at a row end
        # the best projection is only ~0.27 (DIN -> DOUT also steps 1.5 mm across), so the gate is > 0
        if ((bx - ax) * step[0] + (by - ay) * step[1]) / n <= 0.0:
            errs.append(f"{d['ref']}: DIN -> DOUT points away from the chain")
        cap = f"{d['cap']}.1"
        dist = dijkstra(graph, [f"{d['ref']}.{LED_PADS['VDD']}"], {cap})
        worst = max(worst, dist)
        if dist > LED_CAP_MAX_MM:
            errs.append(f"{d['ref']} VDD -> {d['cap']}: {dist:.1f} mm of VLED copper > {LED_CAP_MAX_MM}")
    return (f"per-key RGB: {len(leds)} LEDs in their switch windows with cutouts, chained in order, "
            f"each 100 nF <= {worst:.1f} mm of VLED copper from its VDD pad", errs)


def check_drc(path: Path) -> list[str]:
    if not path.exists():
        return [f"{path} missing: run the DRC gate first"]
    d = json.loads(path.read_text())
    errs = [f"{len(d.get('unconnected_items', []))} unconnected items"] if d.get("unconnected_items") else []
    bad = [v for v in d.get("violations", []) if v["severity"] == "error"]
    bad += [v for v in d.get("schematic_parity", []) if v["severity"] == "error"]
    errs += [f"{len(bad)} DRC / parity errors ({', '.join(sorted({v['type'] for v in bad}))})"] if bad else []
    return errs


def main(argv: list[str]) -> int:
    if len(argv) != 2 or argv[1] not in ("left", "right"):
        print(__doc__)
        return 2
    side = argv[1]
    board = pcbnew.LoadBoard(str(ROOT / "pcb" / side / f"worxboard-{side}.kicad_pcb"))
    results: list[tuple[str, list[str]]] = []
    usb = usb_paths(board)
    errs = [f"{n} path {v:.2f} mm > {USB_MAX_MM}" for n, v in usb.items() if v > USB_MAX_MM]
    skew = abs(usb["D+"] - usb["D-"])
    errs += [f"D+/D- differ by {skew:.2f} mm > {USB_SKEW_MM}"] if skew > USB_SKEW_MM else []
    results.append((f"USB pair: D+ {usb['D+']:.2f} mm, D- {usb['D-']:.2f} mm, skew {skew:.2f} mm", errs))
    y1 = y1_distance(board)
    results.append((f"Y1 courtyard {y1:.2f} mm from XIN/XOUT",
                    [f"{y1:.2f} mm > {Y1_MAX_MM}"] if y1 > Y1_MAX_MM else []))
    results.append(("nothing on B.Cu or in vias under Y1", under_crystal(board)))
    pin_cap, cap_pin, gnd_via = decoupling(board)
    worst_pin, worst_cap, worst_via = (max(d, key=d.get) for d in (pin_cap, cap_pin, gnd_via))
    errs = [f"{p} is {v:.2f} mm of copper from a cap > {PIN_CAP_MAX_MM}" for p, v in pin_cap.items() if v > PIN_CAP_MAX_MM]
    errs += [f"{c} is {v:.2f} mm of copper from a U1 supply pin > {CAP_PIN_MAX_MM}" for c, v in cap_pin.items()
             if v > CAP_PIN_MAX_MM]
    errs += [f"{c} GND pad {v:.2f} mm from a GND via > {CAP_GND_VIA_MM}" for c, v in gnd_via.items() if v > CAP_GND_VIA_MM]
    results.append((f"decoupling: pins <= {pin_cap[worst_pin]:.2f} mm from a cap ({worst_pin}), caps <= "
                    f"{cap_pin[worst_cap]:.2f} mm from a pin ({worst_cap}), GND vias <= {gnd_via[worst_via]:.2f} mm",
                    errs))
    for net in SUPPLY_NETS:
        print(f"     {net} U1 pin -> nearest cap, mm: " + ", ".join(
            f"{k.split('.')[1]} {v:.1f}" for k, v in pin_cap.items() if k.startswith(net)))
    ep_in, ep_n, caps_in, area = u1_gnd(board)
    print(f"     U1 GND over B.Cu alone: {ep_in}/{ep_n} EP vias and {len(caps_in)}/{len(U1_CAPS)} cap GND vias "
          f"in the main B.Cu GND plane ({area:.0f} mm2): {', '.join(caps_in) or 'no caps'}")
    ret, ep_plane = gnd_return(board)
    results.append((f"U1 exposed pad -> In1 GND plane: {ep_plane:.1f} mm of GND copper",
                    [f"{ep_plane:.1f} mm > {EP_PLANE_MAX_MM}"] if ep_plane > EP_PLANE_MAX_MM else []))
    worst = max(ret, key=ret.get)
    results.append((f"U1 cap GND return to the exposed pad <= {ret[worst]:.1f} mm ({worst}): " + ", ".join(
                        f"{c} {v:.1f}" for c, v in ret.items()),
                    [f"{c} GND pad is {v:.1f} mm of GND copper from U1's exposed pad > {GND_RET_MAX_MM}"
                     for c, v in ret.items() if v > GND_RET_MAX_MM]))
    links = u1_gnd_links(board)
    good = [d for d in links if d <= GND_LINK_MAX_MM]
    results.append((f"U1 exposed pad -> GND planes {GND_LINK_WIN:.0f} mm out, over copper >= {GND_NECK_W} mm wide: "
                    f"{len(good)} separate links <= {GND_LINK_MAX_MM:.0f} mm ({', '.join(f'{d:.1f}' for d in links) or 'none'})",
                    [f"{len(good)} < {GND_LINKS_MIN} links"] if len(good) < GND_LINKS_MIN else []))
    for label, d in gnd_pin_paths(board).items():
        results.append((f"{label}: {d:.1f} mm of GND copper",
                        [f"{d:.1f} mm > {GND_PIN_MAX_MM}"] if d > GND_PIN_MAX_MM else []))
    pin, net, caps = U4_REF
    ref = dijkstra(copper_graph(board, board.FindNet(net).GetNetCode()), [pin], set(caps))
    results.append((f"U4 {net} reference: {ref:.2f} mm of copper to a {net} cap",
                    [f"{ref:.2f} mm > {U4_CAP_MAX_MM}"] if ref > U4_CAP_MAX_MM else []))
    legs = list(pin_in_paste.pads(board))
    results.append((f"pin-in-paste: {len(legs)} pads ({', '.join(f'{r} {n}' for r, n in pin_in_paste.PIN_IN_PASTE.items())}) "
                    "on the paste layer",
                    [f"{fp.GetReference()} pad {pad.GetNumber()} at ({pcbnew.ToMM(pad.GetPosition().x):.2f}, "
                     f"{pcbnew.ToMM(pad.GetPosition().y):.2f}) has no paste"
                     for fp, pad in legs if not pad.IsOnLayer(pin_in_paste.paste_layer(fp))]
                    + ([] if legs else ["no pin-in-paste pads found"])))
    results.append(("no via in an SMD pad", [f"{v.GetNetname()} via at ({pcbnew.ToMM(v.GetPosition().x):.3f}, "
                                              f"{pcbnew.ToMM(v.GetPosition().y):.3f}) in {pad}"
                                              for v, pad in vias_in_pads(board)]))
    results.append(check_rgb(board, side))
    results.append(("Edge.Cuts equals layout", check_edges(board, side)))
    results.append(("DRC: 0 unconnected, 0 errors", check_drc(ROOT / "build" / side / "drc.json")))
    failed = 0
    for title, errs in results:
        print(f"{'FAIL' if errs else 'ok  '} {title}")
        for e in errs:
            print(f"       {e}")
        failed += bool(errs)
    print(f"checks {side}: {len(results) - failed} passed, {failed} failed")
    return 1 if failed else 0


if __name__ == "__main__":
    sys.exit(main(sys.argv))
