w0rxbend/worxboard/pcb/scripts/route_critical.py

# SPDX-License-Identifier: GPL-3.0-or-later
"""Lay the locked critical routes of one half (spec §9 stage 8).

    python3 pcb/scripts/route_critical.py <side>     (edits pcb/<side>/worxboard-<side>.kicad_pcb)

- QFN-56: a 45 deg corner fan-out of the U1 signal pins at FAN_W, which the maze router
  (complete_routes.py) continues at that width. Also here: the joins inside the pad ring (MOAT, between the pad inner
  ends and the exposed pad): 3V3 pins 42/43/44/33/22 and 1/10, 1V1 pins 45/50, TESTEN onto the
  GND pad; 48/49 and 43/44 bridged at the pads; a 3 x 3 via array in the exposed pad; three
  3V3 exits necked to 0.15 mm between the pads, then 0.5 mm.
- USB pair U1 -> R3/R4 -> U4 (pass-through) -> J1, with the receptacle's A/B ties, and the
  J1 escape vias the pair encloses on the right half. A B.Cu track keepout runs under the pair.
  U4's VSYS reference (pin 5) runs to C2 beside it (u4_cap). On the left, B.Cu GND locks
  U4 pin 2's via to the nearest J1 shell pad (u4_gnd_left); the pour does not.
- Key matrix: switch -> diode links, rows (F.Cu) and columns (B.Cu), vias at the thumb pads.
- Decoupling: every supply cap (placed at an exit by place.CLUSTER) joined to that exit, and its
  GND pad to a via; XOUT -> R7 -> Y1 beside the crystal; a B.Cu track/via keepout under Y1.
- U1 GND: the TESTEN pad (GND) out to a B.Cu via at the GND fill under Y1, which reaches the back
  edge, and on the right a B.Cu spine from the exposed pad's via array to the back edge (EDGE_SPOKE),
  so routes cannot wall the pad off from the plane; B.Cu spurs from the pad's vias to every U1 cap's
  GND via (ep_caps), so each cap's GND return is short.

Geometry is written in the U1 frame (place.U1_ROT) where it is the same on both halves; the
J1 end is laid per side.
"""
from __future__ import annotations

import math
import sys
from pathlib import Path

ROOT = Path(__file__).resolve().parents[2]
sys.path.insert(0, str(Path(__file__).resolve().parent))

import pcbnew  # noqa: E402
from shapely.geometry import LineString, Point  # noqa: E402

from design import POWER_NETS  # noqa: E402
from place import (EDGE_CLEARANCE, U1_ROT, U4_CAP_VIA_Y, U4_L_S, U4_PIN5, U4_VIA_OUT, USB_NETS,  # noqa: E402
                   layout_side, mm, outline_points, pt, rotate, seed_kiids, usb_diagonal)

FAN_W = 0.15                 # QFN stubs and inner joins
PAIR_W = 0.25
POWER_W = 0.5
PAD_END = 3.875              # QFN pad outer end from the centre
MOAT = 2.3                   # inner joins: between the pad inner ends (3.0) and the exposed pad (1.6)
EP_VIAS = (-1.0, 0.0, 1.0)
PAIR_PITCH = 0.45
USB_CHAMFER = 0.35           # 45 deg corner where the pair leaves the pads
USB_BUMP = 1.2               # D- detour depth (~0.7 mm extra length)
# U1 corner fan-out: (side normal, 45 deg heading, pins from the corner inward), U1 frame
FAN_GROUPS = [
    ((-1, 0), (-1, -1), ["1", "2", "3", "4", "5", "6", "7"]),
    ((0, -1), (-1, -1), ["56", "55", "54", "53", "52", "51", "50"]),
    ((-1, 0), (-1, 1), ["14", "13", "12", "11", "9", "8"]),
    ((0, 1), (-1, 1), ["15", "16", "17", "18"]),
    ((0, 1), (1, 1), ["28", "27", "26", "25", "24", "23", "21"]),
    ((1, 0), (1, 1), ["29", "30", "31", "32", "34", "35", "36", "37", "38"]),
]
FAN_R0 = 0.25                # first bend this far past the pad end
FAN_STAGGER = 0.3            # each next pin bends this much further out
FAN_STAGGER_POWER = 0.6      # after the 3V3 exit (pin 1, 0.5 mm wide)
FAN_RUN = 1.2                # diagonal length
FAN_VIA_PINS = ("17", "29", "30", "31")   # COL0, COL4..COL6: fan end -> via, under U1 on B.Cu
FAN_STAGGER_VIA = 0.45       # beside a via end: (0.4 + 0.45) / sqrt 2 clears via + track
FAN_VIA_STEP = 0.9           # each next via end this much further along its run
KEEPOUT_GROW = 0.6           # B.Cu keepout half-width beyond the pair
U4_KEEPOUT_GAP = 0.3         # left half: the keepout stops this far past U4's row jogs
U4_GND_SIDE = 1.85           # left: B.Cu clamp GND, U4 +y (opposite C2). Past the 0.95 row,
                             # the 0.25 pair, this 0.5 track, and 0.2 clearance, with margin

# Key matrix, key frame (mm from the switch centre, as seen from the top; B.Cu socket pads at
# (-7.085, -2.54) COL and (5.842, -5.08) MX, diode at (0, 8.5) with the cathode west, below the
# rev B LED in the switch window at (0, 5.08): docs/deviations.md REVB-1)
MX_X = 7.0                   # socket pad 2 -> diode anode link (B.Cu), east of the peg hole
MX_X_TRIES = (7.0, 7.4, 6.6, 7.8)   # the link's vertical run, first one clear of holes and keepouts
ROW_VIA_DX = 1.55            # row via this far west of the cathode pad centre; the row line (F.Cu)
                             # runs at the diode's height, below the LED cutout
EDGE_CLEAR = 0.5             # copper to the board outline, the board rule
LED_EDGE_CLEAR = 0.35        # copper to an LED cutout: place.LED_EDGE_CLEARANCE and a margin for the arcs
COL_X = -8.885               # column line (B.Cu) and column vias, west of the socket
MATRIX_W = 0.25
CLEAR = 0.2
HOLE_CLEAR = 0.25            # copper to a drilled hole
DETOUR_DEPTHS = [0.5 * i for i in range(2, 13)]   # sideways step around a hole keepout
DETOUR_HALF = 3.6            # half-length of the straight part beside the hole
JOG_TRIES = [0.0] + [s * 0.5 * i for i in range(1, 15) for s in (1, -1)]
# Per-key RGB cell on four layers (docs/deviations.md REVB-8), LED frame: origin at the LED centre, u from
# VSS (pad 1) to DOUT (pad 4), v from VSS to DIN (pad 2). Each tuple lists via spots, first clear one wins
LED_W = 0.4                  # VSS / VDD / cap spurs (the 0402 cap pad is 0.56 wide)
LED_GND_VIA = ((-4.125, -0.75), (-4.125, -1.6))
LED_DIN_VIA = ((-4.125, 0.75), (-4.125, 1.6), (-2.825, 1.9))
LED_DOUT_VIA = ((2.825, -1.88), (1.9, -2.1), (3.6, -1.88))
CAP_GND_VIA = ((5.75, -0.68), (4.6, -1.5), (5.75, -1.4))
CAP_VLED_VIA = ((5.75, 0.82), (4.6, 1.6), (5.75, 1.6))
PLANE_VIA_R = (1.0, 1.3, 1.7)  # via this far from a top-side plane-net pad centre, first clear spot
LANE_MIN_RUN = 1.0           # a jogged F.Cu data lane needs this much straight run beside its 45 deg jog

TESTEN = "19"

# Decoupling (docs/deviations.md REVIEW-FIX-2): caps per exit, in bus order from the exit, and
# the GND via of each one as an offset from its pad 2 (U1 frame; one shared via for C8 / C9)
N_CAPS = ("C14", "C15", "C13", "C10")        # north bus: USB_VDD 48, IOVDD 49
E_CAPS = ("C18", "C11", "C12")               # east bus: IOVDD 42 (33, 22 on the moat), ADC 43, VREG_IN 44
W_CAPS = ("C8", "C9")                        # west: IOVDD 1 (10 on the moat)
V11_N_CAPS = ("C16", "C19")                  # 1V1 at the pin-50 fan end: DVDD 50, VREG_VOUT 45 (moat)
V11_S_CAP = "C17"                            # 1V1 at the pin-23 fan end: DVDD 23
GND_VIA = {**{c: (0.0, -0.84) for c in N_CAPS}, **{c: (0.75, 0.0) for c in E_CAPS},
           "C8": (0.0, -0.65), "C9": (0.0, 0.65), "C16": (0.0, -0.82), "C19": (0.0, -0.82),
           V11_S_CAP: (0.75, 0.0)}
CAP_LINK_W = 0.25            # 1V1 and crystal links (Default width)
CAP_GND_OUT = 0.84           # C2 (U4's VSYS cap): GND via this far past its pad 2
XOUT_PIN = "21"
Y1_KEEPOUT_GROW = 0.25       # B.Cu track / via keepout: Y1 courtyard + this (spec §6.4)
# U1 GND (docs/deviations.md BOARD-9, BOARD-14). The exposed pad (EP) is the RP2040's only GND pin, and
# B.Cu routes under and around U1 can ring its B.Cu copper, or a cap's GND via, off from the plane (the
# left board of 4e5fc30 hung the EP on one via; on the left of 68f812e eleven caps returned to the EP
# over 125-180 mm of GND copper). Locked GND copper therefore ties, on both halves:
# - the EP to the GND plane at the back edge: the TESTEN pad (pin 19, GND), which qfn_inner joins to
#   the EP on F.Cu, runs on out between pins 18 and 20 to a B.Cu via at the GND fill under Y1
#   (Y1_KEEPOUT), which reaches the back edge (testen_via). On the right a 0.5 mm B.Cu spine also runs
#   from the EP up under the 3V3 north exit (x 0.6), through the north caps' GND via row and on from
#   C19's via to the back edge (EDGE_SPOKE), on the side of U1 where no fan-out runs. On the left (U1
#   turned 180 deg) that side faces the matrix, and the B.Cu spoke under XIN of BOARD-9 walled off every
#   route under U1's south side: the F.Cu escape replaces it;
# - every U1 cap's GND via to the EP over B.Cu (ep_caps), as spurs that end at a cap or in a fill: the
#   spine to the north row (C14 / C15 / C13 / C10, with C16 / C19 on its west end), the east caps' GND
#   vias (C18 / C11 / C12) in a row fed into the GND fill under the USB pair (USB_KEEPOUT), which meets
#   the spine, a diagonal from the EP's north-west via to the west caps' (C8 / C9) via, and C17's via
#   stubbed into the GND fill under Y1, which the TESTEN via joins.
EDGE_SPOKE = {"right": True, "left": False}
SPOKE_W = 0.5
N_SPOKE_X = 0.6              # north spine: under the 3V3 north exit (x 0.4), beside the USB keepout (x >= 1.0)
SPOKE_KO_GAP = 0.05          # GND copper stops this far short of a keepout whose fill it joins, or of the
                             # copper-to-edge clearance
VIA_R = 0.3                  # locked via pad radius (Router.via)
T_W = 0.2                    # TESTEN escape: 0.225 mm from the pin 18 / XIN tracks on the 0.4 mm pitch
T_MARGIN = 0.02              # its via: this much over the clearance to pin 18 / XIN / the Y1 keepout


class Router:
    def __init__(self, board: pcbnew.BOARD, side: str):
        self.board, self.side = board, side
        self.u1 = board.FindFootprintByReference("U1")
        self.rot = U1_ROT[side]
        c = self.u1.GetPosition()
        self.cx, self.cy = pcbnew.ToMM(c.x), pcbnew.ToMM(c.y)
        self.tracks = 0
        self.fan_ends: dict[str, tuple[float, float]] = {}

    # U1 frame <-> board
    def g(self, lx: float, ly: float) -> tuple[float, float]:
        dx, dy = rotate(lx, ly, self.rot)
        return self.cx + dx, self.cy + dy

    def local(self, x: float, y: float) -> tuple[float, float]:
        return rotate(x - self.cx, y - self.cy, -self.rot)

    def pad(self, ref: str, num: str) -> pcbnew.PAD:
        fp = self.board.FindFootprintByReference(ref)
        pads = [p for p in fp.Pads() if p.GetNumber() == num]
        if not pads:
            raise SystemExit(f"{ref} has no pad {num}")
        return pads[0]

    def pad_xy(self, ref: str, num: str) -> tuple[float, float]:
        p = self.pad(ref, num).GetPosition()
        return pcbnew.ToMM(p.x), pcbnew.ToMM(p.y)

    def net(self, ref: str, num: str) -> pcbnew.NETINFO_ITEM:
        return self.pad(ref, num).GetNet()

    def track(self, net, pts, width: float, layer=pcbnew.F_Cu) -> None:
        for a, b in zip(pts, pts[1:]):
            if math.dist(a, b) < 1e-6:
                continue
            t = pcbnew.PCB_TRACK(self.board)
            t.SetStart(pt(*a))
            t.SetEnd(pt(*b))
            t.SetWidth(mm(width))
            t.SetLayer(layer)
            t.SetNet(net)
            t.SetLocked(True)
            self.board.Add(t)
            self.tracks += 1
            self.note(LineString([a, b]).buffer(width / 2 + CLEAR), (layer,), net)

    def note(self, geom, layers, net) -> None:
        """Copper laid once the matrix has its obstacle lists is an obstacle for what follows."""
        for layer in layers:
            if layer in getattr(self, "obst", {}):
                self.obst[layer].append((geom, net.GetNetCode()))

    def ltrack(self, net, lpts, width: float, layer=pcbnew.F_Cu) -> None:
        self.track(net, [self.g(*p) for p in lpts], width, layer)

    def via(self, net, xy) -> None:
        v = pcbnew.PCB_VIA(self.board)
        v.SetPosition(pt(*xy))
        v.SetWidth(mm(0.6))
        v.SetDrill(mm(0.3))
        v.SetNet(net)
        v.SetLocked(True)
        self.board.Add(v)
        self.note(Point(xy).buffer(VIA_R + CLEAR), (pcbnew.F_Cu, pcbnew.B_Cu), net)

    # --- QFN ------------------------------------------------------------------------------
    def u1_pads(self) -> dict[str, tuple[float, float]]:
        out = {}
        for p in self.u1.Pads():
            if p.GetNetname() and not p.GetNetname().startswith("unconnected-"):
                out[p.GetNumber()] = self.local(*(pcbnew.ToMM(v) for v in (p.GetPosition().x, p.GetPosition().y)))
        return out

    def qfn_inner(self) -> None:
        """Joins inside the pad ring (between the pad inner ends and the exposed pad)."""
        pads = self.u1_pads()
        gnd, v33, v11 = self.net("U1", "57"), self.net("U1", "42"), self.net("U1", "45")
        lx, ly = pads[TESTEN]                                 # TESTEN straight onto the GND pad
        self.ltrack(self.net("U1", TESTEN), [(lx, ly), (lx, 1.2)], FAN_W)
        # 3V3: 44-43 across the gap, 43-42 across the corner, 48-49 across the gap
        (x43, y43), (x42, y42) = pads["43"], pads["42"]
        self.ltrack(v33, [pads["44"], pads["43"]], FAN_W)
        self.ltrack(v33, [(x43, y43), (x43, -3.1), (3.1, y42), (x42, y42)], FAN_W)
        self.ltrack(v33, [pads["49"], pads["48"]], FAN_W)
        # 3V3 moat east + south (42, 33, 22) and west (1, 10); 1V1 moat north (45, 50)
        (x22, _), (_, y33), (_, y1), (_, y10) = pads["22"], pads["33"], pads["1"], pads["10"]
        self.ltrack(v33, [pads["42"], (MOAT, y42), (MOAT, MOAT), (x22, MOAT), pads["22"]], FAN_W)
        self.ltrack(v33, [pads["33"], (MOAT, y33)], FAN_W)
        self.ltrack(v33, [pads["1"], (-MOAT, y1), (-MOAT, y10), pads["10"]], FAN_W)
        (x50, _), (x45, _) = pads["50"], pads["45"]
        self.ltrack(v11, [pads["50"], (x50, -MOAT), (x45, -MOAT), pads["45"]], FAN_W)
        for vx in EP_VIAS:
            for vy in EP_VIAS:
                self.via(gnd, self.g(vx, vy))

    def power_escapes(self) -> None:
        """3V3 leaves the pad ring east (pin 42) and north (48/49), necked to 0.15 between the
        pads, then 0.5; the west exit (pin 1) leads the north-west fan."""
        pads = self.u1_pads()
        v33 = self.net("U1", "42")
        x42, y42 = pads["42"]
        self.ltrack(v33, [(x42, y42), (PAD_END + 0.45, y42)], FAN_W)
        self.ltrack(v33, [(PAD_END + 0.45, y42), (PAD_END + 1.45, y42)], POWER_W)
        xm = (pads["48"][0] + pads["49"][0]) / 2
        self.ltrack(v33, [(xm, pads["48"][1]), (xm, -PAD_END - 0.25)], FAN_W)
        self.ltrack(v33, [(xm, -PAD_END - 0.25), (xm, -PAD_END - 1.15)], POWER_W)

    def fanout(self) -> None:
        """45 deg corner fan-out of the U1 signal pins (FAN_GROUPS): each half-side bends toward
        a corner, the pin nearest the corner first and each next one FAN_STAGGER further out,
        so neighbouring diagonals stay (0.4 + FAN_STAGGER) / sqrt 2 apart. The ends are staggered
        along the run so the router can reach each from the front and the leading side."""
        pads = self.u1_pads()
        for normal, heading, pins in FAN_GROUPS:
            r = PAD_END + FAN_R0
            vias_done = 0
            for i, num in enumerate(pins):
                lx, ly = pads[num]
                lat = lx if normal[0] == 0 else ly
                def at(rad: float, t: float):
                    return (rad * normal[0], t) if normal[0] else (t, rad * normal[1])
                turn = at(r, lat)
                run = FAN_RUN + FAN_VIA_STEP * vias_done if num in FAN_VIA_PINS else FAN_RUN
                end = (turn[0] + heading[0] * run / math.sqrt(2), turn[1] + heading[1] * run / math.sqrt(2))
                net = self.net("U1", num)
                if num == "1":                     # 3V3: wide once clear of the pads, more room after
                    mid = (turn[0] + heading[0] * 0.4, turn[1] + heading[1] * 0.4)
                    self.ltrack(net, [(lx, ly), turn, mid], FAN_W)
                    self.ltrack(net, [mid, end], POWER_W)
                else:
                    self.ltrack(net, [(lx, ly), turn, end], FAN_W)
                self.fan_ends[num] = end
                if num in FAN_VIA_PINS:            # columns drop to B.Cu to cross under U1
                    self.via(net, self.g(*end))
                    vias_done += 1
                nxt = pins[i + 1] if i + 1 < len(pins) else None
                wide = num == "1" or num in FAN_VIA_PINS or nxt in FAN_VIA_PINS
                r += FAN_STAGGER_POWER if num == "1" else FAN_STAGGER_VIA if wide else FAN_STAGGER
        # XIN straight down into the crystal
        y1 = self.local(*self.pad_xy("Y1", "1"))
        lx, ly = pads["20"]
        self.ltrack(self.net("U1", "20"), [(lx, ly), (lx, y1[1] - 1.5), (y1[0], y1[1] - 1.5 + abs(y1[0] - lx)), y1], FAN_W)

    # --- decoupling and crystal ---------------------------------------------------------------
    def lpad(self, ref: str, num: str) -> tuple[float, float]:
        return self.local(*self.pad_xy(ref, num))

    def decoupling(self) -> None:
        """Locked copper from each decoupling cap to the U1 exit it serves, and from its GND pad
        to a via, so routing can never leave a cap far from its pins (spec §6.4)."""
        pads = self.u1_pads()
        v33, v11 = self.net("U1", "42"), self.net("U1", "45")
        xm = (pads["48"][0] + pads["49"][0]) / 2              # north: 48/49 exit -> pad-1 row
        y_bus = self.lpad(N_CAPS[0], "1")[1]
        self.ltrack(v33, [(xm, -PAD_END - 1.15), (xm, y_bus), self.lpad(N_CAPS[-1], "1")], POWER_W)
        self.ltrack(v33, [(PAD_END + 1.45, pads["42"][1]), self.lpad(E_CAPS[-1], "1")], POWER_W)
        end1 = self.fan_ends["1"]                             # west: down the pin-1 exit's x
        self.ltrack(v33, [end1, (end1[0], self.lpad(W_CAPS[-1], "1")[1])], POWER_W)
        self.ltrack(v11, [self.fan_ends["50"], *(self.lpad(c, "1") for c in V11_N_CAPS)], CAP_LINK_W)
        (ex, ey), (cx, cy) = self.fan_ends["23"], self.lpad(V11_S_CAP, "1")
        self.ltrack(v11, [(ex, ey), (cx, ey + cx - ex), (cx, cy)], CAP_LINK_W)   # on down the 45° lane
        done = set()
        for cap, (dx, dy) in GND_VIA.items():
            px, py = self.lpad(cap, "2")
            v = (round(px + dx, 4), round(py + dy, 4))
            gnd = self.net(cap, "2")
            self.ltrack(gnd, [(px, py), v], POWER_W)
            if v not in done:
                self.via(gnd, self.g(*v))
                done.add(v)

    def testen_via(self) -> None:
        """The TESTEN pad (pin 19) is GND and joined to the exposed pad on F.Cu (qfn_inner). A T_W track
        runs on out of it, between the pin 18 fan-out and XIN, past pin 18's turn, to a locked B.Cu GND
        via just short of the Y1 keepout, whose GND fill reaches the back edge: a GND path from the pad to
        the plane south of U1 that walls no B.Cu route off (deviations BOARD-14)."""
        pads = self.u1_pads()
        (lx, ly), x20 = pads[TESTEN], pads["20"][0]
        ex, ey = self.fan_ends["18"]                          # pin 18 bends at (x18, ty), then 45 deg away
        tx, ty = pads["18"][0], ey - FAN_RUN / math.sqrt(2)
        keep = VIA_R + CLEAR + FAN_W / 2 + T_MARGIN           # via centre to a FAN_W track's centre line
        vx = x20 - keep
        dx = vx - tx
        vy = max(ty + math.sqrt(keep ** 2 - dx ** 2), ty + keep * math.sqrt(2) - dx)   # turn point, diagonal
        cy = self.board.FindFootprintByReference("Y1").GetCourtyard(pcbnew.F_CrtYd).Outline(0)
        top = min(self.local(*self.xy(cy.CPoint(i)))[1] for i in range(cy.PointCount())) - Y1_KEEPOUT_GROW
        if vy + VIA_R + T_MARGIN > top:
            raise SystemExit(f"TESTEN via at y {vy:.3f} reaches the Y1 keepout at {top:.3f}")
        gnd = self.net("U1", TESTEN)
        self.ltrack(gnd, [(lx, ly), (lx, vy - (lx - vx)), (vx, vy)], T_W)
        self.via(gnd, self.g(vx, vy))

    def zone_polys(self, name: str) -> list:
        """Outlines of the rule areas called `name`, in the U1 frame."""
        from shapely.geometry import Polygon
        out = []
        for z in self.board.Zones():
            if z.GetZoneName() == name:
                o = z.Outline().Outline(0)
                out.append(Polygon([self.local(*self.xy(o.CPoint(i))) for i in range(o.PointCount())]))
        return out

    def stub(self, net, a: tuple[float, float], polys: list) -> None:
        """Locked B.Cu from `a` (U1 frame) straight toward the nearest of `polys`, stopping
        SPOKE_KO_GAP short of it, so the GND fill inside the rule area joins it."""
        from shapely.geometry import LineString, Point
        from shapely.ops import nearest_points, unary_union
        area = unary_union(polys)
        q = nearest_points(Point(a), area)[1]
        d = math.dist(a, (q.x, q.y))
        k = (d - SPOKE_W / 2 - SPOKE_KO_GAP) / d
        e = (a[0] + (q.x - a[0]) * k, a[1] + (q.y - a[1]) * k)
        if LineString([a, e]).buffer(SPOKE_W / 2).intersects(area):
            raise SystemExit(f"GND stub from {a} cuts into a keepout")
        self.ltrack(net, [a, e], SPOKE_W, pcbnew.B_Cu)

    def to_edge(self, a: tuple[float, float], d: tuple[float, float]) -> tuple[float, float]:
        """The point from `a` along unit direction `d` (U1 frame) where a SPOKE_W track's copper
        reaches the copper-to-edge clearance of the outline, so no route can pass between."""
        from shapely.geometry import LineString, Point, Polygon
        inner = Polygon(outline_points(self.side)).buffer(-(EDGE_CLEARANCE + SPOKE_W / 2 + SPOKE_KO_GAP))
        start = Point(self.g(*a))
        hit = LineString([self.g(*a), self.g(a[0] + d[0] * 100.0, a[1] + d[1] * 100.0)]).intersection(inner.exterior)
        p = min(getattr(hit, "geoms", [hit]), key=start.distance)
        return self.local(p.x, p.y)

    def ep_caps(self) -> None:
        """Locked B.Cu GND from the exposed pad to every U1 cap's GND via (BOARD-9, BOARD-14): from its
        north-east via under the 3V3 north exit into the north caps' GND via row (C16 / C19 on its west
        end), on the right (EDGE_SPOKE) on from C19's via to the back edge; the east caps' GND vias in a
        row, fed into the GND fill under the USB pair, which meets the spine; C17's via into the GND fill
        under Y1; a diagonal from its north-west via to the west caps' via. Needs USB_KEEPOUT: runs after
        keepout()."""
        from shapely.geometry import Point
        gnd, B = self.net("U1", "57"), pcbnew.B_Cu

        def via_of(cap: str) -> tuple[float, float]:
            (px, py), (dx, dy) = self.lpad(cap, "2"), GND_VIA[cap]
            return round(px + dx, 4), round(py + dy, 4)
        north = sorted(via_of(c) for c in N_CAPS)                 # one row, x ascending
        (x16, _), (x19, y19) = sorted(via_of(c) for c in V11_N_CAPS)
        east = sorted({via_of(c) for c in E_CAPS})
        strip = self.zone_polys("USB_KEEPOUT")
        lo, hi = min(EP_VIAS), max(EP_VIAS)
        x, yn = N_SPOKE_X, north[0][1]
        self.ltrack(gnd, [(x16, y19), (x19, y19), (x, y19 + (x - x19)), (x, yn), north[0], north[-1]], SPOKE_W, B)
        self.ltrack(gnd, [(hi, lo), (x, lo - (hi - x)), (x, yn)], SPOKE_W, B)
        if EDGE_SPOKE[self.side]:
            self.ltrack(gnd, [(x19, y19), self.to_edge((x19, y19), (0.0, -1.0))], SPOKE_W, B)
        self.ltrack(gnd, [east[0], east[-1]], SPOKE_W, B)
        if self.side == "left":
            # only the piece of the keepout under the pair's first run (U1 -> R3 / R4) lies against the
            # spine; the next one starts past the R3 / R4 gap, which routes may cross
            strip = [min(strip, key=lambda p: p.distance(Point(x, yn)))]
        self.stub(gnd, min(east, key=lambda v: min(p.distance(Point(v)) for p in strip)), strip)
        self.stub(gnd, via_of(V11_S_CAP), self.zone_polys("Y1_KEEPOUT"))
        wv = via_of(W_CAPS[0])                                    # C8 / C9 share it
        d = lo - wv[1]
        self.ltrack(gnd, [(lo, lo), (lo - d, lo - d), wv], SPOKE_W, B)

    def crystal(self) -> None:
        """XOUT from its fan end down to R7 beside the crystal, R7 -> Y1 pad 3, and a B.Cu
        track/via keepout over Y1 so the GND pour stays solid under it (spec §6.4)."""
        r7_out, r7_in = self.lpad("R7", "2"), self.lpad("R7", "1")
        ex, ey = self.fan_ends[XOUT_PIN]
        self.ltrack(self.net("U1", XOUT_PIN), [(ex, ey), (r7_out[0], ey + r7_out[0] - ex), r7_out], FAN_W)
        y3 = self.lpad("Y1", "3")
        d = (r7_in[0] - y3[0]) / 2
        self.ltrack(self.net("R7", "1"), [r7_in, (r7_in[0] - d, r7_in[1] + d), (y3[0] + 0.4, r7_in[1] + d)], CAP_LINK_W)
        from shapely.geometry import Polygon
        y1 = self.board.FindFootprintByReference("Y1").GetCourtyard(pcbnew.F_CrtYd).Outline(0)
        poly = Polygon([self.xy(y1.CPoint(i)) for i in range(y1.PointCount())]).buffer(
            Y1_KEEPOUT_GROW, join_style=2)
        z = pcbnew.ZONE(self.board)
        z.SetIsRuleArea(True)
        z.SetLayer(pcbnew.B_Cu)
        z.SetDoNotAllowTracks(True)
        z.SetDoNotAllowVias(True)
        z.SetDoNotAllowPads(False)
        z.SetDoNotAllowZoneFills(False)
        z.SetDoNotAllowFootprints(False)
        z.SetZoneName("Y1_KEEPOUT")
        o = z.Outline()
        o.NewOutline()
        for x, y in list(poly.exterior.coords)[:-1]:
            o.Append(mm(x), mm(y))
        self.board.Add(z)

    @staticmethod
    def fanout_nets(board: pcbnew.BOARD) -> list[str]:
        """U1 signal nets: the maze router routes them at FAN_W (complete_routes.width_class)."""
        u1 = board.FindFootprintByReference("U1")
        skip = set(POWER_NETS) | set(USB_NETS)
        return sorted({p.GetNetname() for p in u1.Pads()
                       if p.GetNetname() and not p.GetNetname().startswith("unconnected-")} - skip)

    # --- USB ------------------------------------------------------------------------------
    def usb(self) -> list[list[tuple[float, float]]]:
        """Lay the pair; return its centre-line(s) for the keepout."""
        pads = self.u1_pads()
        dp, dm = self.net("U1", "47"), self.net("U1", "46")
        (xp, yp), (xm, ym) = pads["47"], pads["46"]
        # U1 frame: north out of the pads (DP outer), east into R3 / R4
        r3, r4 = (self.local(*self.pad_xy(r, "2")) for r in ("R3", "R4"))
        yP, yM = -PAD_END - 0.975, -PAD_END - 0.525
        x_wide = 2.6                                          # 0.15 -> 0.25 past the corner pins
        # out of the pads with 45 deg chamfers (D- bends first, clear of pad 45)
        c = USB_CHAMFER
        self.ltrack(dp, [(xp, yp), (xp, yP + c), (xp + c, yP), (x_wide, yP)], FAN_W)
        self.ltrack(dm, [(xm, ym), (xm, yM + c), (xm + c, yM), (x_wide, yM)], FAN_W)
        ry = r3[1]
        self.ltrack(dp, [(x_wide, yP), (r3[0] - 0.6 - abs(ry - yP), yP), (r3[0] - 0.6, ry), r3], PAIR_W)
        # D- is the inner line of every bend: a 45 deg bump toward the pads evens the lengths
        b0, d = x_wide + 0.3, USB_BUMP
        ry = r4[1]
        self.ltrack(dm, [(x_wide, yM), (b0, yM), (b0 + d, yM + d), (b0 + d + 0.5, yM + d),
                         (b0 + d + 0.5 + abs(yM + d - ry), ry), r4], PAIR_W)
        self.u4_vias()
        self.u4_cap()
        start = [self.g(xp, yP), self.g(r3[0], (yP + yM) / 2)]
        if self.side == "right":
            return [start, *self.usb_right(dp, dm)]
        return [start, *self.usb_left(dp, dm)]

    def u4_vias(self) -> None:
        """U4 GND (pin 2) and VBUS (pin 5) leave between the pass-through rows to vias."""
        u4 = self.board.FindFootprintByReference("U4").GetPosition()
        c = (pcbnew.ToMM(u4.x), pcbnew.ToMM(u4.y))
        for num, width in (("2", POWER_W), ("5", POWER_W)):
            p = self.pad_xy("U4", num)
            d = math.dist(p, c)
            v = (p[0] + (p[0] - c[0]) / d * 1.15, p[1] + (p[1] - c[1]) / d * 1.15)
            self.track(self.net("U4", num), [p, v], width)
            self.via(self.net("U4", num), v)

    def u4_cap(self) -> None:
        """U4's VSYS reference (pin 5): from its via on B.Cu across the D+ row to a second via, then
        F.Cu into C2 pad 1 (10 uF, placed by place.U4_CAP_Y); C2 pad 2 to a GND via (ELEC-2, BOARD-5)."""
        u4 = self.board.FindFootprintByReference("U4")
        c, rot = self.xy(u4.GetPosition()), u4.GetOrientationDegrees()

        def at(lx: float, ly: float) -> tuple[float, float]:
            dx, dy = rotate(lx, ly, rot)
            return c[0] + dx, c[1] + dy
        x = U4_PIN5[0] + U4_VIA_OUT
        vsys, gnd = self.net("U4", "5"), self.net("C2", "2")
        v1, v2 = at(x, 0.0), at(x, U4_CAP_VIA_Y)
        self.track(vsys, [v1, v2], POWER_W, pcbnew.B_Cu)
        self.via(vsys, v2)
        p1, p2 = self.pad_xy("C2", "1"), self.pad_xy("C2", "2")
        self.track(vsys, [v2, p1], POWER_W)
        d = math.dist(p1, p2)                                 # GND via straight on past pad 2
        g = (p2[0] + (p2[0] - p1[0]) / d * CAP_GND_OUT, p2[1] + (p2[1] - p1[1]) / d * CAP_GND_OUT)
        self.track(gnd, [p2, g], POWER_W)
        self.via(gnd, g)

    def usb_right(self, dp, dm) -> list[list[tuple[float, float]]]:
        """Right half: R3/R4 -> U4 rows (rot 0) -> shallow U under the J1 pad row -> rear pads."""
        r3o, r4o = (self.pad_xy(r, "1") for r in ("R3", "R4"))
        u4 = {n: self.pad_xy("U4", n) for n in ("1", "6", "3", "4")}
        for net, r_out, u_in in ((dp, r3o, u4["1"]), (dm, r4o, u4["3"])):
            ry, uy = r_out[1], u_in[1]
            self.track(net, [r_out, (r_out[0] + 0.5, ry), (r_out[0] + 0.5 + abs(uy - ry), uy), u_in], PAIR_W)
        self.track(dp, [u4["1"], u4["6"]], PAIR_W)
        self.track(dm, [u4["3"], u4["4"]], PAIR_W)
        p6, p4 = u4["6"], u4["4"]
        b6, a7 = self.pad_xy("J1", "B6"), self.pad_xy("J1", "A7")
        rear = b6[1] + 0.725                                  # pad rear end
        x_dm, x_dp = p4[0] + 1.9, p4[0] + 2.35
        y_dp, y_dm = rear + 1.53, rear + 1.98
        self.track(dp, [p6, (x_dp - 0.6, p6[1]), (x_dp, p6[1] + 0.6), (x_dp, y_dp), (b6[0], y_dp), b6], PAIR_W)
        self.track(dm, [p4, (x_dm, p4[1]), (x_dm, y_dm), (a7[0], y_dm), a7], PAIR_W)
        self.j1_ties(dp, dm)
        self.j1_escapes(rear)
        return [[self.g(*self.local(*r3o)), ((p6[0] + p4[0]) / 2, (p6[1] + p4[1]) / 2)]]

    def usb_left(self, dp, dm) -> list[list[tuple[float, float]]]:
        """Left half: R3/R4 -> straight run with U4 on it (rotated) -> J1 rear pads."""
        j1 = self.board.FindFootprintByReference("J1").GetPosition()
        a, b = usb_diagonal(self.side, (pcbnew.ToMM(j1.x), pcbnew.ToMM(j1.y)))
        n = math.dist(a, b)
        u = ((b[0] - a[0]) / n, (b[1] - a[1]) / n)
        left = (u[1], -u[0])                                  # y down: left-hand normal

        def P(s: float, off: float) -> tuple[float, float]:
            return a[0] + s * u[0] + off * left[0], a[1] + s * u[1] + off * left[1]
        s4 = U4_L_S
        hp, row = PAIR_PITCH / 2, 0.95
        jog = row - hp
        lines = (("DP", dp, "R3", +1, "1", "6", "B6"), ("DM", dm, "R4", -1, "3", "4", "A7"))
        for _, net, rref, sign, u_in, u_out, jpad in lines:
            r_out = self.pad_xy(rref, "1")
            pin_in, pin_out, pad = self.pad_xy("U4", u_in), self.pad_xy("U4", u_out), self.pad_xy("J1", jpad)
            col = pad[0]
            s_c = (col - a[0] - sign * hp * left[0]) / u[0]
            pts = [r_out, (r_out[0] - 0.5, r_out[1]), P(0, sign * hp),
                   P(s4 - 2.6 - jog, sign * hp), P(s4 - 2.6, sign * row), pin_in, pin_out,
                   P(s4 + 2.6, sign * row), P(s4 + 2.6 + jog, sign * hp), P(s_c, sign * hp), pad]
            self.track(net, pts, PAIR_W)
        self.j1_ties(dp, dm)
        self.u4_gnd_left()
        # no keepout across U4: its pins 2 / 5 sit between the split rows, and the VBUS via
        # can only leave on B.Cu (docs/deviations.md WS2b-7)
        end = (b[0] - a[0]) / u[0] if abs(u[0]) > 1e-9 else n
        gap = 2.6 + jog + U4_KEEPOUT_GAP
        return [[P(0, 0), P(s4 - gap, 0)], [P(s4 + gap, 0), P(end, 0)]]

    def u4_gnd_left(self) -> None:
        """Locked B.Cu GND from U4 pin 2's via to the nearest J1 shell pad.

        The via sits between the F.Cu pair, so this escape cannot leave on F.Cu. C2 and the
        VSYS track occupy U4 -y. The B.Cu keepout covers the pair except the gap around U4,
        and the nearest shell is a through-hole on the +y side of that gap. The right pour
        reaches J1; DRC-clean left seeds still leave this path open, and a tie cannot cross
        the pair (gnd_ties.py)."""
        u4 = self.board.FindFootprintByReference("U4")
        c, rot = self.xy(u4.GetPosition()), u4.GetOrientationDegrees()

        def at(lx: float, ly: float) -> tuple[float, float]:
            dx, dy = rotate(lx, ly, rot)
            return c[0] + dx, c[1] + dy

        def local(x: float, y: float) -> tuple[float, float]:
            return rotate(x - c[0], y - c[1], -rot)

        p = self.pad_xy("U4", "2")
        d = math.dist(p, c)
        via = (p[0] + (p[0] - c[0]) / d * U4_VIA_OUT, p[1] + (p[1] - c[1]) / d * U4_VIA_OUT)
        vx, vy = local(*via)
        if abs(vy) > 0.05:
            raise SystemExit(f"U4 pin 2 via is not on the package axis (local y {vy:.3f})")
        y = vy + U4_GND_SIDE
        corner = at(vx, y)
        sh = min(self.pad_xy_all("J1", "SH"), key=lambda q: math.dist(q, corner))
        sx, sy = local(*sh)
        gap = 2.6 + (0.95 - PAIR_PITCH / 2) + U4_KEEPOUT_GAP
        if abs(vx) >= gap or abs(sx) >= gap or sy <= y:
            raise SystemExit(
                f"J1 shell local ({sx:.2f}, {sy:.2f}) or the pin-2 via ({vx:.2f}) "
                f"is outside the open +y side of the USB keepout gap ({gap:.2f})")
        self.track(self.net("U4", "2"), [via, corner, at(sx, y), sh], POWER_W, pcbnew.B_Cu)

    def j1_ties(self, dp, dm) -> None:
        """A6/B6 (DP) tied in front of the pad row, A7/B7 (DM) behind it."""
        b6, a6, a7, b7 = (self.pad_xy("J1", n) for n in ("B6", "A6", "A7", "B7"))
        tie_rear, tie_front = b6[1] + 0.725 + 0.68, b6[1] - 1.295
        self.track(dm, [a7, (a7[0], tie_rear), (b7[0], tie_rear), b7], PAIR_W)
        self.track(dp, [b6, (b6[0], tie_front), (a6[0], tie_front), a6], PAIR_W)

    def j1_escapes(self, rear: float) -> None:
        gnd_pad, vbus, cc2 = self.pad_xy("J1", "B12"), self.pad_xy("J1", "B9"), self.pad_xy("J1", "B5")
        sh = min((self.pad_xy_all("J1", "SH")), key=lambda p: math.dist(p, gnd_pad) + abs(p[1] - gnd_pad[1]) * 2)
        self.track(self.net("J1", "B12"), [gnd_pad, (gnd_pad[0], sh[1] + 0.6), (sh[0], sh[1] + 0.6)], POWER_W)
        v = (vbus[0], rear + 0.7)
        self.track(self.net("J1", "B9"), [vbus, v], POWER_W)
        self.via(self.net("J1", "B9"), v)
        c = (cc2[0] + 0.25, rear + 0.73)
        self.track(self.net("J1", "B5"), [cc2, (cc2[0], rear + 0.3), c], PAIR_W)
        self.via(self.net("J1", "B5"), c)

    def pad_xy_all(self, ref: str, num: str) -> list[tuple[float, float]]:
        fp = self.board.FindFootprintByReference(ref)
        return [(pcbnew.ToMM(p.GetPosition().x), pcbnew.ToMM(p.GetPosition().y)) for p in fp.Pads() if p.GetNumber() == num]

    # --- matrix ---------------------------------------------------------------------------
    def matrix(self, keys: list[dict]) -> None:
        """Switch -> diode links for every key; rows (F.Cu) and columns (B.Cu) of the main
        block as straight lines with 45 deg jogs; vias at the 25 deg thumb keys' row and column
        pads so the maze router only meets round items there."""
        fps = {f.GetField("Key").GetText() + ":" + f.GetReference()[:1]: f
               for f in self.board.GetFootprints() if f.HasField("Key") and f.GetReference()[:1] in "SD"
               and not f.GetReference().startswith("LED")}
        self.unlocked: list[str] = []
        self.obst = {pcbnew.F_Cu: self.obstacles(pcbnew.F_Cu), pcbnew.B_Cu: self.obstacles(pcbnew.B_Cu)}
        rows, cols = {}, {}
        for k in keys:
            sk, d = fps[k["id"] + ":S"], fps[k["id"] + ":D"]
            frame = KeyFrame(k)
            p1, p2 = (frame.local(*self.pad_xy(sk.GetReference(), n)) for n in ("1", "2"))
            dk, da = (frame.local(*self.pad_xy(d.GetReference(), n)) for n in ("1", "2"))
            mx = self.net(sk.GetReference(), "2")
            for x in MX_X_TRIES:                       # the first vertical clear of holes, keepouts, cutouts
                link = [frame.g(*q) for q in (p2, (x, p2[1]), (x, da[1]), da)]
                if self.clear(link, pcbnew.B_Cu, mx):
                    self.track(mx, link, MATRIX_W, pcbnew.B_Cu)
                    break
            else:                                      # next to a mounting hole: the maze router links it
                self.unlocked.append(sk.GetReference())
            row, col = self.net(d.GetReference(), "1"), self.net(sk.GetReference(), "1")
            ry = dk[1]
            rv, cv = frame.g(dk[0] - ROW_VIA_DX, ry), frame.g(COL_X, p1[1])
            if k["rot"] != 0:                          # thumbs: first via spot clear of holes
                rv = self.via_spot(row, [frame.g(dk[0] - ROW_VIA_DX + dx, ry + dy)
                                         for dx, dy in ((0, 0), (-1.0, 0), (0, 1.2), (-2.0, 0), (-1.0, 1.2))])
                cv = self.via_spot(col, [frame.g(COL_X, p1[1] + dy) for dy in (0, 1.2, -1.2, 2.4, -2.4)])
            self.track(row, [frame.g(*dk), rv], MATRIX_W, pcbnew.B_Cu)
            self.via(row, rv)
            self.track(col, [frame.g(*p1), cv], MATRIX_W, pcbnew.B_Cu)
            self.via(col, cv)
            if k["rot"] == 0:
                rows.setdefault(k["row"], []).append((k, rv, row))
                cols.setdefault(k["col"], []).append((k, cv, col))
        for members in rows.values():
            members.sort(key=lambda m: m[1][0])
            for (ka, a, net), (kb, b, _) in zip(members, members[1:]):
                pts = self.jogged(a, b, (ka["x"] + kb["x"]) / 2, 0, pcbnew.F_Cu, net)
                if pts:
                    self.track(net, pts, MATRIX_W, pcbnew.F_Cu)
                else:                                  # past a mounting hole: the maze router joins the vias
                    self.unlocked.append(f"{ka['id']}-{kb['id']}")
        for members in cols.values():
            members.sort(key=lambda m: m[1][1])
            for (ka, a, net), (kb, b, _) in zip(members, members[1:]):
                pts = self.jogged(a, b, (ka["y"] + kb["y"]) / 2, 1, pcbnew.B_Cu, net)
                if pts:
                    self.track(net, pts, MATRIX_W, pcbnew.B_Cu)
                else:
                    self.unlocked.append(f"{ka['id']}-{kb['id']}")

    def leds(self, leds: list[dict]) -> None:
        """Per-key RGB cells (REVB-8): VSS and the cap's GND pad each to a GND via, VDD to the cap and on
        to a VLED via (the inner planes carry both), DIN and DOUT each to a via, and an F.Cu lane from
        each DOUT via to the next DIN via. A lane with no clear jog is left to the autorouter."""
        B = pcbnew.B_Cu
        ends = []
        for d in leds:
            ref, cap = d["ref"], d["cap"]
            vss, din, vdd, dout = (self.pad_xy(ref, n) for n in "1234")
            c = ((vss[0] + vdd[0]) / 2, (vss[1] + vdd[1]) / 2)
            lu, lv = math.dist(vss, dout), math.dist(vss, din)
            eu = ((dout[0] - vss[0]) / lu, (dout[1] - vss[1]) / lu)
            ev = ((din[0] - vss[0]) / lv, (din[1] - vss[1]) / lv)

            def at(spots):
                return [(c[0] + u * eu[0] + v * ev[0], c[1] + u * eu[1] + v * ev[1]) for u, v in spots]
            gnd, vled = self.net(ref, "1"), self.net(ref, "3")
            c1, c2 = self.pad_xy(cap, "1"), self.pad_xy(cap, "2")
            self.spur(gnd, vss, at(LED_GND_VIA), LED_W)
            self.spur(gnd, c2, at(CAP_GND_VIA), LED_W)
            self.track(vled, [vdd, c1], LED_W, B)
            self.spur(vled, c1, at(CAP_VLED_VIA), LED_W)
            a = self.spur(self.net(ref, "2"), din, at(LED_DIN_VIA), MATRIX_W)
            last = self.pad(ref, "4").GetNetname().startswith("unconnected-")
            b = None if last else self.spur(self.net(ref, "4"), dout, at(LED_DOUT_VIA), MATRIX_W)
            ends.append((ref, a, b))
        for (ref, _, a), (_, b, _) in zip(ends, ends[1:]):
            net = self.net(ref, "4")
            axis = 0 if abs(b[0] - a[0]) >= abs(b[1] - a[1]) else 1
            run = abs(b[axis] - a[axis]) - abs(b[1 - axis] - a[1 - axis])
            pts = self.jogged(a, b, (a[axis] + b[axis]) / 2, axis, pcbnew.F_Cu, net) if run > LANE_MIN_RUN else None
            if pts:
                self.track(net, pts, MATRIX_W, pcbnew.F_Cu)
            else:
                self.unlocked.append(net.GetNetname())

    def plane_vias(self, name: str) -> None:
        """Every top-side SMD pad of plane net `name` (the VLED switch, buffer and their caps) to a via
        beside it, so it reaches its inner plane."""
        for fp in sorted(self.board.GetFootprints(), key=lambda f: f.GetReference()):
            for pad in fp.Pads():
                if pad.GetNetname() != name or fp.IsFlipped() or pad.HasHole():
                    continue
                p = self.xy(pad.GetPosition())
                spots = [(p[0] + r * math.cos(math.radians(a)), p[1] + r * math.sin(math.radians(a)))
                         for r in PLANE_VIA_R for a in range(0, 360, 45)]
                self.spur(pad.GetNet(), p, spots, LED_W, pcbnew.F_Cu)

    def spur(self, net, pad: tuple[float, float], spots: list[tuple[float, float]], width: float,
             layer=pcbnew.B_Cu):
        """Locked copper on `layer` from `pad` to a via at the first of `spots` that is clear."""
        code = net.GetNetCode()
        for v in spots:
            disc = Point(v).buffer(VIA_R)
            if (self.clear([pad, v], layer, net, width)
                    and not any(g.intersects(disc) for layer in self.obst for g, c in self.obst[layer] if c != code)):
                self.track(net, [pad, v], width, layer)
                self.via(net, v)
                return v
        raise SystemExit(f"{net.GetNetname()}: no clear via spot beside the pad at ({pad[0]:.2f}, {pad[1]:.2f})")

    def clear(self, pts, layer, net, width: float = MATRIX_W) -> bool:
        """A polyline on `layer` clear of other nets' pads, holes, keepouts, cutouts and laid copper."""
        line = LineString(pts).buffer(width / 2)
        code = net.GetNetCode()
        return not any(g.intersects(line) for g, c in self.obst[layer] if c != code)

    def via_spot(self, net, spots: list[tuple[float, float]]) -> tuple[float, float]:
        from shapely.geometry import Point
        code = net.GetNetCode()
        for p in spots:
            disc = Point(p).buffer(0.3)
            if not any(g.intersects(disc) for layer in self.obst for g, c in self.obst[layer] if c != code):
                return p
        raise SystemExit(f"{net.GetNetname()}: no clear via spot near {spots[0]}")

    def obstacles(self, layer) -> list:
        """(geometry, net code) of every pad and hole on `layer` (holes: all layers)."""
        from shapely.geometry import Point, box
        out = []
        for fp in self.board.GetFootprints():
            for pad in fp.Pads():
                if pad.HasHole() and pad.GetAttribute() == pcbnew.PAD_ATTRIB_NPTH:
                    r = pcbnew.ToMM(pad.GetDrillSize().x) / 2
                    out.append((Point(*self.xy(pad.GetPosition())).buffer(r + HOLE_CLEAR), -1))
                elif pad.IsOnLayer(layer):
                    bb = pad.GetBoundingBox()
                    (x0, y0), (x1, y1) = self.xy(bb.GetOrigin()), self.xy(bb.GetEnd())
                    out.append((box(x0, y0, x1, y1).buffer(CLEAR), pad.GetNetCode()))
        from shapely.geometry import LineString
        edges = pcbnew.SHAPE_POLY_SET()                # the board outline, kept EDGE_CLEAR away
        if self.board.GetBoardPolygonOutlines(edges, False) and edges.OutlineCount():
            o = edges.Outline(0)
            ring = [self.xy(o.CPoint(i)) for i in range(o.PointCount())]
            out.append((LineString(ring + ring[:1]).buffer(EDGE_CLEAR), -1))
        from shapely.geometry import MultiPoint
        for fp in self.board.GetFootprints():          # rev B LED cutouts (footprint Edge.Cuts): their hull,
            cuts = [g for g in fp.GraphicalItems() if g.GetLayer() == pcbnew.Edge_Cuts]   # so a turned one is not a box
            if cuts:
                ends = [self.xy(q) for g in cuts for q in (g.GetStart(), g.GetEnd())]
                out.append((MultiPoint(ends).convex_hull.buffer(LED_EDGE_CLEAR), -1))
        for z in self.board.Zones():
            if z.GetIsRuleArea() and z.GetDoNotAllowTracks() and z.IsOnLayer(layer):
                from shapely.geometry import Polygon
                o = z.Outline().Outline(0)
                out.append((Polygon([self.xy(o.CPoint(i)) for i in range(o.PointCount())]), -1))
        return out

    @staticmethod
    def xy(v) -> tuple[float, float]:
        return pcbnew.ToMM(v.x), pcbnew.ToMM(v.y)

    def jogged(self, a, b, mid: float, axis: int, layer, net) -> list[tuple[float, float]] | None:
        """a -> b along `axis` (0 = x, 1 = y) with one 45 deg jog near `mid`, clear of pads of
        other nets and of holes; the jog slides along the run until it fits."""
        from shapely.geometry import LineString
        da = abs(b[1 - axis] - a[1 - axis])
        code = net.GetNetCode()

        def clear(pts) -> bool:
            line = LineString(pts).buffer(MATRIX_W / 2)
            return not any(g.intersects(line) for g, c in self.obst[layer] if c != code)

        def P(along: float, across: float) -> tuple[float, float]:
            return (along, across) if axis == 0 else (across, along)
        a0, a1, b1 = a[axis], a[1 - axis], b[1 - axis]
        for off in JOG_TRIES:
            m = mid + off
            pts = [a, P(m - da / 2, a1), P(m + da / 2, b1), b]
            if clear(pts):
                return pts
        # a straight run blocked by a hole keepout: step around it with a 45 deg trapezoid
        if da < 1e-6:
            n = int(abs(b[axis] - a0))
            sign = 1 if b[axis] > a0 else -1
            for depth in DETOUR_DEPTHS:
                for side in (1, -1):
                    for c in range(2, n - 1):
                        cx = a0 + sign * c
                        h = depth + DETOUR_HALF
                        pts = [a, P(cx - sign * h, a1), P(cx - sign * (h - depth), a1 + side * depth),
                               P(cx + sign * (h - depth), a1 + side * depth), P(cx + sign * h, a1), b]
                        if clear(pts):
                            return pts
        return None                     # caller leaves this run to the maze router

    def keepout(self, lines: list[list[tuple[float, float]]]) -> None:
        """B.Cu track keepout under the pair (fills still allowed)."""
        from shapely.geometry import LineString
        from shapely.ops import unary_union
        geom = unary_union([LineString(l).buffer(PAIR_PITCH / 2 + KEEPOUT_GROW, cap_style=2, join_style=2)
                            for l in lines if len(l) > 1])
        for poly in getattr(geom, "geoms", [geom]):
            z = pcbnew.ZONE(self.board)
            z.SetIsRuleArea(True)
            z.SetLayer(pcbnew.B_Cu)
            z.SetDoNotAllowTracks(True)
            z.SetDoNotAllowVias(False)
            z.SetDoNotAllowPads(False)
            z.SetDoNotAllowZoneFills(False)
            z.SetDoNotAllowFootprints(False)
            z.SetZoneName("USB_KEEPOUT")
            o = z.Outline()
            o.NewOutline()
            for x, y in list(poly.exterior.coords)[:-1]:
                o.Append(mm(x), mm(y))
            self.board.Add(z)


class KeyFrame:
    """Switch frame: KiCad screen rotation about the key centre."""
    def __init__(self, k: dict):
        self.x, self.y, self.rot = k["x"], k["y"], k["rot"]

    def g(self, lx: float, ly: float) -> tuple[float, float]:
        dx, dy = rotate(lx, ly, self.rot)
        return self.x + dx, self.y + dy

    def local(self, x: float, y: float) -> tuple[float, float]:
        return rotate(x - self.x, y - self.y, -self.rot)


def offset(pts: list[tuple[float, float]], d: float) -> list[tuple[float, float]]:
    """Polyline offset by d to the left of travel (y down: left normal = (dy, -dx)), mitred."""
    def normal(a, b):
        dx, dy = b[0] - a[0], b[1] - a[1]
        n = math.hypot(dx, dy)
        return dy / n, -dx / n
    segs = [normal(a, b) for a, b in zip(pts, pts[1:])]
    out = []
    for i, (x, y) in enumerate(pts):
        ns = segs[max(i - 1, 0):i + 1]
        mx, my = sum(n[0] for n in ns), sum(n[1] for n in ns)
        m = math.hypot(mx, my)
        mx, my = mx / m, my / m
        k = d / (mx * ns[0][0] + my * ns[0][1])
        out.append((x + mx * k, y + my * k))
    return out


def clear_locked(board: pcbnew.BOARD) -> None:
    """Re-running replaces the critical routes (and nothing else)."""
    for t in list(board.GetTracks()):
        if t.IsLocked():
            board.Delete(t)
    for z in list(board.Zones()):
        if z.GetZoneName() in ("USB_KEEPOUT", "Y1_KEEPOUT"):
            board.Delete(z)


def main(argv: list[str]) -> int:
    if len(argv) != 2 or argv[1] not in ("left", "right"):
        print(__doc__)
        return 2
    side = argv[1]
    path = ROOT / "pcb" / side / f"worxboard-{side}.kicad_pcb"
    seed_kiids(side, b"route_critical", path.read_bytes())
    board = pcbnew.LoadBoard(str(path))
    clear_locked(board)
    r = Router(board, side)
    r.qfn_inner()
    r.power_escapes()
    r.fanout()
    r.decoupling()
    r.testen_via()               # the copper order fixes the seeded KIIDs: keep it (deviations WS2c-4)
    r.crystal()
    r.keepout(r.usb())
    r.ep_caps()
    r.matrix(layout_side(side)["keys"])
    r.leds(layout_side(side)["leds"])
    r.plane_vias("VLED")
    board.Save(str(path))
    print(f"{side}: {r.tracks} locked track segments"
          + (f"; left to the autorouter: {' '.join(r.unlocked)}" if r.unlocked else ""))
    return 0


if __name__ == "__main__":
    sys.exit(main(sys.argv))
