w0rxbend/worxboard/pcb/scripts/place.py

# SPDX-License-Identifier: GPL-3.0-or-later
"""Build the board of one half from its netlist and layout.json (spec §8, §9 stage 7).

    python3 pcb/scripts/place.py <side>   build/<side>/<side>.net -> pcb/<side>/worxboard-<side>.kicad_pcb

Every footprint gets the reference, value, FPID, nets and KIID path of its symbol, so DRC
schematic parity passes. Positions come from layout/build/layout.json (left = mirrored right
frame, rot_L = -rot_R, B-side parts flipped); the MCU cluster is placed in the U1 frame. The
script also draws Edge.Cuts, sets the netclasses and rules (in the .kicad_pro), and adds the
GND pours and silkscreen. It asserts that every top-side courtyard lies in Z_BACK u Z_TRRS.

Runs in kicad/kicad:10.0.7 (pcbnew) with shapely on PYTHONPATH (spec §9.1).
"""
from __future__ import annotations

import json
import math
import sys
import zlib
from pathlib import Path

ROOT = Path(__file__).resolve().parents[2]
sys.path.insert(0, str(Path(__file__).resolve().parent))
sys.path.insert(0, str(ROOT))

import pcbnew  # noqa: E402
from shapely.geometry import Polygon, box  # noqa: E402
from shapely.ops import unary_union  # noqa: E402

from design import POWER_NETS  # noqa: E402
from netcmp import load as load_netlist  # noqa: E402

LAYOUT_JSON = ROOT / "layout/build/layout.json"
STOCK_FP = Path("/usr/share/kicad/footprints")
LOCAL_FP = ROOT / "pcb/lib/worxboard.pretty"
MIRROR_X = 260.0

# Rules (spec §8.4); netclass (track, clearance)
NETCLASSES = {"Default": (0.25, 0.2), "Power": (0.5, 0.2), "USB": (0.25, 0.2)}
USB_NETS = ("USB_DP", "USB_DM", "USB_C_DP", "USB_C_DM")
VIA = (0.6, 0.3)                 # pad, drill
BOARD_MIN = 0.127                # JLC minimum track / clearance
EDGE_CLEARANCE = 0.5
HOLE_CLEARANCE = 0.25
BOARD_T = 1.6
# Four layers (docs/deviations.md REVB-8): In1 is a solid GND plane and In2 the VLED plane, so every GND
# and VLED pad returns through a via beside it and no route decides a ground path
LAYERS = 4
PLANES = ((pcbnew.F_Cu, "GND"), (pcbnew.In1_Cu, "GND"), (pcbnew.In2_Cu, "VLED"), (pcbnew.B_Cu, "GND"))
OUTLINE_W = 0.1
ZONE_CLEARANCE = 0.25
ZONE_MIN_W = 0.25
ZONE_THERMAL = (0.3, 0.4)        # gap, spoke
ARC_STEPS = 16                   # outline fillets in zone polygons
HOLE_KEEPOUT = 6.5               # copper keepout diameter around each mounting hole
ZONE_TOL = 0.02                  # courtyard vs zone check slack (mm)
SILK_TEXT = (1.0, 0.15)          # size, thickness
SKIP_FIELDS = ("Footprint", "Datasheet", "Description", "Reference", "Value")
# Rev B (docs/deviations.md REVB-1): the matrix diode moves from (0, 5.0) in the key frame to below the
# switch's LED window (layout.json "diodes"); the SK6812MINI-E sits in the window (layout.json "leds")
LED_DIR = (-5.65, 1.5)           # DIN (pad 2) -> DOUT (pad 4) of a B.Cu-flipped SK6812MINI-E at rotation 0:
                                 # the 1.5 mm across decides the turn where the chain steps 90 deg
LED_CAP = (-4.6, 0.0)            # its 100 nF, LED frame: beside VDD (pad 3) on the DOUT side, pads along y
STAB_ROT_DIGITS = 3              # stabiliser rotation from layout.json's rounded stab_dir

# U1 (x, y, rot) per half. The RP2040 cannot be mirrored: the left one is turned 180 deg so its
# USB pins face J1, and sits 1.5 mm further back (docs/deviations.md WS2b)
# KiCad saves items sorted by KIID, so random KIIDs reorder the board and with it the order the
# maze router meets the nets. Every board-writing stage seeds the generator from its inputs
# instead, so the same inputs give a byte-identical board (with PYTHONHASHSEED=0, set by pcb.just;
# docs/deviations.md BOARD-2).
KIID_SEED = {"left": 0x4, "right": 0x1}


def layout_seed(side: str) -> bytes:
    """The layout data the board is built from: keys, holes, outline, zones and the J3 pins. The
    fields only the case reads (jack bodies, display module, pocket and window) leave the board as it
    is, so they must not reseed it either (docs/deviations.md BOARD-3)."""
    lay = layout_side(side)
    used = {k: lay[k] for k in ("keys", "leds", "diodes", "holes", "outline", "zones")}
    used["header_pins"] = lay["display"]["header_pins"]
    return json.dumps(used, sort_keys=True).encode()


def seed_kiids(side: str, *inputs: bytes) -> None:
    """Seed KiCad's UUID generator from the stage inputs (distinct inputs -> distinct streams)."""
    crc = KIID_SEED[side]
    for b in inputs:
        crc = zlib.crc32(b, crc)
    pcbnew.KIID.SeedGenerator(crc)


U1_POSE = {"right": (166.0, 44.0, 0.0), "left": (93.4, 42.0, 180.0)}
U1_ROT = {s: p[2] for s, p in U1_POSE.items()}

# MCU cluster in the U1 frame (x, y, rot), mm from the U1 centre; the same on both halves
CLUSTER = {
    "Y1": (-1.07, 8.9, -90), "R7": (1.4, 8.4, 90),                   # XOUT -> R7 beside the crystal
    "R3": (6.5, -5.125, 180), "R4": (6.5, -4.075, 180),              # USB 27R, in the pair
    # decoupling at the exits of the pins they serve (spec §6.4, docs/deviations.md REVIEW-FIX-2);
    # route_critical.decoupling() joins each one to its exit and to a GND via with locked copper
    "C14": (1.2, -6.08, 90), "C15": (2.4, -6.08, 90), "C13": (3.6, -6.08, 90),
    "C10": (4.8, -6.08, 90),                                         # north bus: USB_VDD 48, IOVDD 49
    "C18": (5.8, -2.12, 270), "C11": (7.3, -2.12, 270), "C12": (8.8, -2.12, 270),   # east bus: 42-44
    "C8": (-5.454, -4.3, 180), "C9": (-5.454, -5.6, 180),            # west: pin 1 (and 10 on the moat)
    "C16": (-1.05, -7.6, 90), "C19": (0.05, -7.6, 90),               # 1V1 at the pin-50 fan end (45, 50)
    "C17": (2.45, 8.4, 270),                                         # 1V1 below the pin-23 fan end,
                                                                     # clear of the SWCLK lane (pin 24)
}
CLUSTER_SIDE = {
    "right": {"C6": (-1.0, 12.2, 0), "C7": (1.2, 12.2, 0)},
    "left": {"C6": (-3.3, 9.0, 90), "C7": (4.2, 9.4, 90)},           # the board edge is near
}

# Everything else, right frame (x, y, rot); the left half mirrors x with mirror_rot()
PLACE_R = {
    "U2": (154.6, 35.0, 0), "C5": (160.6, 33.2, 90),                 # flash beside its escapes
    "R8": (147.0, 33.4, 90), "R9": (145.8, 33.4, 90), "R13": (145.0, 46.0, 0),
    "U4": (177.5, 39.4, 0),
    "SW1": (176.0, 50.0, 90), "SW2": (180.0, 50.0, 90),
    "J1": (186.0, 34.25, 180),
    "R1": (189.4, 42.4, 90), "R2": (183.4, 43.2, 0), "R10": (182.6, 47.6, 90),
    "D1": (193.6, 44.2, 90), "C1": (196.1, 44.2, 90),                # C2: beside U4 (U4_CAP)
    "U3": (199.6, 46.4, 0), "C3": (202.8, 45.2, 90), "C4": (202.8, 48.0, 90),
    "R5": (190.6, 47.6, 90), "R6": (190.6, 50.4, 90),
    "JP1": (186.6, 51.6, 0), "F1": (192.8, 52.8, 0),
    "TP11": (171.0, 55.5, 0), "TP6": (177.6, 55.5, 0),
    "TP7": (179.8, 55.5, 0), "TP8": (182.0, 55.5, 0), "TP9": (184.2, 55.5, 0), "TP10": (186.4, 55.5, 0),
    "TP1": (81.6, 44.4, 0), "TP2": (83.8, 44.4, 0), "TP3": (86.0, 44.4, 0),
    "J2": (57.375, 103.0, 0), "U5": (55.4, 94.6, 0), "R11": (61.4, 94.8, 90), "R12": (59.8, 94.8, 90),
    # Rev B RGB (REVB-1): U6 VLED switch beside U3 on VSYS (C20 VLED at OUT, C21 VSYS at IN, R14 ISET,
    # R15 EN pull-down); U7 buffer between U1's GP22 and LED101 (C22 at VCC, R16 at Y)
    "U6": (201.4, 51.2, 0), "C20": (198.4, 50.6, 90), "C21": (204.4, 50.6, 90),
    "R14": (200.0, 54.0, 0), "R15": (203.0, 54.0, 0),
    "U7": (186.8, 46.6, 0), "C22": (187.95, 43.71, 90), "R16": (189.0, 49.4, 90),
}
# Left-half overrides (left frame): the turned U1 puts the flash and the pair elsewhere
PLACE_L = {
    "J1": (74.0, 34.25, 180),
    "U2": (96.0, 53.7, 180), "C5": (90.0, 55.4, 90), "R8": (89.0, 52.6, 90), "R9": (87.8, 52.6, 90),
    "R1": (80.5, 39.6, 0), "R2": (70.2, 43.4, 0),
    "TP11": (81.0, 33.8, 0), "TP6": (81.0, 36.0, 0),
    "TP7": (83.2, 36.0, 0), "TP8": (87.6, 34.0, 0), "TP9": (87.6, 36.2, 0), "TP10": (85.4, 36.2, 0),
    # RGB: SOT-23-5 pins cannot mirror, so U6 keeps the right half's turn and its passives keep their
    # pins (not mirrored); U7 turns 180 so its input faces U1
    "U6": (58.6, 51.2, 0), "C20": (55.6, 50.6, 90), "C21": (61.6, 50.6, 90),
    "R14": (57.2, 54.0, 0), "R15": (60.2, 54.0, 0),
    # U7, C22, R16 sit west of D1, beside U6, not between J1/U4 and the main GND plane: placed south of U4 and
    # C2 they cut the GND pour there and U4's clamp GND could not reach J1 (gnd_ties.py, deviations REVB-7)
    "U7": (65.6, 49.0, 180), "C22": (63.51, 51.31, 0), "R16": (63.65, 46.64, 0),
}

# Left USB pair: a straight run from past R3/R4 to the J1 columns, U4 on it (route_critical.py)
USB_L_START = (7.8, -4.6)        # U1 frame
USB_L_END_DY = 1.0               # end of the diagonal below the J1 pad rear ends
U4_L_S = 8.6                     # U4 centre along the diagonal

# U4's clamp reference, pin 5, is on VSYS (docs/deviations.md ELEC-2). C2, one of the two 10 uF VSYS
# caps, sits beside the pin's via on the free D+ side, pad 1 toward U4, so the TVS reference has its
# cap within 4 mm of copper; route_critical.u4_cap() joins them (docs/deviations.md BOARD-5). U4 frame
U4_PIN5 = (1.1375, 0.0)          # SOT-23-6 pad 5 (VSYS); pad 2 (GND) mirrors it
U4_VIA_OUT = 1.15                # pin-5 / pin-2 via this far out past the pad centre
U4_CAP_Y = -3.695                # C2 centre: across the D+ row (pins 1 / 6 at y -0.95). Rev B: C2 is 0603
                                 # (pads at +-0.775, were +-0.48), so its centre moves 0.295 mm out and pad 1
                                 # stays where the 0402's was, clear of the VSYS via (REVB-3)
U4_CAP_VIA_Y = -2.0              # VSYS via between the D+ row and C2 pad 1

# Silkscreen, right frame (text, x, y, rot)
SILK = [("worxboard {S} rev B", 130.0, 45.0, 0),
        ("DO NOT HOT-PLUG TRRS", 51.6, 116.0, 90), ("HOST → LEFT", 53.4, 116.0, 90),
        ("JP1: cut = split power", 186.6, 54.2, 0)]

# Courtyards allowed past the zones (mm): J2's sleeve pad and snout, J1's snout
ZONE_ALLOW = {"J2": 1.4, "J1": 0.0}


def mm(v: float) -> int:
    return pcbnew.FromMM(v)


def pt(x: float, y: float) -> pcbnew.VECTOR2I:
    return pcbnew.VECTOR2I(mm(x), mm(y))


def rotate(x: float, y: float, deg: float) -> tuple[float, float]:
    """KiCad screen rotation (y down, positive CCW on screen)."""
    c, s = math.cos(math.radians(deg)), math.sin(math.radians(deg))
    return x * c + y * s, -x * s + y * c


def mirror_rot(rot: float) -> float:
    """Rotation of a part mirrored to the left half (pin geometry of 2-pin parts is mirrored)."""
    return (180.0 - rot) % 360.0


def layout_side(side: str) -> dict:
    return json.loads(LAYOUT_JSON.read_text())["sides"][side]


def u1_frame(side: str, lx: float, ly: float) -> tuple[float, float]:
    ux, uy, rot = U1_POSE[side]
    dx, dy = rotate(lx, ly, rot)
    return ux + dx, uy + dy


def usb_diagonal(side: str, j1: tuple[float, float]) -> tuple[tuple[float, float], tuple[float, float]]:
    """Left half: start and end of the straight pair run (end below the J1 pair columns)."""
    a = u1_frame(side, *USB_L_START)
    b = (j1[0] - 0.5, j1[1] + JACK_REAR + USB_L_END_DY)
    return a, b


JACK_REAR = 4.77                 # J1 origin -> pad row rear end (rotated 180: 4.045 + 1.45 / 2)


def top_positions(side: str) -> dict[str, tuple[float, float, float]]:
    """Every top-side part: (x, y, rot) in the side's own frame."""
    out = {}
    for ref, (x, y, r) in PLACE_R.items():
        out[ref] = (x, y, r) if side == "right" else (MIRROR_X - x, y, mirror_rot(r))
    if side == "left":
        out.update(PLACE_L)
    out["U1"] = U1_POSE[side]
    rot = U1_ROT[side]
    for ref, (lx, ly, lr) in {**CLUSTER, **CLUSTER_SIDE[side]}.items():
        out[ref] = (*u1_frame(side, lx, ly), (rot + lr) % 360.0)
    if side == "left":
        (x0, y0), (x1, y1) = usb_diagonal(side, out["J1"][:2])
        n = math.hypot(x1 - x0, y1 - y0)
        ux, uy = (x1 - x0) / n, (y1 - y0) / n
        out["U4"] = (x0 + U4_L_S * ux, y0 + U4_L_S * uy, math.degrees(math.atan2(-uy, ux)))
    x4, y4, r4 = out["U4"]
    dx, dy = rotate(U4_PIN5[0] + U4_VIA_OUT, U4_CAP_Y, r4)
    out["C2"] = (x4 + dx, y4 + dy, (r4 + 90.0) % 360.0)   # footprint +x (pad 1 -> 2) along U4 -y
    lay = layout_side(side)
    p1 = lay["display"]["header_pins"][0]             # J3 pin 1 (MOSI) at high x, pins along -x
    out["J3"] = (p1[0], p1[1], 270.0)                 # under nice!view pin n (gate G1, BOARD-1)
    return out


def led_poses(lay: dict) -> dict[str, tuple[float, float, float]]:
    """LED and LED-cap (x, y, rot) on B.Cu: each LED turned (key rot or key rot + 180) so its DIN -> DOUT
    runs along the chain towards the next LED (the last one keeps the incoming direction)."""
    out, prev = {}, None
    for d in lay["leds"]:
        nxt = d["next"] or prev
        best = None
        for r in (d["rot"], d["rot"] + 180.0):
            u = rotate(*LED_DIR, r)
            score = u[0] * nxt[0] + u[1] * nxt[1]
            if best is None or score > best[0] + 1e-9:
                best = (score, r % 360.0)
        r = best[1]
        out[d["ref"]] = (d["x"], d["y"], r)
        dx, dy = rotate(*LED_CAP, r)
        out[d["cap"]] = (d["x"] + dx, d["y"] + dy, (r + 90.0) % 360.0)
        prev = nxt
    return out


def load_fp(fpid: str) -> pcbnew.FOOTPRINT:
    lib, name = fpid.split(":")
    path = LOCAL_FP if lib == "worxboard" else STOCK_FP / f"{lib}.pretty"
    fp = pcbnew.FootprintLoad(str(path), name)
    if fp is None:
        raise SystemExit(f"footprint {fpid} not found")
    fp.SetFPID(pcbnew.LIB_ID(lib, name))
    return fp


def place(fp: pcbnew.FOOTPRINT, x: float, y: float, rot: float, back: bool = False) -> None:
    fp.SetPosition(pt(x, y))
    if back:
        fp.Flip(fp.GetPosition(), pcbnew.FLIP_DIRECTION_LEFT_RIGHT)
    fp.Rotate(fp.GetPosition(), pcbnew.EDA_ANGLE(rot, pcbnew.DEGREES_T))


def add_footprints(board: pcbnew.BOARD, side: str, net_path: Path) -> None:
    nl = load_netlist(net_path)
    nets = {}
    for name in sorted(nl.nets):
        ni = pcbnew.NETINFO_ITEM(board, name)
        board.Add(ni)
        nets[name] = ni
    lay = layout_side(side)
    keys = {k["id"]: k for k in lay["keys"]}
    holes = lay["holes"]
    top = top_positions(side)
    rgb = led_poses(lay)
    tstamps = _tstamps(net_path)
    for ref in sorted(nl.comps, key=_ref_key):
        c = nl.comps[ref]
        fp = load_fp(c.footprint)
        fp.SetReference(ref)
        fp.SetValue(c.value)
        fp.SetPath(pcbnew.KIID_PATH(f"/{tstamps[ref]}"))
        for name, value in c.fields.items():           # symbol fields (parity checks them)
            if name not in SKIP_FIELDS:
                fp.SetField(name, value)
                fp.GetField(name).SetVisible(False)
        fp.SetExcludedFromBOM("exclude_from_bom" in c.props)
        fp.SetDNP("dnp" in c.props)
        board.Add(fp)
        for pad in fp.Pads():
            hit = c.pins.get(pad.GetNumber())
            if hit:
                pad.SetNet(nets[hit[1]])
        key = c.fields.get("Key")
        if ref in rgb:                                  # LED<n> and its C<n> (rev B)
            place(fp, *rgb[ref], back=True)
        elif key and ref.startswith("SK"):
            k = keys[key]
            place(fp, k["x"], k["y"], k["rot"], back=True)
        elif key:
            k = keys[key]
            place(fp, *lay["diodes"][key], k["rot"] + 180.0, back=True)
        elif "Hole" in c.fields:
            place(fp, *holes[int(c.fields["Hole"])], 0.0)
        else:
            place(fp, *top[ref])
        fp.Reference().SetVisible(ref.startswith(("J", "SW", "JP", "U")))
    for k in lay["keys"]:
        if "stabs" in k:
            dx, dy = k["stab_dir"]               # footprint +y (the Ø4.0 housing holes) -> stab_dir
            stab = load_fp("worxboard:Stab_MX_2u")
            stab.SetReference(f"STAB_{k['id']}")
            stab.Reference().SetVisible(False)
            board.Add(stab)
            place(stab, k["x"], k["y"], round(math.degrees(math.atan2(dx, dy)), STAB_ROT_DIGITS))


def _ref_key(ref: str) -> tuple[str, int]:
    head = ref.rstrip("0123456789")
    return head, int(ref[len(head):] or 0)


def _tstamps(net_path: Path) -> dict[str, str]:
    """ref -> symbol uuid (netlist comp tstamps)."""
    from netcmp import find, find_all, parse, val
    root = parse(net_path.read_text())
    return {val(c, "ref"): val(c, "tstamps") for c in find_all(find(root, "components"), "comp")}


def outline_points(side: str) -> list[tuple[float, float]]:
    """Closed outline with the fillets sampled (zones, checks)."""
    pts = []
    for s in layout_side(side)["outline"]["segments"]:
        if s["type"] == "line":
            pts.append(tuple(s["start"]))
            continue
        (cx, cy), (sx, sy), (ex, ey), (mx_, my) = s["centre"], s["start"], s["end"], s["mid"]
        a0, a1 = math.atan2(sy - cy, sx - cx), math.atan2(ey - cy, ex - cx)
        am = math.atan2(my - cy, mx_ - cx)
        sweep = (a1 - a0 + math.pi) % (2 * math.pi) - math.pi
        if abs(((am - a0 + math.pi) % (2 * math.pi) - math.pi)) > abs(sweep):
            sweep -= math.copysign(2 * math.pi, sweep)
        r = math.hypot(sx - cx, sy - cy)
        pts += [(cx + r * math.cos(a0 + sweep * i / ARC_STEPS), cy + r * math.sin(a0 + sweep * i / ARC_STEPS))
                for i in range(ARC_STEPS)]
    return pts


def add_outline(board: pcbnew.BOARD, side: str) -> None:
    for s in layout_side(side)["outline"]["segments"]:
        shape = pcbnew.PCB_SHAPE(board)
        shape.SetLayer(pcbnew.Edge_Cuts)
        shape.SetWidth(mm(OUTLINE_W))
        if s["type"] == "line":
            shape.SetShape(pcbnew.SHAPE_T_SEGMENT)
            shape.SetStart(pt(*s["start"]))
            shape.SetEnd(pt(*s["end"]))
        else:
            shape.SetShape(pcbnew.SHAPE_T_ARC)
            shape.SetArcGeometry(pt(*s["start"]), pt(*s["mid"]), pt(*s["end"]))
        board.Add(shape)


def add_zones(board: pcbnew.BOARD, side: str) -> None:
    for layer, net in PLANES:
        z = pcbnew.ZONE(board)
        z.SetLayer(layer)
        z.SetNet(board.FindNet(net))
        z.SetZoneName(f"{net}_{board.GetLayerName(layer)}")
        z.SetLocalClearance(mm(ZONE_CLEARANCE))
        z.SetMinThickness(mm(ZONE_MIN_W))
        z.SetPadConnection(pcbnew.ZONE_CONNECTION_THERMAL)
        z.SetThermalReliefGap(mm(ZONE_THERMAL[0]))
        z.SetThermalReliefSpokeWidth(mm(ZONE_THERMAL[1]))
        z.SetIslandRemovalMode(pcbnew.ISLAND_REMOVAL_MODE_ALWAYS)
        outline = z.Outline()
        outline.NewOutline()
        for x, y in outline_points(side):
            outline.Append(mm(x), mm(y))
        board.Add(z)


def add_hole_keepouts(board: pcbnew.BOARD, side: str) -> None:
    """Copper keepout around each M2.5 hole (spec §8.2: case boss / screw head)."""
    from shapely.geometry import Point
    for i, (x, y) in enumerate(layout_side(side)["holes"]):
        z = pcbnew.ZONE(board)
        z.SetIsRuleArea(True)
        z.SetLayerSet(pcbnew.LSET.AllCuMask(LAYERS))
        for attr in ("Tracks", "Vias", "ZoneFills"):
            getattr(z, f"SetDoNotAllow{attr}")(True)
        z.SetDoNotAllowPads(False)
        z.SetDoNotAllowFootprints(False)
        z.SetZoneName(f"HOLE_{i}")
        o = z.Outline()
        o.NewOutline()
        for px, py in list(Point(x, y).buffer(HOLE_KEEPOUT / 2, quad_segs=8).exterior.coords)[:-1]:
            o.Append(mm(px), mm(py))
        board.Add(z)


def add_silk(board: pcbnew.BOARD, side: str) -> None:
    for text, x, y, rot in SILK:
        t = pcbnew.PCB_TEXT(board)
        t.SetText(text.format(S=side[0].upper()))
        t.SetLayer(pcbnew.F_SilkS)
        t.SetPosition(pt(x if side == "right" else MIRROR_X - x, y))
        t.SetTextAngle(pcbnew.EDA_ANGLE(rot, pcbnew.DEGREES_T))
        t.SetTextSize(pcbnew.VECTOR2I(mm(SILK_TEXT[0]), mm(SILK_TEXT[0])))
        t.SetTextThickness(mm(SILK_TEXT[1]))
        board.Add(t)


def setup_board(board: pcbnew.BOARD) -> None:
    ds = board.GetDesignSettings()
    ds.SetBoardThickness(mm(BOARD_T))
    board.SetCopperLayerCount(LAYERS)
    ds.m_TrackMinWidth = mm(BOARD_MIN)
    ds.m_MinClearance = mm(BOARD_MIN)
    ds.m_CopperEdgeClearance = mm(EDGE_CLEARANCE)
    ds.m_HoleClearance = mm(HOLE_CLEARANCE)


def write_rules(pro: Path) -> None:
    """Netclasses and DRC rules live in the project file (kept: what gen_sch.py wrote)."""
    data = json.loads(pro.read_text()) if pro.exists() else {"meta": {"filename": pro.name, "version": 3}}
    classes = []
    for name, (track, clear) in NETCLASSES.items():
        classes.append({"name": name, "track_width": track, "clearance": clear, "via_diameter": VIA[0],
                        "via_drill": VIA[1], "microvia_diameter": 0.3, "microvia_drill": 0.1,
                        "diff_pair_width": 0.25, "diff_pair_gap": 0.2, "diff_pair_via_gap": 0.25,
                        "bus_width": 12, "wire_width": 6, "line_style": 0,
                        "priority": 2147483647 if name == "Default" else len(classes),
                        "pcb_color": "rgba(0, 0, 0, 0.000)", "schematic_color": "rgba(0, 0, 0, 0.000)",
                        "tuning_profile": ""})
    patterns = [{"netclass": "Power", "pattern": n} for n in POWER_NETS]
    patterns += [{"netclass": "USB", "pattern": n} for n in USB_NETS]
    data["net_settings"] = {"classes": classes, "meta": {"version": 5}, "net_colors": None,
                            "netclass_assignments": None, "netclass_patterns": patterns}
    severities = {k: "error" for k in ("missing_footprint", "extra_footprint", "net_conflict",
                                       "footprint_symbol_mismatch", "duplicate_footprints")}
    severities.update({k: "warning" for k in ("lib_footprint_issues", "lib_footprint_mismatch",
                                              "silk_overlap", "text_height", "text_thickness",
                                              "npth_inside_courtyard")})
    data["board"] = {"design_settings": {
        "rules": {"min_clearance": BOARD_MIN, "min_track_width": BOARD_MIN,
                  "min_copper_edge_clearance": EDGE_CLEARANCE, "min_hole_clearance": HOLE_CLEARANCE,
                  "min_hole_to_hole": 0.25, "min_via_diameter": VIA[0], "min_through_hole_diameter": VIA[1],
                  "min_via_annular_width": 0.13, "min_connection": 0.0, "min_groove_width": 0.0,
                  "min_silk_clearance": 0.0, "min_text_height": 0.8, "min_text_thickness": 0.12,
                  "min_microvia_diameter": 0.2, "min_microvia_drill": 0.1, "min_resolved_spokes": 1,
                  "solder_mask_to_copper_clearance": 0.0, "allow_blind_buried_vias": False,
                  "allow_microvias": False, "max_error": 0.005, "use_height_for_length_calcs": True},
        "rule_severities": severities,
        "track_widths": [0.0, 0.15, 0.25, 0.5], "via_dimensions": [{"diameter": 0.0, "drill": 0.0}],
        "meta": {"version": 2}}}
    pro.write_text(json.dumps(data, indent=2) + "\n")
    pro.with_suffix(".kicad_dru").write_text(DRU)


# Custom rules (worxboard-<side>.kicad_dru). The SK6812MINI-E pads sit 0.348 mm from their own cutout
# (gen_footprints.py), so copper may come to 0.3 mm of the LED cutouts; the outline keeps the 0.5 mm
# copper-to-edge rule (mouse bites, case). JLC and PCBWay route to 0.3 mm (docs/deviations.md REVB-1)
LED_EDGE_CLEARANCE = 0.3         # the routers keep this (route_critical, complete_routes)
LED_EDGE_DRC_TOL = 0.01          # DRC allows 10 um under it: the cutout's arcs are polygons on the router's
                                 # grid (a VLED track once landed at 0.298 mm; REVB-7)
DRU = f"""(version 1)
(rule "copper to the LED cutouts"
\t(condition "A.Type != 'Zone' && B.Layer == 'Edge.Cuts' && B.memberOfFootprint('LED*')")
\t(constraint edge_clearance (min {LED_EDGE_CLEARANCE - LED_EDGE_DRC_TOL:g}mm)))
"""                              # pads and tracks only: the pours and the inner planes keep 0.5 mm, so no
                                 # plane edge shows at a cutout wall (REVB-8)


def courtyard(fp: pcbnew.FOOTPRINT) -> Polygon | None:
    sps = fp.GetCourtyard(pcbnew.F_CrtYd)
    if sps.OutlineCount() == 0:
        return None
    polys = []
    for i in range(sps.OutlineCount()):
        o = sps.Outline(i)
        polys.append(Polygon([(pcbnew.ToMM(o.CPoint(j).x), pcbnew.ToMM(o.CPoint(j).y)) for j in range(o.PointCount())]))
    return unary_union(polys)


def check_zones(board: pcbnew.BOARD, side: str) -> list[str]:
    lay = layout_side(side)
    pcb = Polygon(outline_points(side))
    zones = []
    for name in ("Z_BACK", "Z_TRRS"):
        for p in lay["zones"][name]:
            zones.append(Polygon(p["exterior"], p.get("holes", [])))
    allowed = unary_union(zones)
    errs = []
    for fp in board.GetFootprints():
        ref = fp.GetReference()
        if fp.IsFlipped() or ref.startswith(("H", "STAB_")):
            continue
        cy = courtyard(fp)
        if cy is None:
            errs.append(f"{ref}: no courtyard")
            continue
        out = cy.intersection(pcb).difference(allowed.buffer(ZONE_TOL + ZONE_ALLOW.get(ref, 0.0)))
        if out.area > 1e-4:
            b = out.bounds
            errs.append(f"{ref}: courtyard outside Z_BACK/Z_TRRS by {out.area:.3f} mm2 near ({b[0]:.1f},{b[1]:.1f})")
    return errs


def main(argv: list[str]) -> int:
    if len(argv) != 2 or argv[1] not in ("left", "right"):
        print(__doc__)
        return 2
    side = argv[1]
    net_path = ROOT / "build" / side / f"{side}.net"
    pcb_path = ROOT / "pcb" / side / f"worxboard-{side}.kicad_pcb"
    sch = pcb_path.with_suffix(".kicad_sch")    # the netlist carries an export date: seed from its source
    seed_kiids(side, b"place", side.encode(), sch.read_bytes(), layout_seed(side))
    board = pcbnew.BOARD()
    setup_board(board)
    add_footprints(board, side, net_path)
    add_outline(board, side)
    add_zones(board, side)
    add_hole_keepouts(board, side)
    add_silk(board, side)
    errs = check_zones(board, side)
    write_rules(pcb_path.with_suffix(".kicad_pro"))
    board.Save(str(pcb_path))
    print(f"wrote {pcb_path.relative_to(ROOT)}: {len(board.GetFootprints())} footprints")
    for e in errs:
        print(f"ZONE: {e}")
    return 1 if errs else 0


if __name__ == "__main__":
    sys.exit(main(sys.argv))
