w0rxbend/worxboard/(commit log)

2026-10-28 docs: add frozen rev A design specification
    Research + three-way architecture panel output: on-board RP2040, ZMK wired
    split over TRRS, nice!view-class LCD replacing the inner-column top key,
    USB-C on both halves with diode-OR power sharing, generated KiCad pipeline.
2026-10-28 chore: add repo foundations, licences and stream justfile stubs
    Root justfile imports each stream's *.just, pyproject/uv.lock pin Python 3.12
    with layout/case/dev groups, .gitignore stops ignoring /zephyr/, and
    LICENSE-HARDWARE adds CERN-OHL-S-2.0 for the hardware.
2026-10-28 feat(layout): add the single-source layout package and exporters
    Keys (original ErgoDox centres), 25 degree thumbs, display, J1/J2 anchors,
    holes with #7 moved, outline with the TRRS bump, Z_BACK/Z_TRRS zones and the
    frozen pins.py. export.py writes layout/build/layout.json, docs/images/layout.svg
    and build/kle.json; pytest covers every WS0 acceptance item.
2026-10-28 feat(firmware): add ZMK module for the on-board RP2040 halves
    Custom HWMv2 boards (worxboard, experimental worxboard2/RP2350A) from the
    compiled seed: wired split on UART0, PIO1-SPI ls0xx display, right .dts
    reverses col-gpios so both PCBs share one matrix netlist. Physical layout
    and matrix transform are generated from layout/build/layout.json; 74-key
    3-layer keymap after the EZ default; custom right LVGL screen with host
    lock indicators. west.yml pinned to zmk 4dd95d78; just fw builds every
    build.yaml row in zmk-build-arm.
    [check_keymap.py, fw_build.py, fw_check.py, gen_layouts.py]
2026-10-28 ci(firmware): build every build.yaml row in zmk-build-arm and record WS1 deviations
2026-10-28 docs: add the rev A documentation set with generated pinout and matrix
    Build guide, BOM with [G3] flags, electrical notes, JLCPCB ordering, case, legs,
    firmware and sources pages. site/gen_docs.py generates pinout.md and matrix.md
    from layout.json; just docs-gen / docs-check (no-diff + lychee link check).
2026-10-28 feat(site): add the three.js microsite built from layout.json
    Viewer adapted from the ErgoDox case site: PCB, switches, keycaps with legends
    and displays generated from layout.json, case STLs and legs added when built.
    pages.yml builds and deploys on workflow_dispatch only.
2026-10-28 docs(firmware): match the committed WS1 firmware: pin, checks, generated transform
2026-10-28 feat(pcb): vendor the MX hot-swap, 2u stabiliser footprints and SW_Push_MX symbol
    [gen_footprints.py]
2026-10-28 feat(pcb): add design.py data, schematic generator, netcmp and stage A
2026-10-28 feat(pcb): commit generated left/right schematics (ERC clean, netcmp passing)
    [worxboard-left.kicad_sch, worxboard-right.kicad_sch]
2026-10-28 docs(images): refresh the viewer screenshot with the case parts
2026-10-28 docs(case): record WS3 deviations
2026-10-28 feat(case): port the build123d case to the worxboard layout
    Case outline from the PCB polygon + 3.5 mm, display pocket and window,
    USB-C and TRRS notches on both halves, moved hole 7, stock-position tent
    legs, plate spacer, fit-check DXFs, plate DXFs, and the case checks.
    [worxboard-plate-left.dxf, worxboard-plate-right.dxf]
2026-10-28 feat(case): add drawings, order package, PCB fit check and overlay
2026-10-28 feat(case): add preview render tools and committed renders
2026-10-28 ci(case): add case workflow running model, fitcheck, renders and order
2026-10-29 feat(pcb): add placement, critical-route, DSN/SES and check stages (§9 stages 7-12)
    place.py builds each half from its netlist and layout.json (Edge.Cuts, holes and
    copper keepouts, GND pours, rules and netclasses in the project file).
    route_critical.py lays the locked QFN fan-out, inner power joins, USB pair and the
    key matrix. export_dsn.py / import_ses.py adapt the Freerouting round trip;
    checks.py runs the USB, Y1, outline and DRC checks. Routing is not complete yet.
2026-10-29 feat(pcb): corner fan-out, matrix pre-routing and a completion router
    route_critical.py lays a 45 deg corner fan-out of the RP2040, the inner power
    joins, the USB pair (with a D- bump for length matching) and the whole key
    matrix. export_dsn.py strips U1's pins from the DSN nets and fixes pad shapes
    and half-micron pin offsets for Freerouting. complete_routes.py finishes what
    Freerouting leaves open with a two-layer A* router with rip-up and reroute,
    then joins GND pads the pours left isolated. Deviations recorded as WS2b.
    [complete_routes.py, place.py, route_critical.py]
2026-10-29 feat(pcb): via-ended column fan-out, staged completion and pcb recipes
    COL0 and COL4-COL6 leave the fan-out through vias so they cross under U1 on
    B.Cu. The completion router now uses KiCad-style anchor connectivity, routes
    cleanly before it rips anything, and deletes orphaned pieces; stage_c.sh runs
    more completion rounds while DRC still lists unconnected items. The left U1
    moved to keep its USB path within 25 mm; SWD test pads moved next to the pins.
    Adds just pcb <side> and pcb-all.
2026-10-29 fix(pcb): keep completion rip-up off by default and widen late rounds
    [complete_routes.py]
2026-10-29 feat(pcb): add placed and routed left/right boards (DRC 0 violations, 10/11 unconnected)
    [worxboard-left.kicad_pcb, worxboard-right.kicad_pcb]
2026-10-29 feat(pcb): transactional rip-up completion; left board routed (DRC clean, 0 unconnected)
    - complete_routes.negotiate(): soft-route an open gap across unlocked copper, rip it up,
    reroute the victims (three levels), keep the change only if fewer islands remain
    - exact path check against fixed copper so stub ends 0.3 mm from a via can escape
    - delete copper with BOARD.Delete (Remove + GC corrupted the board under SWIG)
    - drop Freerouting tracks below the 0.127 mm board minimum before completion
    - left half: no B.Cu USB keepout across U4, so its VBUS via can leave
    [worxboard-left.kicad_pcb]
2026-10-29 feat(pcb): route both halves to 0 unconnected (DRC + checks pass)
    - negotiate: protected nets are dear rather than fixed, GND judged on a fresh fill,
    stuck nets spared on the next try, lanes kept clear ahead of locked stub ends
    - pours join pads by overlap and tracks / vias only by anchor, as in KiCad
    - left and right boards regenerated: 0 violations, 0 unconnected, 0 parity issues
    - deviations WS2b-6 (rip-up) and WS2b-7 (left U4 keepout gap)
    [worxboard-left.kicad_pcb, worxboard-right.kicad_pcb]
2026-10-29 feat(pcb): stage D fab outputs, renders, Edge DXF and STEP (§9 stages 13-14)
2026-10-29 ci(pcb): add pcb workflow: schematics, DRC gate, fab outputs and a from-scratch rebuild
2026-10-29 ci(pcb): generate the netlist before the from-scratch placement
2026-10-29 feat(pcb): seed KIIDs and the hash seed so a clean rebuild reproduces the boards
    place/route_critical/import_ses seed KiCad's UUID generator from their inputs and a
    per-side base seed; pcb.just runs with PYTHONHASHSEED=0. Boards re-made from scratch
    with the seeded pipeline (DRC 0 violations, 0 unconnected, checks pass), renders refreshed.
    [worxboard-left.kicad_pcb, worxboard-right.kicad_pcb]
2026-10-29 ci(pcb): require the from-scratch rebuild to equal the committed board
2026-11-02 fix(pcb): make the not-assembled BOM/CPL guard immune to SIGPIPE
    The guard piped bom.csv and pos.csv designators into `grep -q`. grep exits on
    the first match, the writer dies of SIGPIPE, and under pipefail the pipeline
    returns 141, so the `if` missed most bom.csv hits. Collect the designators
    first (CRs stripped), grep a here-string, and name the offending parts.
    Correct deviation WS2c-1 to state what the guard checks and how it was tested.
2026-11-02 fix(pcb): leave DNP J3 out of the STEP so the case fit check passes
    The stock PinSocket_1x05 model is 8.5 mm tall and pokes 0.3 mm through the
    display-pocket ceiling; G1 owns the display stack height. Export the STEP with
    --no-dnp, fail if the socket body still reaches it, record deviation WS2c-5,
    and add a pcb.yml `fit` job that runs just model && just fitcheck against the
    board job's STEPs.
2026-11-02 feat(docs): generate the BOM, part positions and socket tables from the PCB data
    site/pcbdata.py reads pcb/scripts/design.py and the committed boards
    (footprint poses and Fab outlines). gen_docs.py now writes the JLC BOM
    and the not-assembled parts into bom.md between GENERATED markers, the
    as-built part positions into pinout.md and the SK/D references per key
    into matrix.md, and fails if a design part differs from either board.
    [gen_docs.py, pcbdata.py]
2026-11-02 docs: refresh the guides to the routed boards, built firmware and modelled case
    Build guide: real references, JP1 in the back strip, SWD pads, screw
    lengths, display orientation caveat. Electrical: reference designators,
    as-built USB lengths, placement and routing notes, the PCB pipeline.
    Firmware: all six rows build, known issues. Ordering: CI artifacts,
    not-assembled guard, stock warning. Case and legs: as-built values and
    renders. Sources: the tools actually used.
2026-11-02 feat(site): place the assembled board parts in the viewer and show the final status
    build_site.py adds every assembled part of the committed boards to the
    manifest (footprint pose, Fab-outline box) and the viewer draws them, so
    the left RP2040 and flash sit where WS2 placed them. The page gets the
    final status table, known open issues and links to the CI artifacts; the
    gallery is ordered PCB renders first, then the case renders. pages.yml
    installs the font the case side mark needs and stays manual-only.
    Fresh viewer screenshots.
    [build_site.py]
2026-11-02 docs(readme): describe the finished rev A: status, artifacts, previews, open issues
    README: CI badges for every workflow, the viewer as the hero image, the
    real state of each area, the CI artifacts, PCB and case previews, build
    commands with their run times and the known open issues. Deviations:
    record WS4-1 (docs and viewer read the PCB data) and WS4-2 (manual Pages
    deploy).
2026-11-02 test(integration): cross-check firmware DT pins against the PCB netlist and pins.py
    tests/integration/test_pins.py walks every switch from its socket and diode
    nets through the RP2040 GPIOs to the firmware (row, col), col-offset,
    transform slot and layout.json key, and checks the TRRS TX/RX crossover,
    the display header against the PIO1 SPI pins and the right reversed
    col-gpios. It reads the committed boards and board files always, and the
    exported netlists and built zephyr.dts files when they exist.
    [fwdt.py, pcbdata.py, test_pins.py]
2026-11-02 ci(release): assemble the release assets and publish a pre-release on v* tags
    tests/integration/release.py packs the just-all outputs into dist/:
    per-side PCB zips (JLCPCB gerbers.zip, bom.csv, pos.csv, board STEP, Edge
    DXF), one UF2 per build.yaml row, case STEP and STL zips, SHA256SUMS.txt
    and release notes. Zips are deterministic; any missing input fails.
    release.yml runs only on v* tag pushes: it builds the firmware, both PCBs
    and the case, runs tests/integration with no skips, assembles dist/ and
    creates a GitHub pre-release.
    [release.py, test_release.py]
2026-11-02 test(integration): check gates G1 and G2 against the part drawings, add the G3 stock check
    test_gates.py compares the committed boards and layout.json with the
    nice!view and HRO PJ-320D drawings. The J3 pin order, the jack pad map,
    height and plug axis pass; the four findings that fail today (J3 pin 1
    under the module's CS pin, the module and viewing area offset from the
    model, the jack body 2.1 mm longer than the layout envelope) are strict
    xfails, so the fixes flip them.
    stock.py queries LCSC and the JLCPCB assembly library for every
    design.py LCSC number and fails on a shortfall or a discontinued part.
    [pcbdata.py, stock.py, test_gates.py]
2026-11-02 docs(changelog): add the rev A Unreleased entry and WS5 deviations
    The Unreleased section now covers the firmware, PCB, case, docs and the
    integration and release work, with the failing gates as known issues.
    docs/deviations.md records WS5-1 (no tag or release), WS5-2 (where the
    release assets are packed and built) and WS5-3 (gate findings as strict
    xfails). Also tidies two integration helpers.
    [stock.py, test_pins.py]
2026-11-02 docs(verification): record the integration results and gates G1-G3
    Clean-clone just all (34 min 44 s, both boards rebuilt byte-identical),
    the integration test results, CI on main, and the gates: G1 fails (J3
    pin 1 at the module's CS end, module and window offset from the
    nice!view drawing), G2 passes on pads, height and axis but the PJ-320D
    body is 2.1 mm longer than the case envelope, G3 fails on the
    discontinued hot-swap socket C2803348 and passes on track width. Each
    open item names its fix and owning stream.
2026-11-02 fix(firmware): keep the display SPI off UART0 TX and name both halves
    The pico-spi-pio driver muxes its MISO pin to PIO1 on the first transfer even
    when miso-gpios is unset, and its zero default is GP0, the wired-split TX line.
    Reuse MOSI (GP3) for miso-gpios on both targets, and move the ZMK_KEYBOARD_NAME
    default to both halves so the right-central build has a USB product name.
    The integration tests now read a missing miso-gpios as GP0 and fail when a PIO
    SPI pin lands on a UART, row or column pin.
    [fwdt.py, test_pins.py]
2026-11-02 fix(case): window on the LCD viewing area, Cherry stab cut-outs with the PCB holes
    The display window was centred at y 60.0, which hid the header end of the viewing area (gate G1)
    and left a 1.0 mm skin bar, unsupported for 15 mm, to the C6R1 key well. layout/display.py now
    centres it on the viewing area from the header position (y 56.54), so the bar is 4.5 mm and the
    window follows the header if gate G1 moves it.
    The 2u plate cut-outs were plain rectangles whose long half faced away from the PCB's 4.0 mm
    stabiliser holes, and the left top was not the mirror of the right. layout.stab_dir() now names
    the housing side for both the PCB and the case; stab_cuts() builds the Cherry cut-out (side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
    [worxboard-plate-left.dxf, worxboard-plate-right.dxf]
2026-11-02 fix(pcb): add KiCad-to-JLC rotation corrections to the CPL
    pos.csv carried raw KiCad rotations. Stage 13 now passes pcb/scripts/jlc_rotations.csv to kikit
    (--correctionpatterns): QFN-56 and SOIC-8 +270, SOT-23-5/6 -90 and the HRO TYPE-C-31-M-12 +180,
    the values of the current JLCKicadTools cpl_rotations_db.csv. The ordering guide lists them and
    keeps JLC's placement preview as the check for every IC, diode and connector.
    [jlc_rotations.csv]
2026-11-02 fix(pcb): decouple U1 at its supply exits, keep vias out of pads and copper from under Y1
    - Decoupling: on the left half C8-C13 and C18 reached U1 only through a 75-86 mm detour under the
    key field, DVDD 23 had no cap within 31 mm and VREG_VOUT's 1 uF was 13-17 mm away. The caps now
    sit in place.CLUSTER at the three 3V3 exits and the two 1V1 fan ends, and
    route_critical.decoupling() joins each to its exit, and its GND pad to its own via, with locked
    copper. checks.py measures pin -> cap and cap -> pin copper paths (<= 12 / 7 mm) and the GND vias.
    - Vias in SMD pads (15 left, 13 right, one cutting into U1 pin 43): the completion router keeps
    vias off every SMD pad, import_ses.py dro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
    [worxboard-left.kicad_pcb, worxboard-right.kicad_pcb]
2026-11-02 fix(case): name the drawing features after the PCB parts, update the order notes
    The CNC drawing and order remarks called the TRRS hole J1 and the USB-C notch U1, while the model
    log, jack_check and the PCB use J1 for the USB-C receptacle and U1 for the RP2040. The drawing now
    uses J1 (USB-C notch) and J2 (TRRS hole). ORDER_NOTES.md names the two gate items that still change
    the case (display pocket length, TRRS body length), says what the fit check covers, and tells the
    shop about the 1.0 mm stabiliser side notches and the 4.5 mm skin bar by the display window.
2026-11-02 docs: record the review fixes and bring the guides in line with verification.md
    - deviations.md: REVIEW-FIX-2 to -8 (decoupling, vias in pads, fit check envelopes, JLC
    rotations, display window, stabiliser cut-outs, crystal); CHANGELOG Unreleased "Fixed".
    - verification.md: a review-fixes section with the re-checks (both boards rebuilt byte-identical,
    DRC 0/0/0, checks.py 7/7, fitcheck 0 mm3, integration tests 88 passed / 6 xfailed); window
    item 3 closed; via and track counts of the re-routed boards.
    - buildguide: J3 pin 1 is the inner end on the right and the outer end on the left; the socket
    stack must lift the module 6.0-6.3 mm (a low socket or a soldered module hits the case); J3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
    [gen_docs.py]
2026-11-02 fix(pcb): commit the CI rebuild of the left board
    The rebuild job built a left board with the same copper as the committed one (every segment and
    via equal) but other UUIDs on part of the completion copper, so `git diff` failed. The cause is
    the completion router's shape cache, keyed by id(): ids of ripped items are reused, the new items
    get stale shapes, and which ids are reused depends on the host, so the CI runners took another
    path through the rip-up negotiation than a 16-thread local host. The committed left board is now
    the CI build (DRC 0 / 0 / 0, checks.py 7/7, renders, fab outputs and the fit check unchanged).
    Keying the cache by the item removes the host dependence but leaves the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
    [worxboard-left.kicad_pcb]
2026-11-02 fix(pcb): replace the discontinued hot-swap socket, flash and low-stock crystal
    JLC and LCSC have none of the Kailh hot-swap socket C2803348 (discontinued), JLC marks the
    flash C113767 no longer manufactured, and the crystal C91749 is down to 19. Same footprints,
    values and nets; checked against the JLC component records on 2026-11-02 23:35 UTC:
    - SK101-SK137: C41430893 (HanElectricity CPG151101S11-16, 231 751 at JLC; its drawing is the
    SW_MX_Hotswap_Kailh land pattern), second source C49352235
    - U2: C97521, the same W25Q128JVSIQ as a JLC basic part (76 588)
    - Y1: C49304726 (YXC 12 MHz 3225, CL 18 pF to suit the 27 pF caps, ESR 80 ohm; 13 833),
    basic fallback C9002
    Schematics regenerat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
    [worxboard-left.kicad_sch, worxboard-right.kicad_sch]
2026-11-02 fix(pcb): take U4's clamp reference from VSYS so nothing back-drives USB-C VBUS
    The USBLC6-2SC6 VBUS pin is the cathode of its upper steering diodes. On VBUS, a half running
    from VLINK with its USB device enabled pulled VBUS to about 2.5 V through the RP2040's D+
    pull-up and U4's I/O1 diode: J1 VBUS was back-driven and VBUS_SENSE read 1.25 V with no host.
    VSYS is the right rail for the reference: it is at or above every I/O level whenever the half
    has power (4.2-5.2 V from either source), below the 5.25 V stand-off, carries the 2 x 10 uF
    bulk, and D1 blocks any path from it back to the connector. 3V3 would put ESD energy on the
    RP2040 rail; the connector VBUS cannot be made back-drive free.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
    [worxboard-left.kicad_sch, worxboard-right.kicad_sch]
2026-11-02 feat(pcb): have JLC fit the display socket J3, a 5.0 mm THT socket
    For a turnkey order nothing may be left to solder. J3 is now in the JLC BOM and CPL as
    C27985230 (Hong Cheng HC-PM254-5.0H-1x5PZ, THT, hand-soldered by JLC, 6 399 in stock), the
    lowest 1x5 2.54 mm socket JLC stocks. The nice!view ships with a 5 mm socket and a male header
    that adds 2 mm, so a stock module with its own header plugs in unmodified at 7.0 mm.
    - design.py: J3 dnp=False, LCSC C27985230, value HC-PM254-5.0H-1x5PZ, footprint
    worxboard:PinSocket_1x05_P2.54mm_Vertical_H5.0mm (KiCad's pads, silk, courtyard and origin,
    so the stock footprint's JLC correction 0 / 5.08 / 270 still applies)
    - pcb/lib: that footprint an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
    [worxboard-left.kicad_sch, worxboard-right.kicad_sch]
2026-11-02 test(integration): check G3 stock against JLC's component record with a 50-unit floor
    stock.py now reads JLC's component detail (library type, SMT/THT, stock, attrition and the
    "no longer manufactured" note that caught C113767) next to LCSC's record. It needs
    max(50, 2 x (per board x boards + attrition)) of each LCSC number and fails on a short,
    discontinued, unknown or retired part (C2803348, C113767, C91749). On 2026-11-02 23:35 UTC
    all 21 numbers pass for 5 + 5 boards; the thinnest are C51118 (6 190), C27985230 (6 399),
    C2040 (7 062) and C95562 (5 743).
    test_stock.py checks offline that every part with a body is in the JLC BOM with an LCSC
    number (J3 included, nothing DNP), both halves s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
    [stock.py, test_stock.py]
2026-11-03 docs(deviations): hand off what the boards, docs and CPL still owe the ELEC changes
    ELEC-5 records, checked on 2026-11-03:
    - PCB: the four parity errors per half (U4 pad 5 VBUS -> VSYS; J3 footprint, value and DNP)
    that keep the pcb workflow red until both halves are re-placed and re-routed with their
    renders. CI run 41548543572 rebuilt both halves from the current schematics to 0 violations,
    0 unconnected, 0 parity errors. The left job was then OOM-killed in checks.py: copper_graph()
    makes edge weights of about -3e-17 where project() lands on a segment end, and dijkstra()
    loops on the negative cycle (C14 on the rebuilt left board). Clamping the weight at 0 makes
    checks.py pass 7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
2026-11-03 docs(deviations): record the board part check and the 2026-11-03 stock check (ELEC-6)
    kikit pairs the schematic's BOM with the board's CPL and copper, so the board must carry the
    ordered parts; netcmp.py --board now gates stages C and D. G3 re-checked at 01:09 UTC: all 21 LCSC
    numbers in stock at JLC (thinnest C95562 5 743, C51118 6 174, C27985230 6 399, C2040 7 057), with
    library type per line. Lists what the PCB stream's re-placement commit must hold for CI to turn
    green, and that J3 keeps pin n = nice!view pin n (G1 fixed by rotation).
2026-11-03 feat(pcb): fail stages C and D when a board's parts drift from design.py
    kikit takes bom.csv from the schematic, but pos.csv, its rotation corrections (by board footprint
    name) and the gerbers from the board, and KiCad's parity ignores the LCSC field. So a board that was
    not re-placed after a part swap still builds an order whose two halves disagree. Both committed
    boards are in that state: C2803348 x37, C113767, C91749 and the DNP stock-footprint J3.
    - netcmp.py --board <kicad_pcb> <side> [<kikit dir>]: every footprint is a design.py part with its
    footprint, value, LCSC and DNP/BOM/CPL flags (or a board-only STAB_ with no LCSC, out of BOM and
    CPL), no retired number; with kikit's outpu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
    [design.py, netcmp.py, stock.py, test_stock.py]
2026-11-03 docs(deviations): state the CPL rows FAB owes in full (ELEC-7)
    ELEC-1, ELEC-3 and ELEC-5 said the part swaps leave the JLC corrections "as they were" and that
    J3's correction "applies unchanged". That is true of the values only: kikit matches
    jlc_rotations.csv rows by board footprint name and falls back to 0/0/0, and the table has no row
    for worxboard:SW_MX_Hotswap_Kailh, J3 (either name) or the PJ-320D, while its QFN-56 and USB-C rows
    are wrong. The pos.csv built from the CI-rebuilt right board puts SK101 at its switch centre at
    0 deg, 3.86 mm off and turned 180 deg; 41 of 119 parts per half are wrong.
    ELEC-7 lists every row FAB needs with its evidence (research corrections.json, CPL revie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
2026-11-03 feat(pcb): stop stages C and D when J3 would meet the nice!view reversed
    G1 item 1 (J3 pin 1 at low x, so a plugged-in nice!view gets SCK on GND and MOSI on CS) was only a
    strict xfail in test_gates.py, which push CI does not run: nothing kept such a board out of an
    order.
    netcmp.py --board now reads J3's pad positions and checks that pad n lies within 0.05 mm of pin n
    of a nice!view plugged in LCD up: the module runs from J3 toward the case window centre
    (layout.display), and its front view has MOSI..CS left to right with the header at the bottom.
    Stage C (pcb-finish, CI rebuild) and stage D (pcb-fab, CI board) both run it. It checks the turn,
    not the row position, so G1 item 2 stays open.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
    [netcmp.py]
2026-11-03 docs(deviations): record what CI run 41563465072 shows after the J3 check (ELEC-8)
    The schematic job and the layout, firmware and case workflows pass. The board jobs stop at the
    4 parity errors per half of the stale boards. The left rebuild is killed for memory in checks.py.
    The right rebuild reaches DRC 0/0/0, checks.py and the board part check, then stops at the new J3
    check in pcb-finish rather than at the comparison with the committed board. Its board is
    byte-identical to the rebuild of run 41548543572.
2026-11-03 feat(pcb): turn J3 to the nice!view pin order and re-route both halves
    J3 pin 1 (MOSI) now sits at high x on both halves (right x 77.47, left
    x 192.69) on the module's header row, y 39.925 (gate G1 items 1 and 2).
    Both boards are re-placed and re-routed from the ELEC schematics.
    - complete_routes: key the dilation cache by the item, not id(), so a
    rip-up can no longer hand new copper a freed item's shape; the left
    board now rebuilds the same on any host (left base seed 0x3)
    - place: seed the KIIDs only from the layout data the board uses
    - prune.py (stage C): delete, trim or merge dangling rip-up copper
    - C2 moves to U4's VSYS reference pin with locked copper (4.07 mm)
    - checks: clamp c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
    [worxboard-left.kicad_pcb, worxboard-right.kicad_pcb]
2026-11-03 chore(tools): record the kicad/kicad:10.0.7-full digest
    The -full image renders and exports the STEP (WS2c-2); its digest was
    left as a placeholder comment.
2026-11-03 docs(deviations): record the re-placed and re-routed boards (BOARD-1 to BOARD-8)
    J3 turned and moved onto the nice!view header row, the host-independent
    completion router and the left seed 0x3, the layout-only board seed,
    the dangling-copper clean-up, C2 at U4's VSYS reference, the checks.py
    clamp, the JLC DFM figures (rails with a routed gap needed) and the
    results, with CI run 41577492203 green on bf7a642.
2026-11-03 test(integration): drop the G1 strict xfails that bf7a642 fixed
    J3 pad 1 is now at high x on both halves and the module spans the pocket
    (deviations BOARD-1), so test_g1_module_pins_land_on_their_nets and
    test_g1_module_fits_the_pocket pass and their strict markers failed the
    suite. The file's rule: the fix removes the marker.
    [test_gates.py]
2026-11-03 feat(pcb): join U1's exposed pad to the B.Cu plane with a locked spoke to the edge
    The left board of 4e5fc30 hung the RP2040's only GND pin (the exposed pad) on one
    completion via: its B.Cu copper was a 57.7 mm2 island ringed off by routes, and DRC's
    0 unconnected hid it. route_critical now lays a locked 0.5 mm B.Cu GND spoke from the
    pad's via array to the board edge on the side of U1 that faces the back edge, where no
    fan-out runs, so no route can pass between (EP_LINK): on the right up under the 3V3
    exit through the north caps' GND via row and on to the edge, with the east caps' row
    fed into the GND fill under the USB pair; on the left (U1 turned 180 deg) down under
    XIN into the fill unde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
    [worxboard-left.kicad_pcb, worxboard-right.kicad_pcb]
2026-11-03 docs(deviations): record the U1 GND spoke, the G2 hand-off and the new board numbers (BOARD-9 to BOARD-11)
    BOARD-9 corrects BOARD-2: the left GND island near U1 had not gone away, it hung on
    one via. It records the per-side spoke, the gate, what was tried and dropped, and
    that the left caps' GND vias still sit in islands (a rev B placement change).
    BOARD-10: the G2 layout half is ready but needs CASE's relief cut in the same
    commit. BOARD-11: the result table after the re-route.
2026-11-03 fix(ci): compare the committed PCB renders pixel by pixel (BOARD-12)
    KiCad's raytracer varies 0-4 pixels of the left top view by a level or two from run
    to run, so the byte check of docs/images/pcb-<side>-*.png failed d640d7c's left board
    job at random. just pcb-render-check compares the fresh renders with HEAD's: same
    size, at most 64 pixels off by at most 8 levels per view.
    [render_check.py]
2026-11-03 feat(layout,case): give the PJ-320D its drawing size and relieve it in the case (G2, BOARD-13)
    J2's layout envelope is 14.1 x 6.1 x 5.0 (was 12.0 x 6.0 x 5.5). The body
    runs 0.9 mm past Z_TRRS under the plate between C6R1 and C6R2, so the
    case relieves J2's body + 0.5 mm in the top part (through the well skin
    and the plate), the spacer and the plate DXF. The boards are unchanged.
    [worxboard-plate-left.dxf, worxboard-plate-right.dxf]
2026-11-04 fix(pcb): clear the right board's last unlocked dangling stubs (BOARD-14)
    prune.py replaces a via that joins one layer only even when its joins differ from the copper they
    replace by slivers, narrowing a join that would poke out (>= 0.15 mm); trims an overhang by KiCad's
    own half-width rule; splits a track where another one's end meets it part-way (a T junction); and
    exits 1 if any unlocked item still dangles, so stage C fails on it.
    The right board loses its 5 unlocked dangling items (one-layer vias on 3V3, DISP_DC and ROW1, a
    ROW2 jog, a TP5 overhang); a from-scratch rebuild of the left gives the committed board unchanged.
    [worxboard-right.kicad_pcb]
2026-11-04 feat(pcb): give every U1 cap a short GND return to the exposed pad on both halves (BOARD-14)
    - testen_via(): the TESTEN pad (pin 19, GND, joined to the exposed pad on F.Cu) runs on out between
    pins 18 and 20 to a locked B.Cu via at the GND fill under Y1, which reaches the back edge. On the
    left it replaces the B.Cu spoke under XIN, which walled off every route under U1's south side.
    - ep_caps() on both halves: locked B.Cu spurs from the exposed pad's vias to every U1 cap's GND via
    (north row with C16/C19, east row into the USB pair's GND fill, a diagonal to C8/C9, C17 into the
    Y1 fill). The right keeps its spine to the back edge.
    - Left base seed 0x4 (WS2c-4); the right keeps 0x1.
    -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
    [worxboard-left.kicad_pcb, worxboard-right.kicad_pcb]
2026-11-04 docs(deviations): record the short U1 cap GND returns, the TESTEN via and the dangling clean-up (BOARD-14)
2026-11-04 fix(fw): wait 64x longer for the rev A crystal to start
    Y1 is now the YXC XL2EL89CRI-111YLC-12M (C49304726, ESR 80 ohm, ELEC-1), not
    the Pico's Abracon ABM8-272-T3 that the Pico SDK's 1 ms XOSC start-up delay is
    tuned for. Set the xosc startup-delay-multiplier to 64 (about 64 ms), as
    Zephyr's RP2040 boards with other crystals do (xiao_rp2040, qt_py_rp2040,
    kb2040). The RP2350A target has no hardware and is left as it was.
2026-11-04 feat(fw): turn both displays to portrait for the upright nice!view
    The module stands in J3 LCD up with its header at the back of the board and
    its flex toward the user, the same way on both halves (G1, BOARD-1), but both
    screens were laid out for a 160 x 68 landscape panel, so they read turned a
    quarter.
    Panel x = 0 is the header end: ZMK's nice_view widgets, drawn for the
    nice!view's own upright view (header at the bottom), put their top canvas at
    x 92..159 and turn it a quarter clockwise, and nicekeyboards.com shows that
    screen upright with the header at the bottom. worxboard shows the module
    turned 180 deg from that view, so LVGL now lays out a 68 x 160 portrait
    screen and src/worx_displ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
    [fw_check.py]
2026-11-04 fix(pcb): prove every CPL placement against JLC's own footprint (PKG)
    jlc_rotations.csv now holds a row for every footprint whose JLC (EasyEDA /
    JLCEDA library) footprint differs from KiCad's in origin or zero angle:
    QFN-56 0 (was 270), USB-C 0;-1.394;0 (was 180), PJ-320D 0.776;0;90,
    hot-swap socket 0.635;3.81;180, J3 socket 0;5.08;270; SOIC-8 270 and
    SOT-23-5/6 -90 unchanged.
    cpl_check.py places JLC's footprint of each LCSC part (jlc_footprints.json,
    fetched by jlc_footprints.py from the lceda.cn API and cross-checked against
    LCSC's footprint SVG) where the CPL puts it, on either side, and gates:
    placement within 0.1 mm of the best fit on pegs/barrels or pads, every pin
    on the same KiCad p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
    [jlc_rotations.csv]
2026-11-04 feat(case): make the case orderable: display bezel, JLCCNC thread depths, TPU cap tree (CASE-1 to CASE-5)
    - Display (G1, ELEC-3): J3 is the 5.0 mm socket JLC fits and a stock nice!view
    sits on its own header, so its glass reaches 9.75 mm above the PCB. The pocket
    now rises to Z 18.6 (glass + 0.25) under a raised bezel (Z 17.6-19.6, 1.0 mm
    skin), flush with the key well on its C6R1 and C5 sides. display_check gates
    the stack, the skin and the bezel; check_fit's J3 + display envelope is the
    socket, header and module up to the highest glass (the old 16.8 ceiling
    would interfere by 138 mm3).
    - Threads: every blind hole keeps >= D/2 unthreaded (JLCCNC guideline). Edge
    bosses: drill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
2026-11-04 feat(pcb): commit the JLC turnkey order package of both halves (PKG)
    Stage P (stage_p.sh, `just pcb-production <side>`) builds
    pcb/production/<side>/ from the committed board:
    - KiKit panel (panel.json, panel_tabs.py): the board in a tight frame with
    6 mm rails and a 2 mm milled slot, 14 (left) / 15 (right) mouse-bite tabs
    on straight edges at least 1.5 mm from every courtyard and 2.7 mm from J1
    and J2, 3 fiducials per side (1 mm copper, 2 mm opening, 4 mm from the
    edges), 4 NPTH tooling holes of 2 mm. 198.84 x 174.75 mm, inside JLC's
    250 x 250 mm Standard PCBA panel limit. Panel DRC: 0 errors, 0 unconnected.
    - gerbers.zip, bom.csv (Comment,Designator,Footprint,LCSC Part #) and
    c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
    [bom.csv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]
2026-11-04 feat(case): commit the JLCCNC / JLC3DP order package in case/production, checked in CI (CASE-6)
    case/production holds what the case order needs: jlccnc/ (STEP + PDF drawing
    per machined part, hole_table.csv), jlc3dp/ (the spacers and the leg cap tree
    as STL) and hardware.csv (screws, feet, leg thumbscrews and washers), next to
    the hand-written README and order notes. `just production` copies a fresh
    `just order` in; `just production-check` (case workflow) fails if a generated
    file differs: CSVs byte for byte, STEP/STL/PDF by bytes or, if only the bytes
    differ, by volume/area/faces/bbox, triangles/volume/bbox and pages/text.
    The package is reproducible: STEP files carry the revision date and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
    [hardware.csv, hole_table.csv, worxboard_left_bottom.step, worxboard_left_spacer.stl, worxboard_left_top.step, worxboard_leg.step, worxboard_leg_cap_tree.stl, worxboard_right_bottom.step]
2026-11-04 fix(pcb): size the panel mouse-bites as JLC's guide asks (PKG)
    JLC's mouse-bite guide wants 0.6 mm holes, 5-8 per set, 0.35-0.4 mm from
    hole edge to hole edge, a third of each hole in the board. The tabs are now
    5 mm wide with six 0.6 mm holes 1 mm apart, centred 0.1 mm outside the
    board edge (0.2 mm of each hole in the board, 0.3 mm from the GND pour);
    they were 0.5 mm holes 0.8 mm apart (0.3 mm edge gap, JLC's floor). Both
    panels keep 14 tabs, 1.4 mm or more from every courtyard, 2.1 mm or more
    from J1 and J2; panel DRC 0 errors. jlc_check measures the tab clearance
    with the real hole radius.
    [jlc_check.py, panel_tabs.py]
2026-11-04 fix(case): relieve the display pocket corners for the cutter (CASE-1)
    The pocket is 11.6 mm deep from the parting face, so JLCCNC's cutter (R = depth
    / 10, rounded up: R1.5) would leave fillets in its corners within 0.09 mm of
    the nice!view's corners, which sit 0.5 mm from each wall. Each corner now has
    an R1.5 dog-bone through the corner point (0.44 mm into the walls); the model
    probes the corners open, the drawing and order notes say to keep them, and
    case/production is regenerated.
    [hole_table.csv, worxboard_left_top.step, worxboard_right_top.step]
2026-11-04 docs(deviations): record the orderable case (CASE-1 to CASE-7)
    The raised display bezel over the stock nice!view stack and its corner
    reliefs, the re-checked TRRS relief, the JLCCNC thread depths and shorter
    screws, the TPU cap tree, the MJF-safe spacer, the committed order package
    and its CI check, and the results, with the hand-offs to LAYOUT and DOCS.
2026-11-04 docs(pcb): say in the order README what to do if JLC's bottom preview is turned (PKG)
    The bottom-side CPL rows follow the KiKit / kicad-jlcpcb-tools / KiBot
    convention, which JLC does not document. The README now says how a changed
    convention would show in the preview (every socket and diode turned 180°)
    and to report it in the placement confirmation instead of editing the files,
    and that the form's option names may be worded differently.
2026-11-04 fix(case): give every internal corner JLCCNC's radius for its depth; R2 display-pocket dog-bones (CASE-8)
    JLCCNC's CNC Machining Design Guideline asks for R >= H/10 + 0.5 (tool D = H/5), with its tool
    table past 10 mm (Ø2 reaches 10 mm, Ø3 has Min R 2). corner_r() used "depth / 10", so the
    display pocket D1 (11.6 mm deep) had R1.5 dog-bones JLCCNC cannot cut, and every modelled wall
    fillet and relief corner sat below the minimum.
    - corner_r(): R0.5 to 3 mm, H/10 + 0.5 rounded up to 0.5 to 10 mm, the table's Min R past it.
    Top web and leg-pad fillets R1.0 -> R1.5, bottom web fillets R0.5 -> R1.0, leg joint
    R1.0 -> R1.5; the leg boss root (a floor fillet) keeps R0.5.
    - D1: R2 dog-bones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
    [hole_table.csv, worxboard-plate-left.dxf, worxboard-plate-right.dxf, worxboard_left_bottom.step, worxboard_left_spacer.stl, worxboard_left_top.step, worxboard_leg.step, worxboard_right_bottom.step]
2026-11-04 ci(case): check every internal corner of the machined parts against JLCCNC's rule (CASE-8)
    case/corner_check.py (just corners, a step of the case workflow) reads the five machined STEPs,
    finds every vertical internal corner (concave Z-cylinder faces that are not holes, sharp concave
    vertical edges, vertices of polygonised arcs), ray-casts the face its cutter enters by, and fails
    if its radius is below corner_r() of that depth. The switch / stabiliser cut-outs (R0.5, 1 mm
    end mill), the engraved side mark and side operations are exempt and listed.
    It fails the A1 package on 192 corners (the R1.5 D1 dog-bones among them) and passes A2.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
2026-11-04 docs(deviations): correct CASE-1's corner rule and record CASE-8 (JLCCNC radius-for-depth, case A2)
    CASE-1 gave the display pocket R1.5 dog-bones from "depth / 10", which is not JLCCNC's rule
    (R = H/10 + 0.5, tool table past 10 mm: Ø3, Min R 2 at 11.6 mm). CASE-8 records the rule, the
    corners it moved (D1 R2 dog-bones, wall fillets, relief pockets, the key-well island), the new
    corners gate, and the A2 result.
2026-11-04 fix(case): keep the TRRS jack's corners 0.38 mm clear of the top and gate it (CASE-9)
    In A2 the top's relief round J2 came within 0.022 mm of the jack body's two
    far corners, at plate level on both halves: relief_poly() opens the union a
    second time with 4-chord arcs, which pulled jack_relief_poly()'s R1.5 corners
    (0.084 mm) in further. A plate edge bearing on the jack would load its SMD
    joints once the case is screwed shut.
    - J2_RELIEF_CLEAR 0.5 -> 0.75: the body keeps 0.75 mm on its sides and, at
    its corners, 0.376 mm in the top and 0.431 mm in the spacer and the plate
    DXF. The plate keeps 4.4 mm to the C6R1 / C6R2 switch cut-outs.
    - New gate JACK_MIN_CLEAR = 0.3 mm: jack_check fails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
    [worxboard-plate-left.dxf, worxboard-plate-right.dxf, worxboard_left_spacer.stl, worxboard_left_top.step, worxboard_right_spacer.stl, worxboard_right_top.step]
2026-11-04 docs(deviations): correct CASE-8's J2 corner clearance and record CASE-9 (case A3)
    CASE-8 said the J2 body's corners keep 0.08 mm to the relief. That held only
    for the spacer and the plate DXF; in the top it was 0.022 mm. CASE-9 records
    the 0.75 mm relief (corners 0.376 in the top, 0.431 in the spacer and plate),
    the JACK_MIN_CLEAR gate, the independent STEP/STL/DXF measurements and CI.
2026-11-04 docs(ordering): rewrite the JLCPCB guide as a step-by-step turnkey order; add the shopping list
    ordering-jlcpcb.md now walks one turnkey order of both halves from
    pcb/production/<side>/ (the customer panel by default): every PCB and PCBA
    form field (Standard, both sides, Panel by Customer, tooling holes and
    rails/fiducials added by customer, Confirm production file and Confirm parts
    placement), the parts-page and placement-preview checks per part type with
    the cpl-*.svg overlays, the customs product description, the engineering
    questions, out-of-stock alternates (only C49352235 and C9002 are drop-in;
    the 5.7 mm J3 sockets break the display pocket at full tolerance), and a
    cost estimate dated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
2026-11-04 docs(verification): record G1-G3 as passed, with the order package and board evidence
    Re-checked on 2026-11-04 at f4c95bb: integration tests 111 passed with no
    expected failures; CI green on all four workflows (pcb run 41774485196, all
    10 jobs); jlc_check 11/11 (left, with live stock) and 10/10 (right);
    cpl_check 119/119 per half (CI); the order package rebuilds byte for byte.
    G1 PASS: J3 pin 1 at high x and gated in stages C/D (BOARD-1, ELEC-8), the
    header row at y 39.925, the 5.0 mm J3 stack under the raised bezel (glass
    <= 9.75 mm, ceiling 10.0 mm, CASE-1), fit check 0 mm3. G2 PASS: the
    14.1 x 6.1 mm body relieved by 0.75 mm, corners >= 0.376 mm, gated by
    JACK_MIN_CLEAR (CASE-9). G3 PASS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
2026-11-04 docs(bom): generate the BOM from the turnkey parts and mark G1-G3 passed
    site/gen_docs.py's hand-kept LCSC table follows design.py again (ELEC-5):
    C97521 (basic), C49304726, C41430893 and C27985230 (extended, THT) added,
    C113767, C91749 and C2803348 dropped, and C51118, C1557 and C2909343 marked
    extended as JLC's records say. J3 leaves NOT_ASSEMBLED. The former [G3]
    flags become [J] (checked against JLC's record and footprint). The J3 prose
    in pinout.md now says pin 1 at high x, fitted by JLC (BOARD-1, ELEC-8).
    docs-gen crashed with KeyError: 'C97521' before this.
    bom.md: JLC fits every part, no hand soldering on the PCB; stock of
    2026-11-04; the CPL corrections proven by cpl_check (replace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
    [gen_docs.py]
2026-11-04 docs(buildguide): nothing to solder on the PCB; plug in the displays, switches and keycaps
    JLC now fits J3 (ELEC-3), so step 4 becomes "Plug in the displays": solder
    the header to the nice!view, trim the pins flush on the glass side (CASE-1),
    plug it in LCD up reaching toward the user, and the ROTATION_270 fallback if
    the portrait screens read upside down (WS1-7). Step 1 breaks the board out
    of the panel and sands the tabs flush. The parts list, the screws (M2.5 x 12
    and x 10, CASE-3), the leg washers and caps, the case test print and the
    troubleshooting rows follow the case A3 package.
2026-11-04 docs(case, legs): describe the orderable A3 case package
    case.md: the package in case/production (JLCCNC, JLC3DP, hardware.csv); the
    raised display bezel and the Z 18.6 pocket over the 5.0 mm J3 stack
    (CASE-1); the J2 body relieved by 0.75 mm with corners >= 0.38 mm and the
    JACK_MIN_CLEAR gate (CASE-9, replacing the pre-G2 row); internal corners per
    JLCCNC's radius-for-depth rule and just corners (CASE-8); blind threads and
    the M2.5 x 12 / x 10 screws (CASE-3); the spacer in MJF PA12 and the cap
    tree (CASE-4, CASE-5); the fit check's J3 model and 9.75 mm envelope.
    legs.md: drill and full-thread depth per mount with the maximum screw reach,
    the M3 x 12 thumbscrew needing its friction washer,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
2026-11-04 docs(firmware, electrical): portrait displays, U4 on VSYS, J3 fitted, U1 ground returns
    firmware.md (from WS1-7 to WS1-9): both screens laid out portrait and turned
    onto the panel by worx_display_rotation.c (LV_DISPLAY_ROTATION_90), the
    ROTATION_270 fallback as the one hardware-unverified assumption, the right
    screen's paper/ink and 8 KB heap, the xosc start-up delay, fw-rotate-check
    and fw-check on both core rows. The landscape known issue is gone.
    electrical.md: U4's clamp reference on VSYS with C2 at the pin, so VBUS is a
    clean presence signal (ELEC-2, BOARD-5); the YXC crystal (ELEC-1); U1's
    cap GND returns <= 13 mm and the TESTEN via (BOARD-14); J3 as the fitted
    5.0 mm socket with pin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
2026-11-04 docs(deviations): record WS1-7 to WS1-9, PKG-1 to PKG-4 and DOCS-1
    WS1-7 to WS1-9 from the FW commits 876847c, 4769d4d and 5fd74ae: portrait
    screens turned in the LVGL flush (hardware-unverified, ROTATION_270
    fallback), the right screen's paper/ink and 8 KB heap, the 64x XOSC delay.
    PKG-1 to PKG-4 from the PKG commits: the customer panel (rails, 14
    mouse-bite tabs, fiducials, 2.0 mm tooling holes), CPL corrections derived
    from JLC's own footprints and proven by cpl_check (supersedes REVIEW-FIX-5
    and ELEC-7), JLC's file formats and byte-reproducible packages, and
    pcb/production force-added on main with release.yml still open.
    DOCS-1: the ordering docs, no drop-in alternate for J3 (a 5.7 mm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
2026-11-04 docs(readme, changelog): add "Order it" and record the turnkey work
    README: the status is "orderable, not yet built" with G1-G3 passing; a new
    "Order it" section links the JLCPCB packages (pcb/production/left, right),
    the JLCCNC and JLC3DP folders, hardware.csv and the shopping list, with the
    2026-11-04 cost estimate; the status table, specs (119 parts per half, the
    19.6 mm bezel), pipeline diagram, artifacts, recipes and known issues follow
    the order packages. The broken #placement-preview link is gone.
    CHANGELOG Unreleased: the order packages, cpl_check, the board part and J3
    gates, the case package, the portrait displays and the new docs (Added);
    the part swaps, re-placed boards, CPL row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
2026-11-04 docs(site): update the microsite status text for the orderable rev A
    The hero warning, the status table (PCB and case orderable, gates pass), the
    known issues and the file links now match verification.md and the order
    packages; the viewer labels J3 as the JLC-fitted 5.0 mm socket and the
    sockets as CPG151101S11-16, and lists the shopping list among the docs.
2026-11-04 docs(ordering): say no inserts are needed and how JLC marks PCBs now
    The case needs no threaded inserts (every thread is tapped in the top).
    JLC adds no mark on the PCB by default and dropped its order-number option
    in 2026-05 (its marking help page, updated 2026-05-22).
2026-11-04 fix(case): stabiliser wire channels, collarless leg thumbscrews, extended USB-C plugs, Strict anodize
    The plate spacers get a channel on both sides of each 2u key for the
    Cherry stabiliser wire, and spacer_check() keeps it open (ORDER-6). The
    build guide fits the stabilisers into the upturned top shell before the
    case is closed (ORDER-8). hardware.csv and the docs name a DIN 653
    thumbscrew only: a DIN 464's collar sits in the leg's counterbore and the
    screw reaches 8 mm into a 3.7 mm thread (ORDER-5). The USB-C cable needs at
    least 8 mm of bare plug shell, since the recess floor is 1.7 mm in front of
    J1's mouth (ORDER-7). The JLCCNC notes ask for the Strict appearance tier
    (ORDER-9).
    Co-Aut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
    [hardware.csv, worxboard_left_spacer.stl, worxboard_right_spacer.stl]
2026-11-04 fix(pcb): name the thumb parts as the bottom-convention tell, remark the stabiliser holes
    The preview warning said a different JLC bottom-side convention would turn
    every socket and diode by 180 degrees. A viewer that turns bottom parts the
    other way leaves the 62 parts at 180 degrees as they are and turns only the 12
    thumb parts SK132-137 and D132-137 by about 50 degrees; they then need 360
    minus the CPL value. jlc_check.py facts lists the bottom parts off 0/180 and
    package.py writes the check from it (ORDER-2).
    Two STAB_T4/STAB_T5 hole pairs per half leave 0.285 mm between them, under
    JLC's 0.45 mm pad hole-to-hole spacing. jlc_check.py facts measures every
    pad-hole pair and fails on any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
    [jlc_check.py, package.py]
2026-11-04 fix(pcb): tie the left U1 ground to the planes, gate its links and the U2/U4 GND paths
    On the left half the RP2040's whole ground domain (exposed pad, 11 caps,
    flash pin 4, USB ESD pin 2) met the board planes through one 0.15 mm track
    and the TESTEN via; deleting that via left GND unconnected. checks.py now
    gates at least 2 separate EP links over ~0.4 mm copper, U4 pin 2 -> J1 GND
    and C5 -> U2 pin 4 (<= 30 mm each), on a shared GndRaster.
    gnd_ties.py runs in stage C after the DRC gate: while a gate fails it routes
    locked 0.5 mm GND ties (links from the EP's own copper, pad-to-pad, pad vias,
    EP wedges), re-routing what they cross, and keeps a tie only if every net
    closes and the gates improv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
    [worxboard-left.kicad_pcb]
2026-11-04 fix(pcb): put J1's shell legs on the paste layer and ask JLC to solder them
    J1's four GND shell legs are plated slots that the stock footprint keeps off
    the paste layer, so JLC's stencil would not open them and nothing in the order
    asked for them. pin_in_paste.py adds F.Paste to the four SH pads at the end of
    stage C, after routing (doing it in place.py changes the KIID seeds and
    re-routes the board), and checks.py gates it. Both PasteTop gerbers now carry
    the four ovals; copper, drills, BOM and CPL are unchanged.
    The panel and bare-board remarks, ordering-jlcpcb.md and its questions table
    ask JLC to solder the legs, and the build guide checks them (ORDER-1). Both
    boards, renders and order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
    [worxboard-left.kicad_pcb, worxboard-right.kicad_pcb]
2026-11-05 docs(readme): redesign the README with a gallery, specs and a build journey
    Rewrite README.md as a styled landing page for the repo: a centred hero with
    the CI, tech and rev A status badges, a not-built warning, headline stats, a
    contents grid, and sections for the gallery, features, specs, layout and
    matrix, the 3D viewer, a zero-to-typing path, ordering, building, firmware,
    the case, the generation pipeline, build from source, CI artifacts, known
    open issues, future work, the repo tree, the docs index, credits and the
    licence.
    Every image in docs/images and case/renders is shown or linked with a
    caption (the CPL proofs in a collapsible gallery). Two mermaid charts show
    the power path and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
2026-11-05 feat(site): redesign the microsite and drop the concept sketch
    The microsite gets specs, build, order, firmware, case Z-stack and pipeline
    sections, a gallery with filters, a lightbox and a caption for every render
    and placement proof, Iso / Top / Front / Side camera presets and fullscreen.
    Page content now lives in page.js, apart from the three.js viewer, so it
    still fills in without WebGL; the viewer renders only while it is on screen.
    docs/images/concept-annotated.png (notes over an ErgoDox EZ image, not a
    worxboard image) is removed from the repo, the README and the site gallery.
    The README now links the live GitHub Pages site instead of saying it is not
    hosted.
    Checked: headless Chrom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
    [build_site.py]
2026-11-06 fix: address project review findings
    Compare manufacturing geometry and rendered drawings, reuse viewer scenes, accept both portrait display rotations, and tolerate PCB render noise in releases. Add regression tests, CI checks, and documentation.
    [fw_check.py]
2026-11-08 wip(revB): per-key RGB, paused before the left board passes
    Rev B puts an SK6812MINI-E under every switch, adds the SY6280 LED
    supply, and sets the case window back 1 mm. The right half routes
    clean at seed 0x1. The left half does not. route_critical now locks
    the USB clamp ground from U4 pin 2 to the J1 shell. Seeds 0xA and 0xB
    were stopped during Freerouting. Resume from PLAN.md. The tracked
    pcb/production files are still the rev A order package.
    [hole_table.csv, worxboard-left.kicad_pcb, worxboard-left.kicad_sch, worxboard-right.kicad_pcb, worxboard-right.kicad_sch, worxboard_left_bottom.step, worxboard_left_top.step, worxboard_leg.step]
2026-11-12 feat(case): revision A5 with U-slot connector openings and PCBWay CNC notes
    The USB-C and TRRS openings become U-slots so a plug with a wide
    overmould seats fully, T1 and T5 are tapped through, and the drawings
    carry tolerances. Adds an order-notes file for PCBWay CNC beside the
    JLC one. The fit check runs against the rev B PCB STEP models with
    0 mm3 interference (deviation CASE-10).
    Claude-Session: https://claude.ai/code/session_01UHqXMtGKYMKdeKWuQyZP2Y
    [hardware.csv, hole_table.csv, worxboard_left_bottom.step, worxboard_left_top.step, worxboard_leg.step, worxboard_right_bottom.step, worxboard_right_top.step]
2026-11-12 feat(pcb): route rev B on four layers with the in-house maze router
    The two-layer rev B boards never passed the finish stage on the left
    half: every failing gate was a ground-return path that depended on
    where the autorouter left pour copper, and Freerouting oscillated
    without converging. Rev B is now a four-layer board with a solid GND
    plane on In1 and a VLED plane on In2, each LED cell is locked scripted
    copper, and Freerouting is removed from the pipeline (REVB-8).
    The maze router closes both halves after three changes: it may cross
    the In2 plane at three times the cost of an outer layer, the lane
    ahead of each U1 fan-out stub costs extra for other nets in every
    pass, and the late comple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
    [bom.csv, centroid-bare-board.csv, centroid-panel.csv, worxboard-left.kicad_pcb, worxboard-left.kicad_sch, worxboard-right.kicad_pcb, worxboard-right.kicad_sch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]
2026-11-12 docs: add a guide to soldering the boards at home
    The ordering guides cover factory assembly only. A builder who wants bare
    boards and loose parts had no page saying which of the 201 parts per half
    need solder paste and reflow (the RP2040, the USB-C socket and the
    crystal), which files to order from, and in what order to work.
    The page is written from the generated BOM and the bare-board package. It
    states that the path is untested: no board has been built this way, and
    the repository's checks cover the factory files only.
    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
2026-11-12 feat(site): redesign the microsite as a product page and a build guide
    The old page was one long technical document with the 3D viewer in a box,
    and its hero still reported rev A results. It did not present the keyboard
    as a product, and every guide link left the site for GitHub.
    Product page: the hero and five chapters share one WebGL canvas that the
    scroll position drives (case, lights, display, exploded stack, tent legs).
    The viewer now draws rounded keycaps, the LEDs with the four ZMK underglow
    effects through a bloom pass, and a keycap set per case finish. The free
    viewer stays as its own section. The page states that the project is free
    and open source, with both licences, and reports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
    [build_site.py]
2026-11-12 chore(release): cut 0.2.0-revB
    Rev B's gates had passed locally, and the docs still listed the CI
    rebuild as open. The pcb workflow has since passed on c942e7b, with both
    from-scratch rebuild jobs equal to the committed boards, so
    verification.md and the README status lines now record that. The stock of
    the BOM lines stays open by its nature: it is checked on the order day.
    CHANGELOG: the Unreleased entries become [0.2.0-revB]. The section also
    carries rev A's entries, because the v0.1.0-revA pre-release never cut
    one. The known issue about release.yml packing raw fab files is removed:
    release.py publishes the committed order packages.
    pyproject and uv.lock move to 0.2.0, the version the t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
2026-11-12 feat(site): show the board's four copper layers on the product page
    Rev B moved from two copper layers to four, and the site only said so
    in one line of the specs. The new "Four layers of copper" section shows
    the left board's copper as a stack pulled apart or one layer at a time,
    with a cut through the board and a plain account of why the ground
    needed a sheet of its own.
    The figures beside each layer (track segments, length, nets, vias) are
    read from the committed board on every build by site/pcbdata.py, so
    they cannot go stale. The drawings are KiCad's own plot of each layer:
    `just pcb-layers <side>` writes them to build/<side>/layers/, which is
    not committed. They are optional, like the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
