w0rxbend/worxboard/(notices)

Notices in the files:
README.md:
License: GPL v3
License: CERN-OHL-S-2.0
